Hyperwiper/Hyperwiper/hardware/Hyperwiper 2020/Screenshot from 2020-07-30 18-22-11.png

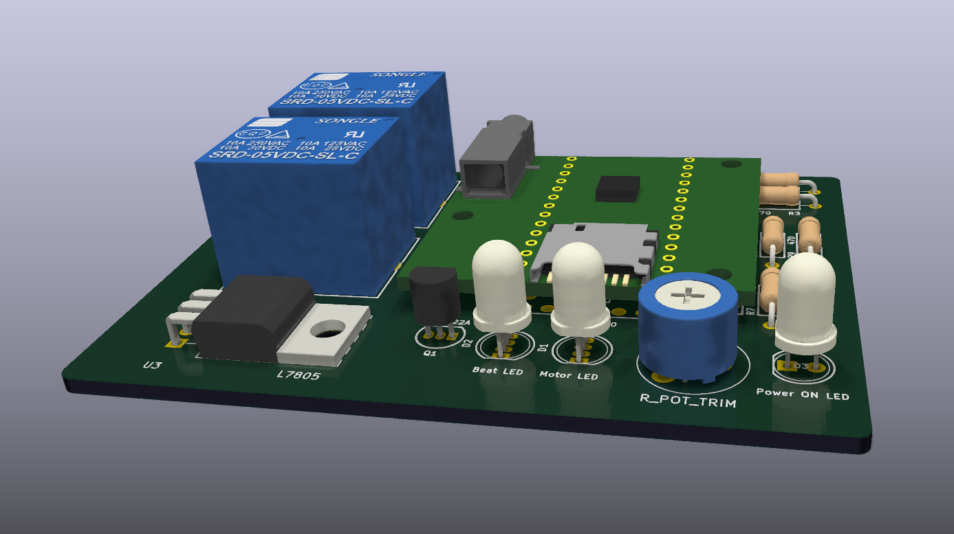
hardware/Hyperwiper 2020/Screenshot from 2020-07-30 18-22-11.png
