Hyperwiper/Hyperwiper/hardware/Hyperwiper 2020 production prototype/2020-07-30 Hyperwiper 3D board draft.png

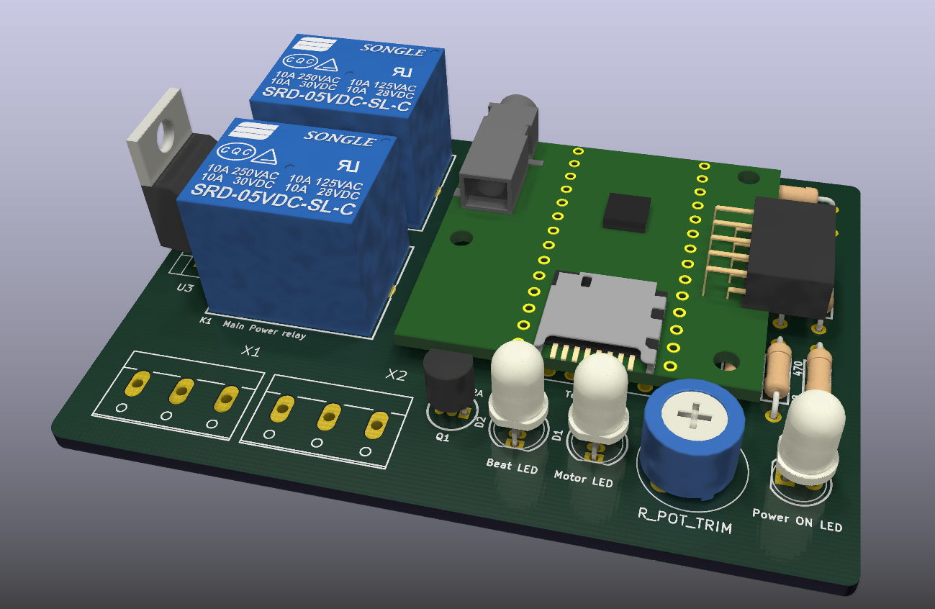
hardware/Hyperwiper 2020 production prototype/2020-07-30 Hyperwiper 3D board draft.png
