Hyperwiper/Hyperwiper/docs/2020 presentation /Hyper wiper audio timing flow chart.png

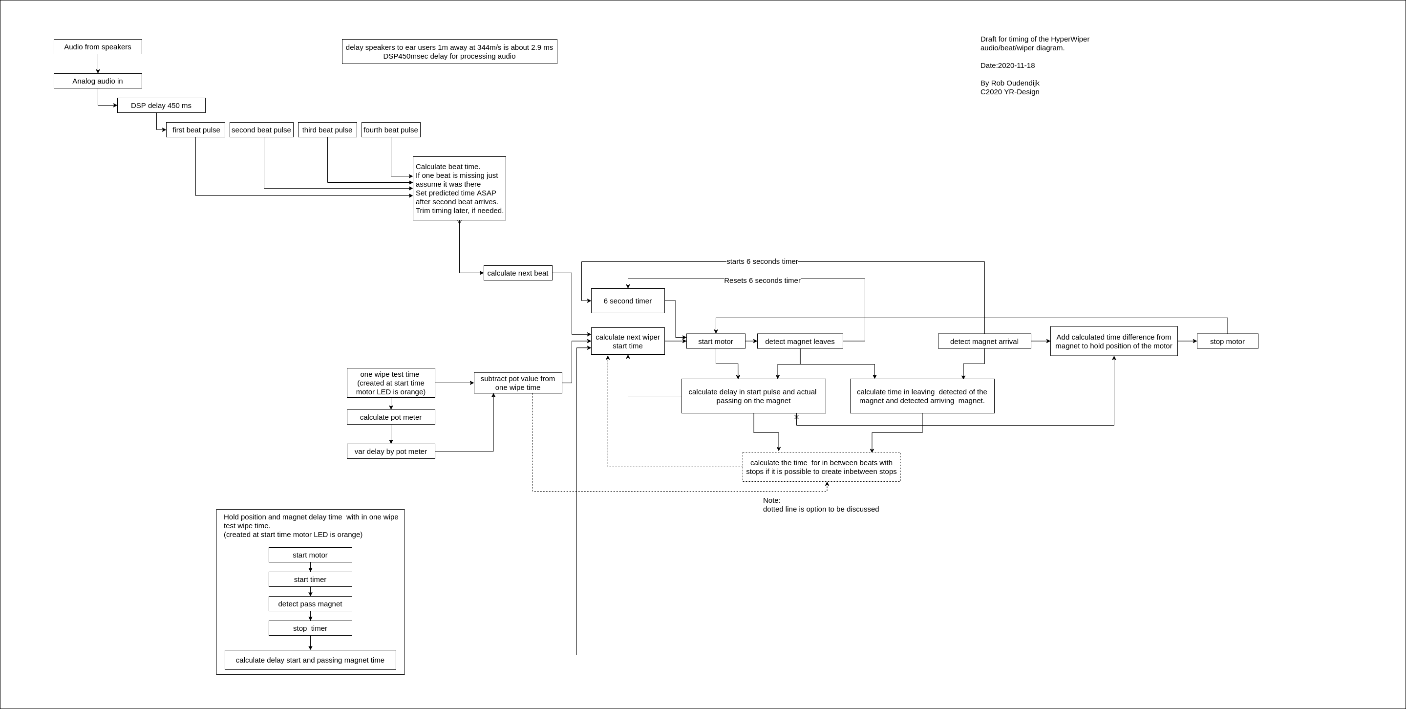
docs/2020 presentation /Hyper wiper audio timing flow chart.png
