Hyperwiper/Hyperwiper/docs/2020 presentation /hyperwiper timing graph main.jpg

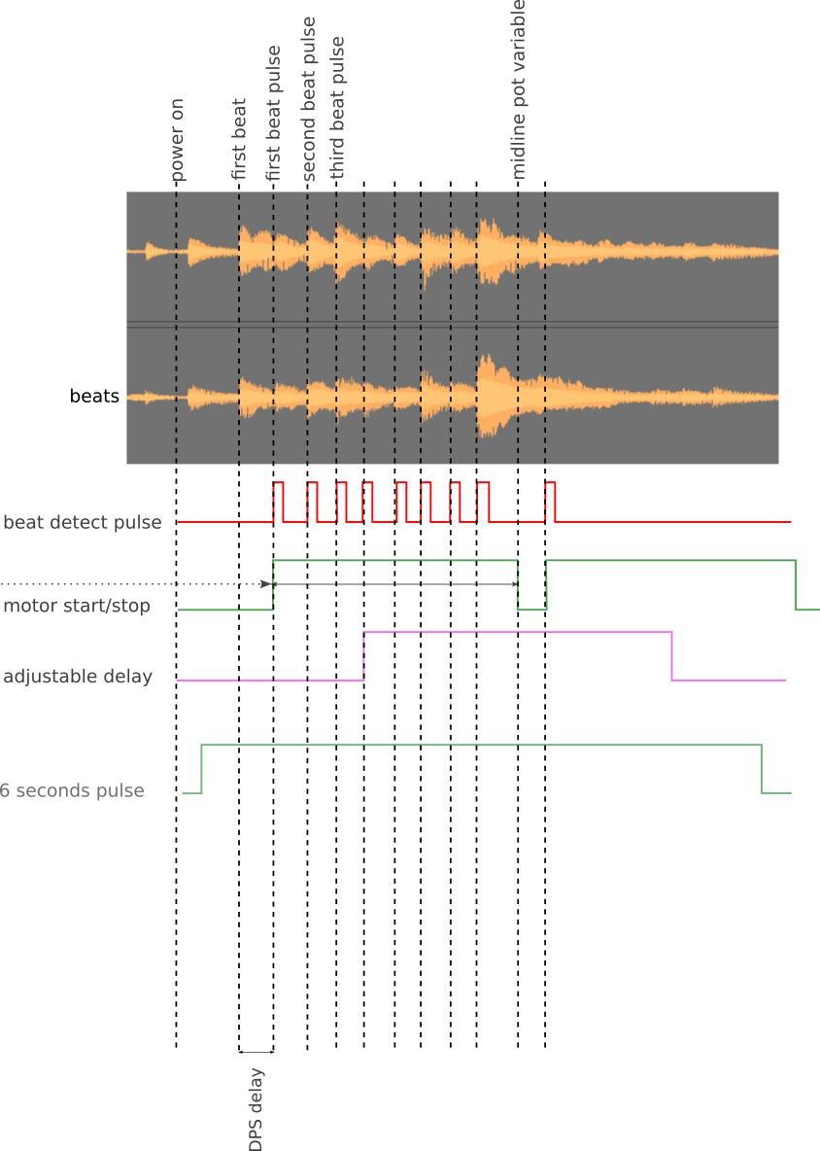
docs/2020 presentation /hyperwiper timing graph main.jpg
