Hyperwiper/Hyperwiper/docs/2020 presentation /hyperwiper timing graph start wipe.jpg

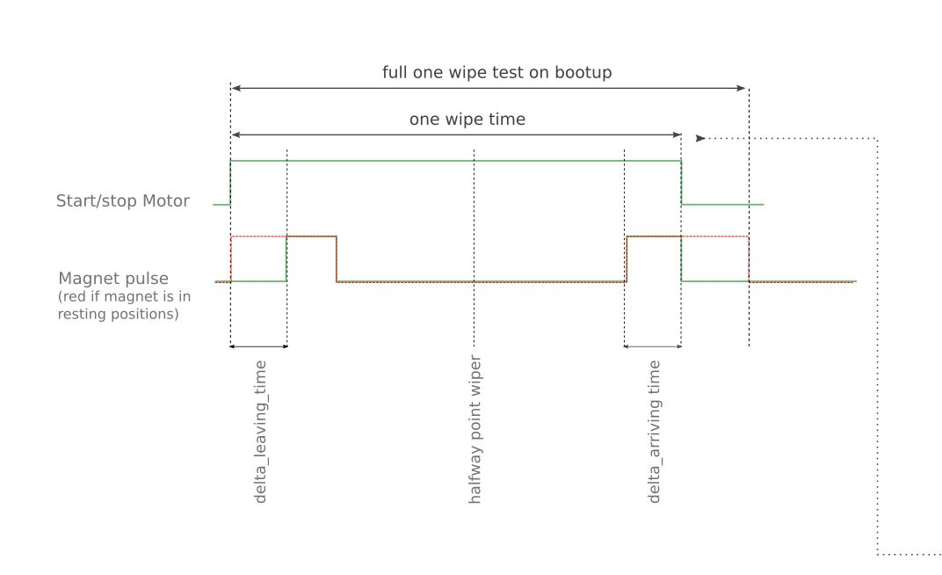
docs/2020 presentation /hyperwiper timing graph start wipe.jpg
