Hyperwiper/Hyperwiper/docs/2020 presentation /S1800002.jpg

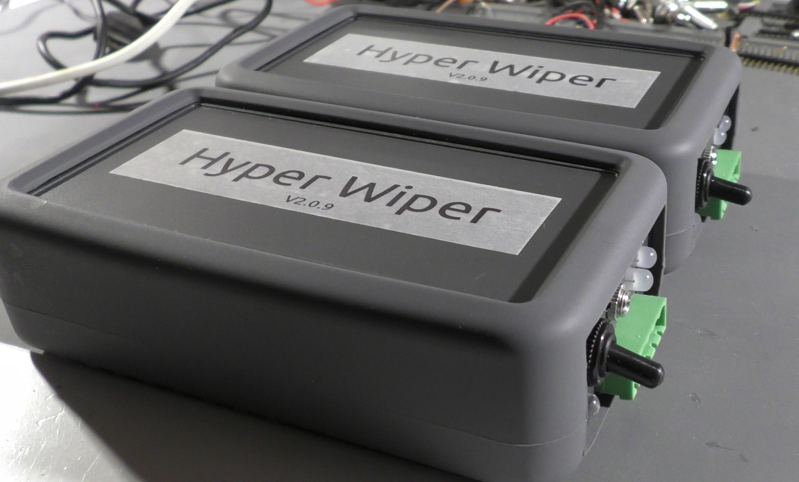
docs/2020 presentation /S1800002.jpg
