Hyperwiper/Hyperwiper/docs/2020 presentation /Screenshot from 2020-10-21 20-43-20.png

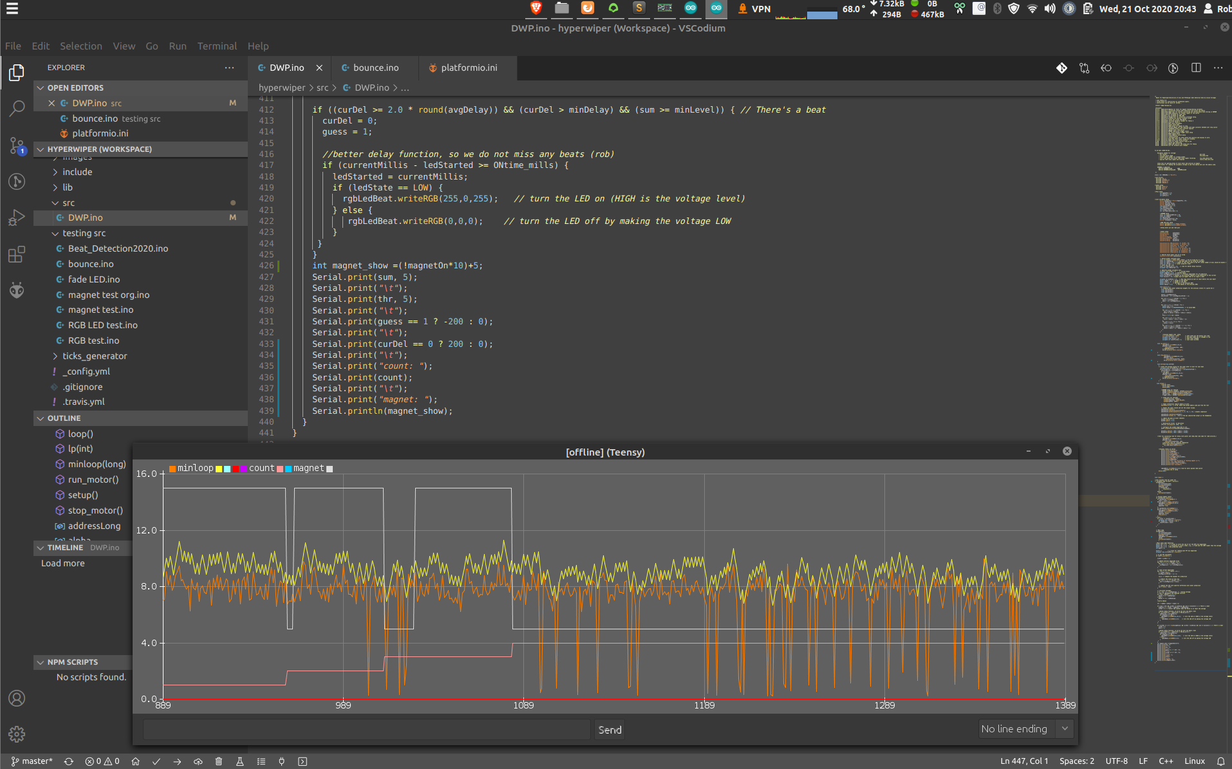
docs/2020 presentation /Screenshot from 2020-10-21 20-43-20.png
