Hyperwiper/Hyperwiper/docs/2020 presentation /Screenshot from 2020-11-02 18-30-22.png

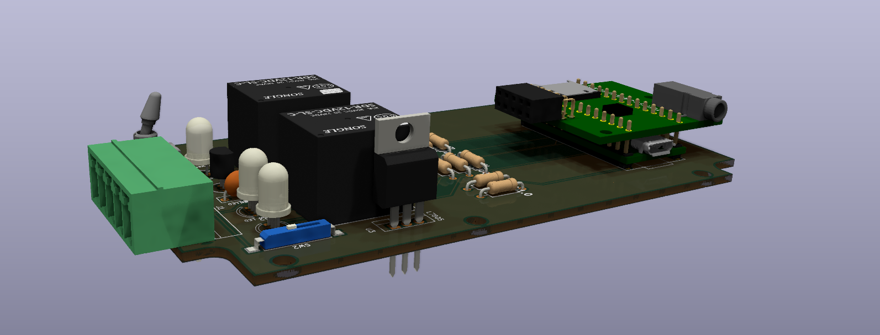
docs/2020 presentation /Screenshot from 2020-11-02 18-30-22.png
