Hyperwiper/Hyperwiper/docs/Hyper wiper audio timing.png

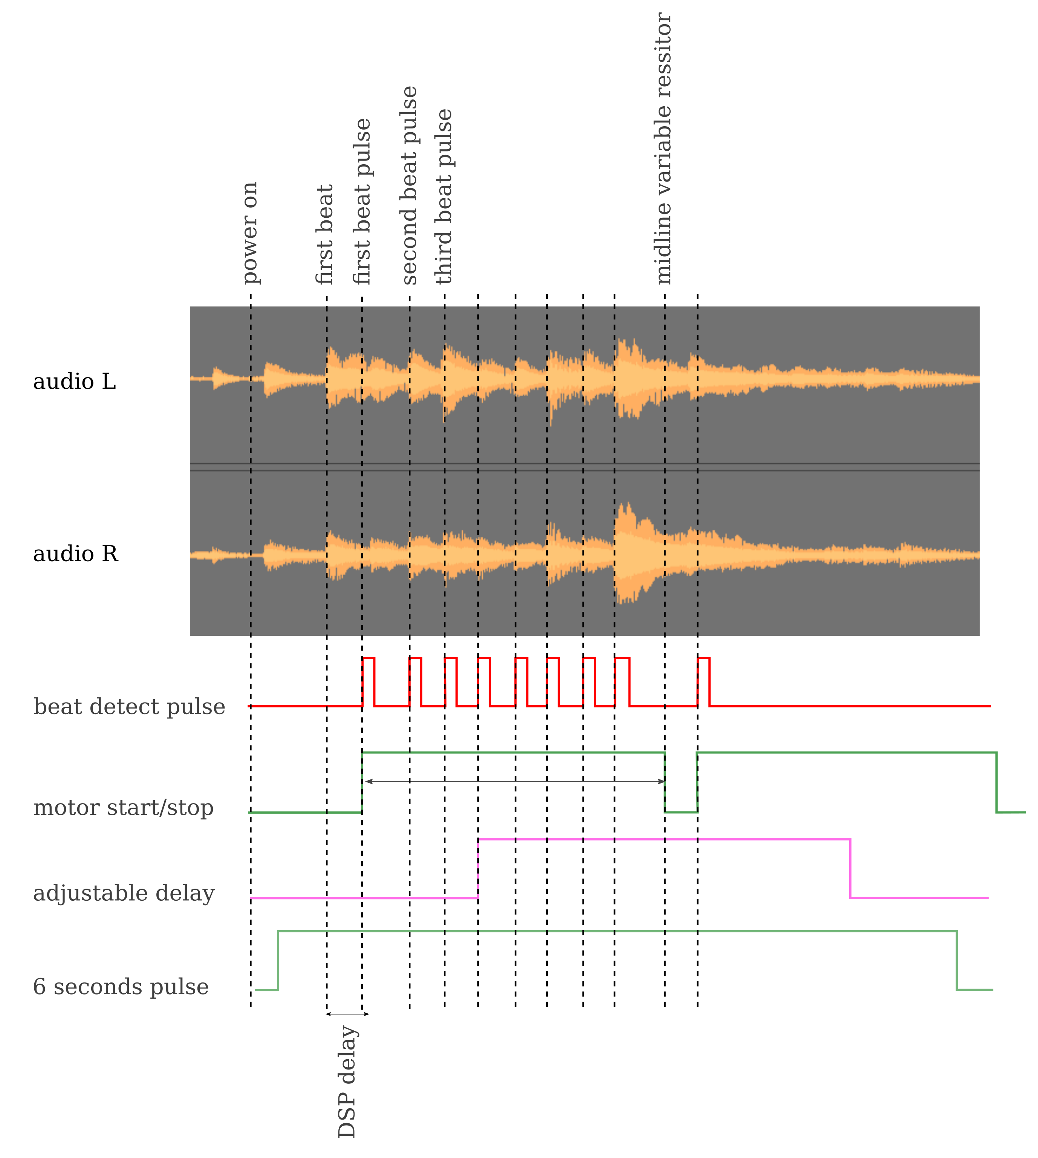
docs/Hyper wiper audio timing.png
