Hyperwiper/Hyperwiper/docs/Hyperwiper Timing graph main corrected.png

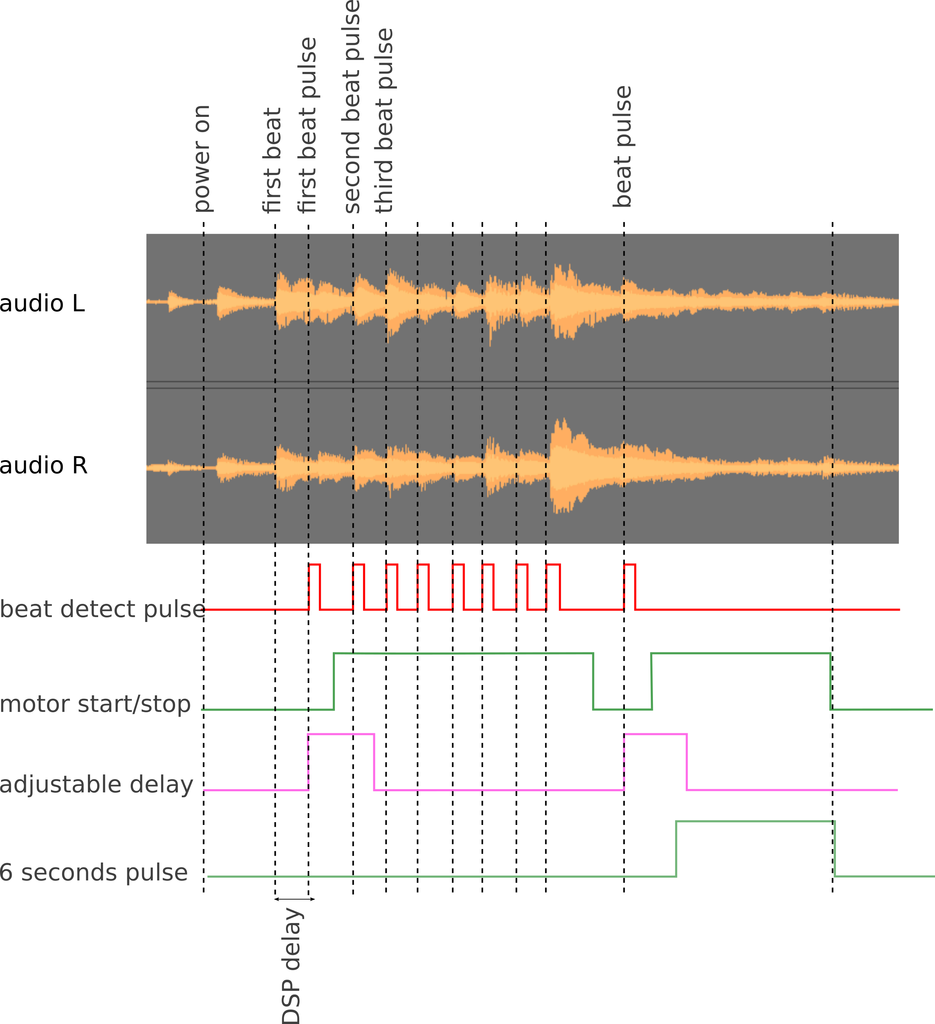
docs/Hyperwiper Timing graph main corrected.png
