Hyperwiper/Hyperwiper/docs/main loop flow chart new.jpg

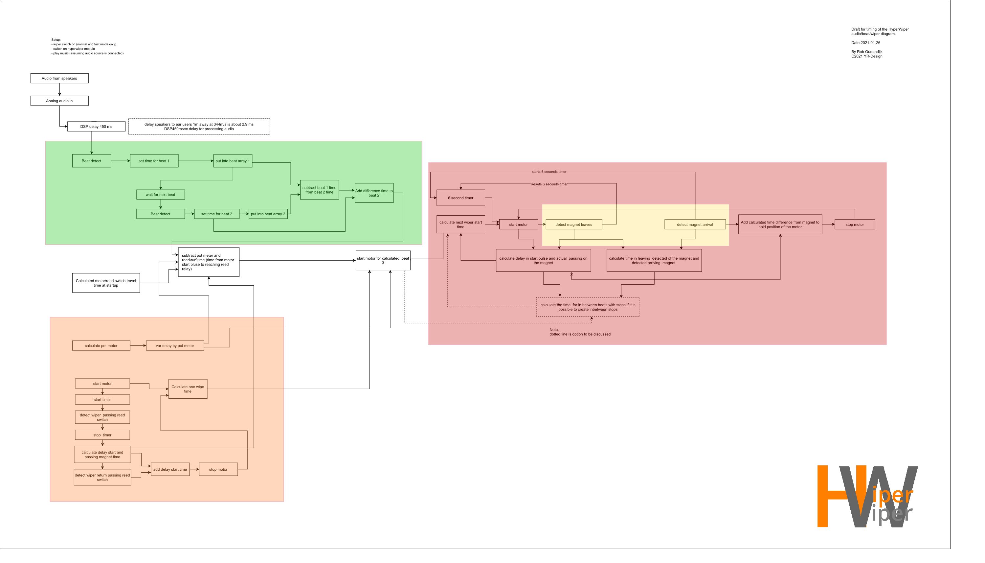
docs/main loop flow chart new.jpg
