Hyperwiper/Hyperwiper/docs/main loop flowchart.png

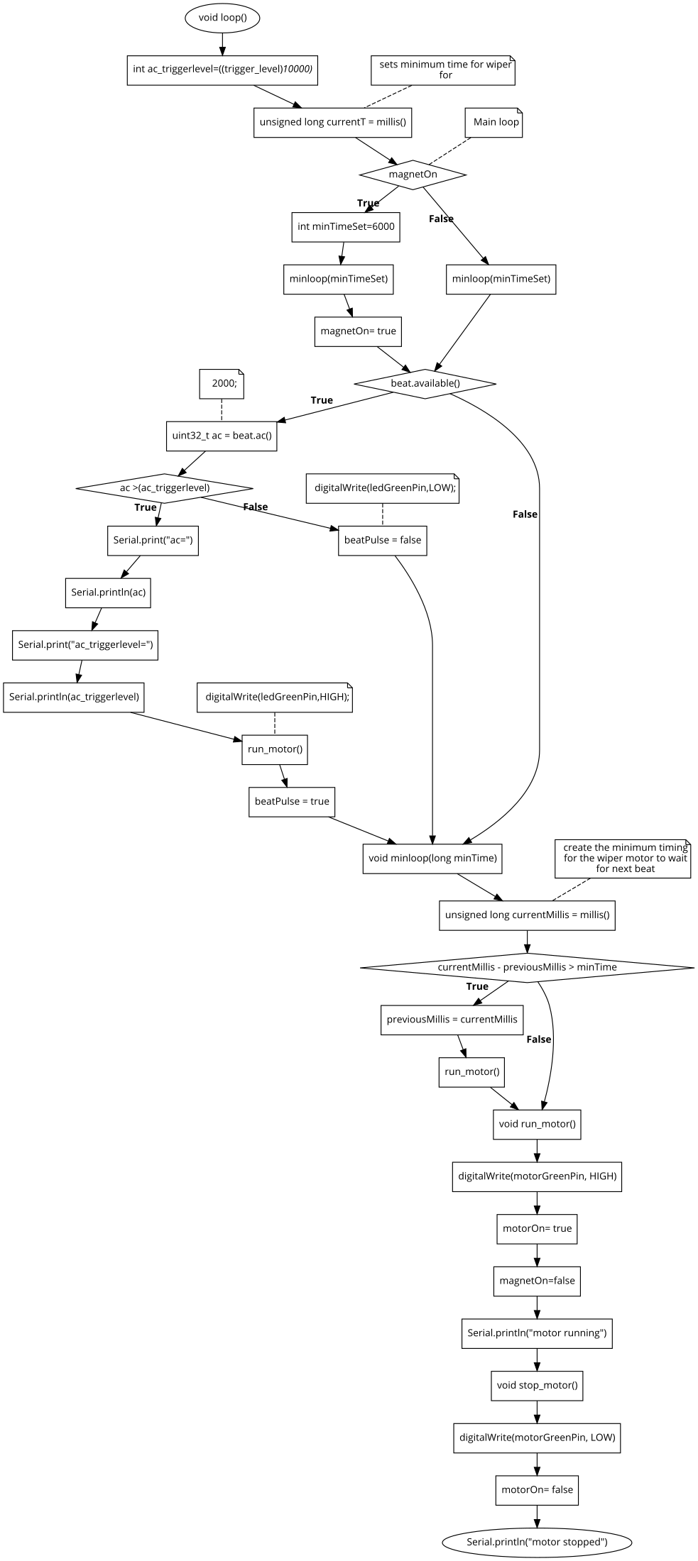
docs/main loop flowchart.png
