Hyperwiper/Hyperwiper/docs/timing plots.jpg

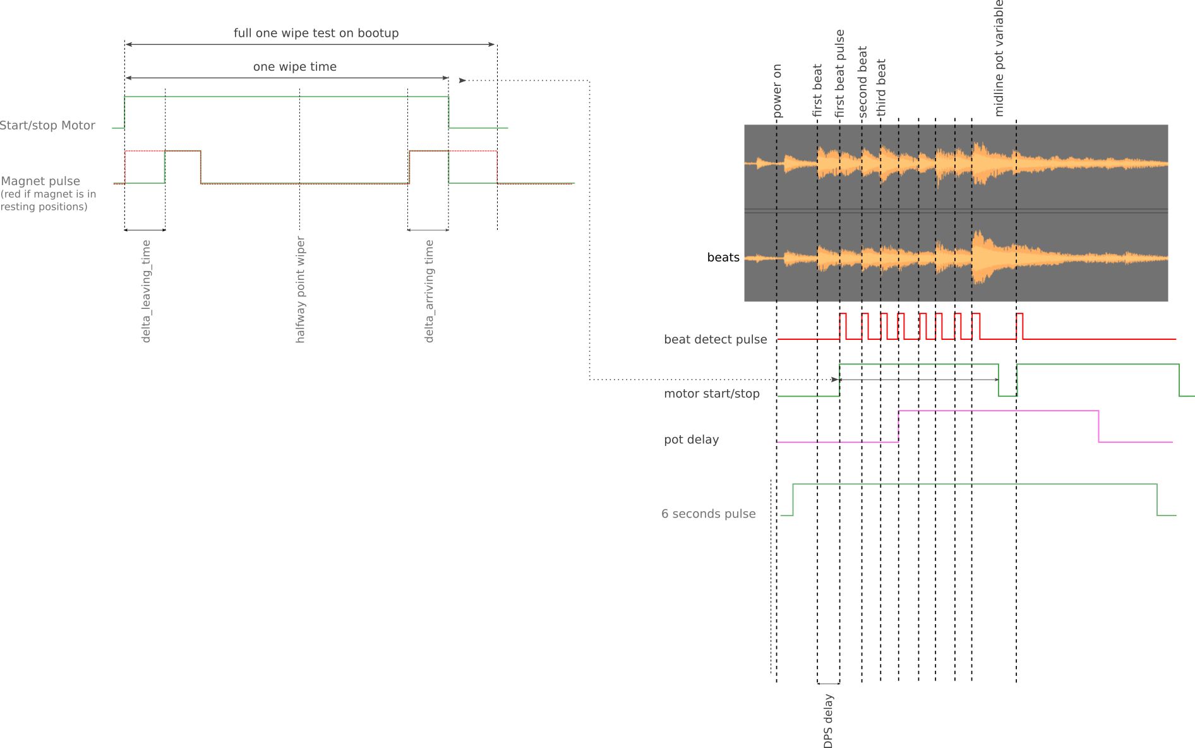
docs/timing plots.jpg
