Hyperwiper/Hyperwiper/hardware/Hyperwiper 2020 production prototype/hyperwiper board V2.0.1.png

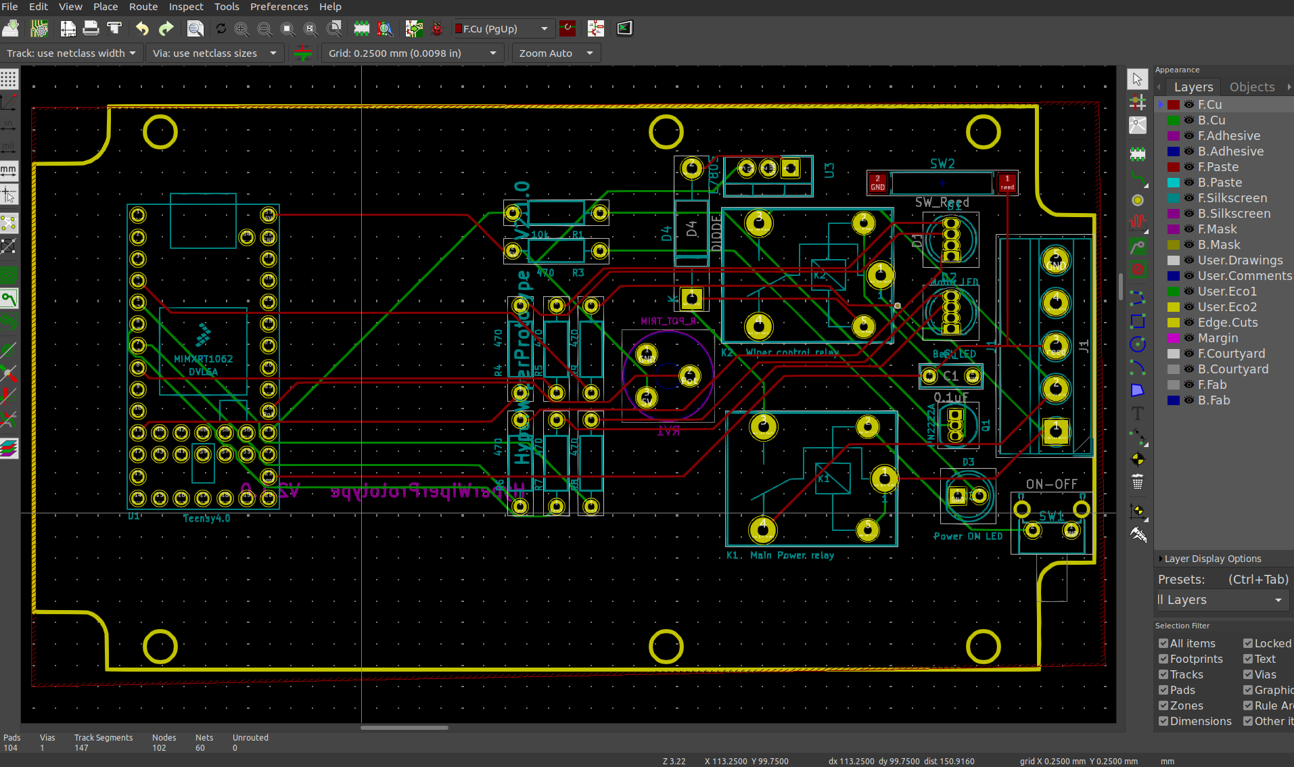
hardware/Hyperwiper 2020 production prototype/hyperwiper board V2.0.1.png
