Hyperwiper/Hyperwiper/hardware/Hyperwiper 2020/Screenshot from 2020-07-30 18-21-21.png

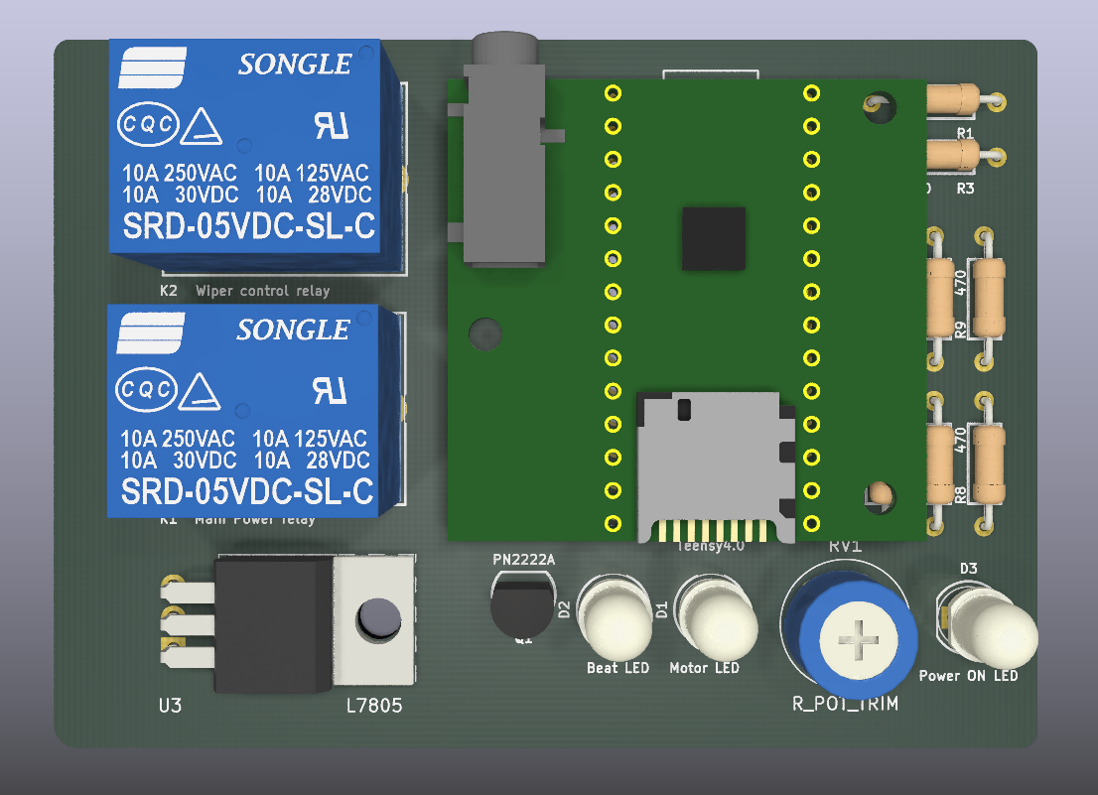
hardware/Hyperwiper 2020/Screenshot from 2020-07-30 18-21-21.png
