Hyperwiper/Hyperwiper/html/_audio_8h__incl.png

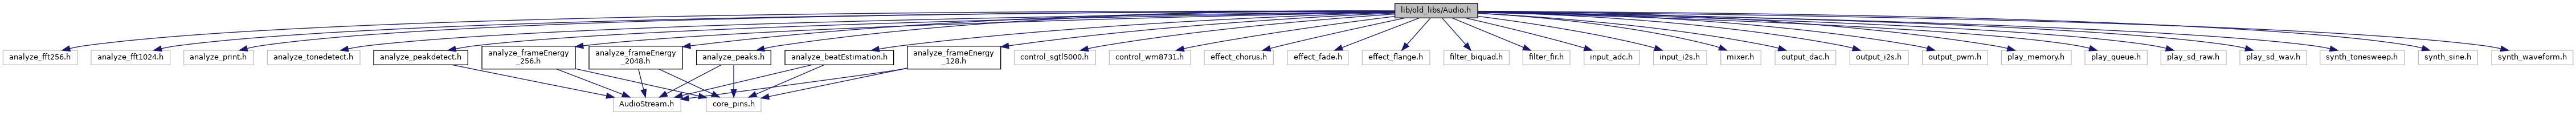
html/_audio_8h__incl.png
