Hyperwiper/Hyperwiper/html/analyze__beat_estimation_8cpp__incl.png

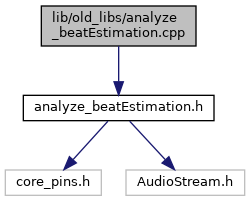
html/analyze__beat_estimation_8cpp__incl.png
