Hyperwiper/Hyperwiper/html/analyze__beat_estimation_8h__dep__incl.png

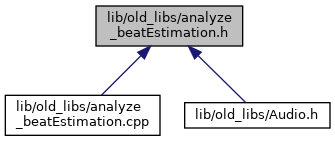
html/analyze__beat_estimation_8h__dep__incl.png
