Hyperwiper/Hyperwiper/html/analyze__frame_energy__128_8cpp__incl.png

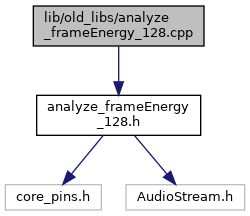
html/analyze__frame_energy__128_8cpp__incl.png
