Hyperwiper/Hyperwiper/html/analyze__frame_energy__128_8h__incl.png

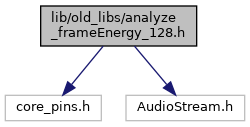
html/analyze__frame_energy__128_8h__incl.png
