Hyperwiper/Hyperwiper/html/analyze__odf_8cpp__incl.png

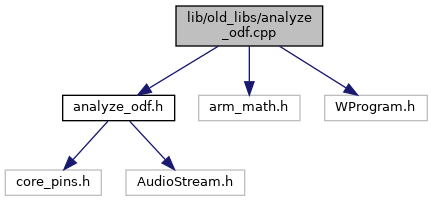
html/analyze__odf_8cpp__incl.png
