Hyperwiper/Hyperwiper/html/analyze__odf_8h__dep__incl.png

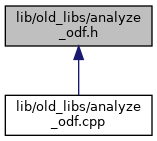
html/analyze__odf_8h__dep__incl.png
