Hyperwiper/Hyperwiper/html/analyze__peakdetect_8h__dep__incl.png

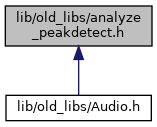
html/analyze__peakdetect_8h__dep__incl.png
