Hyperwiper/Hyperwiper/html/analyze__peaks_8cpp__incl.png

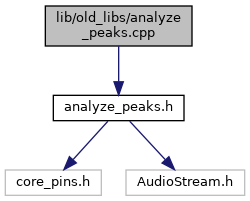
html/analyze__peaks_8cpp__incl.png
