Hyperwiper/Hyperwiper/html/analyze__peaks_8h__dep__incl.png

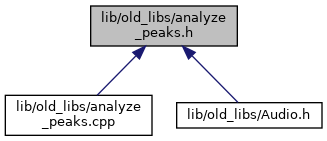
html/analyze__peaks_8h__dep__incl.png
