Hyperwiper/Hyperwiper/html/class_r_g_b_l_e_d_a7187613949b43864e4af7c2d3055ac1e_cgraph.png

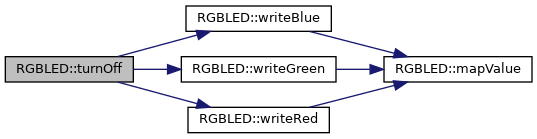
html/class_r_g_b_l_e_d_a7187613949b43864e4af7c2d3055ac1e_cgraph.png
