Hyperwiper/Hyperwiper/html/class_r_g_b_l_e_d_ac804eba7768dfe133c931208c67d0d79_cgraph.png

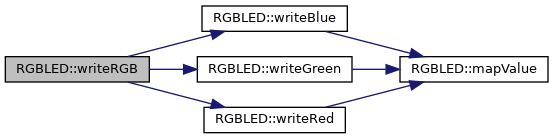
html/class_r_g_b_l_e_d_ac804eba7768dfe133c931208c67d0d79_cgraph.png
