Hyperwiper/Hyperwiper/html/inherit_graph_0.png

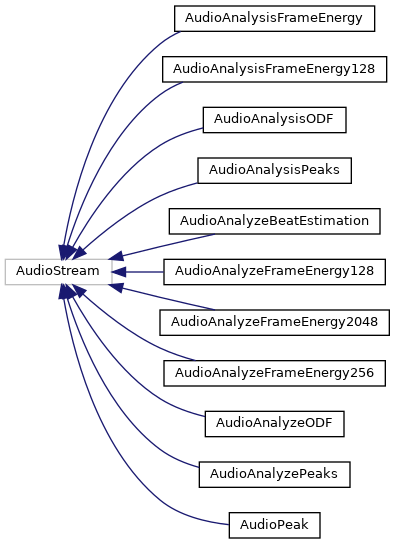
html/inherit_graph_0.png
