Hyperwiper/Hyperwiper/html/odf_8cpp__incl.png

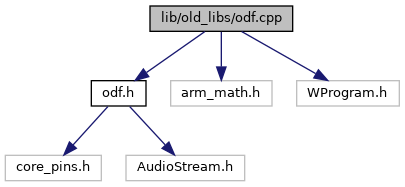
html/odf_8cpp__incl.png
