Hyperwiper/Hyperwiper/html/onset__detection_8cpp__incl.png

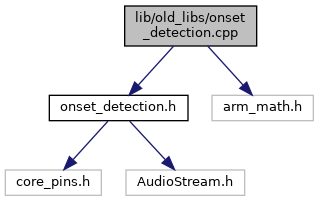
html/onset__detection_8cpp__incl.png
