Hyperwiper/Hyperwiper/html/onset__detection_8h__dep__incl.png

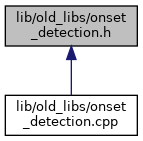
html/onset__detection_8h__dep__incl.png
