Hyperwiper/Hyperwiper/html/onset__detection__128_8cpp__incl.png

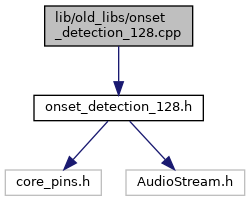
html/onset__detection__128_8cpp__incl.png
