Hyperwiper/Hyperwiper/html/onset__detection__128_8h__dep__incl.png

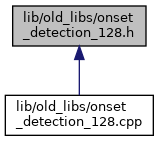
html/onset__detection__128_8h__dep__incl.png
