Hyperwiper/Hyperwiper/html/onset__detection__128_8h__incl.png

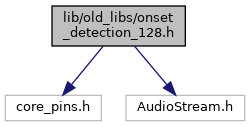
html/onset__detection__128_8h__incl.png
