Hyperwiper/Hyperwiper/html/peaks_8cpp__incl.png

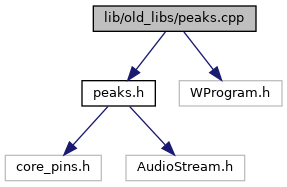
html/peaks_8cpp__incl.png
