Hyperwiper/Hyperwiper/Images/Car_pictures/Fuses_Left_Side.jpg

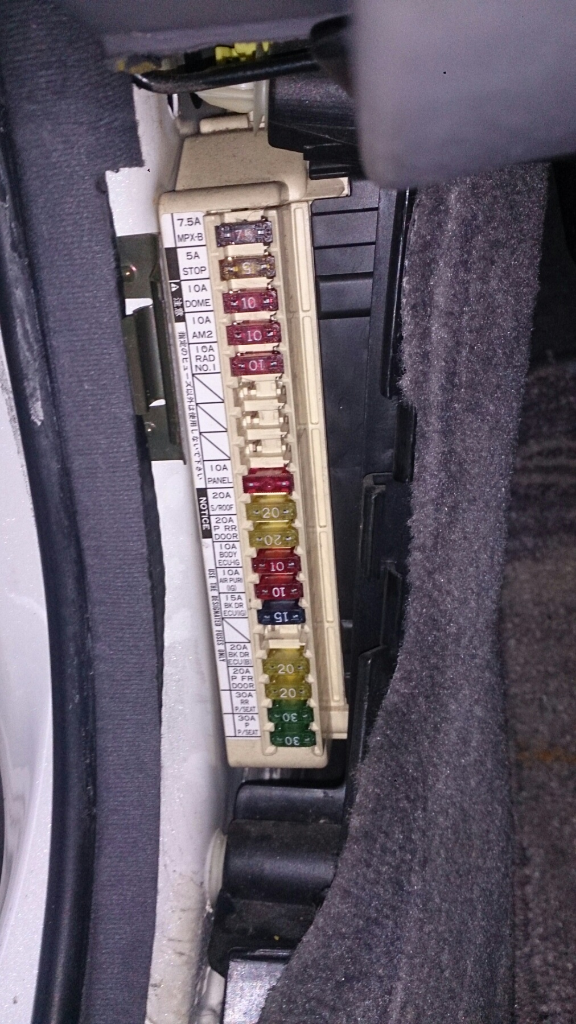
Images/Car_pictures/Fuses_Left_Side.jpg
