Hyperwiper/Hyperwiper/Images/Car_pictures/Fuses_Right_Side.jpg

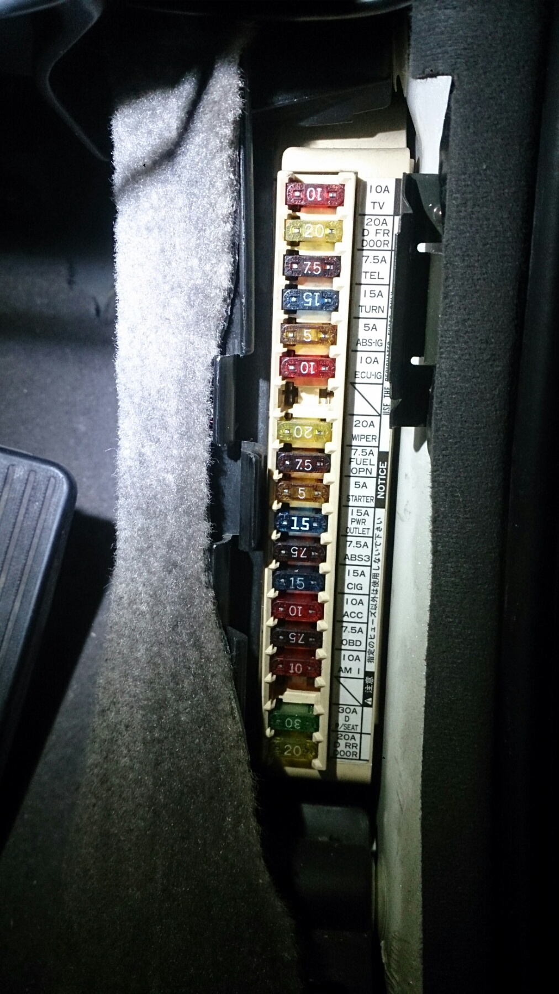
Images/Car_pictures/Fuses_Right_Side.jpg
