Hyperwiper/Hyperwiper/Images/connector wires explained.jpg

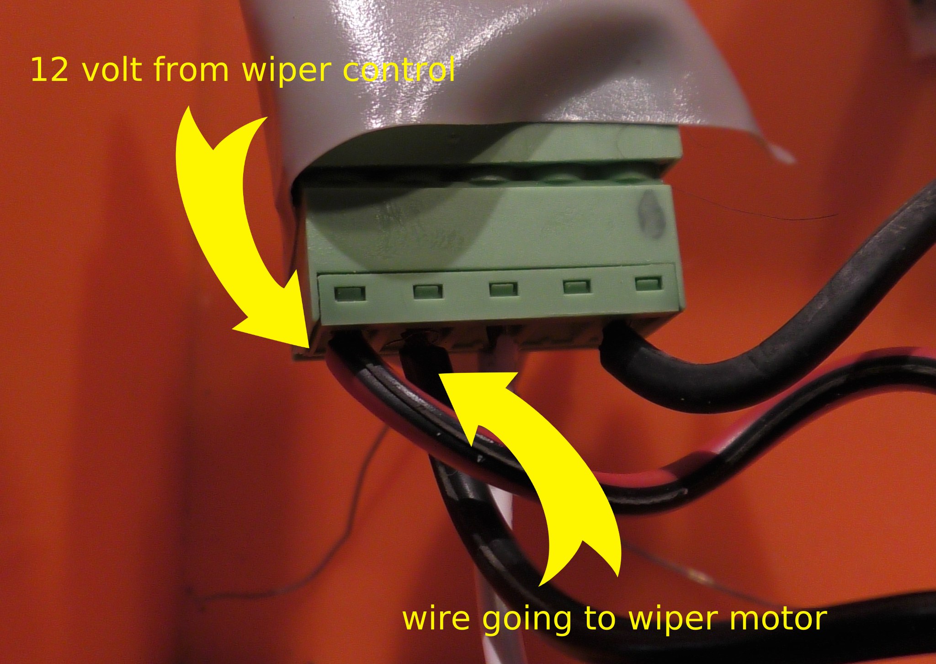
Images/connector wires explained.jpg
