Hyperwiper/Hyperwiper/Images/MechatronicsSectionFigures/circuit.png

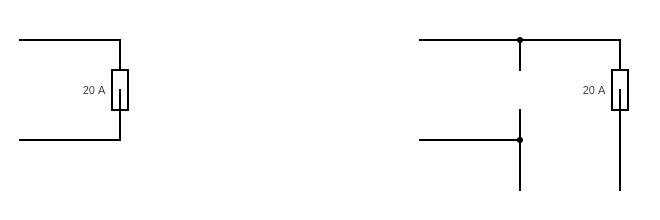
Images/MechatronicsSectionFigures/circuit.png
