Hyperwiper/Hyperwiper/Images/MechatronicsSectionFigures/circuit_edit.png

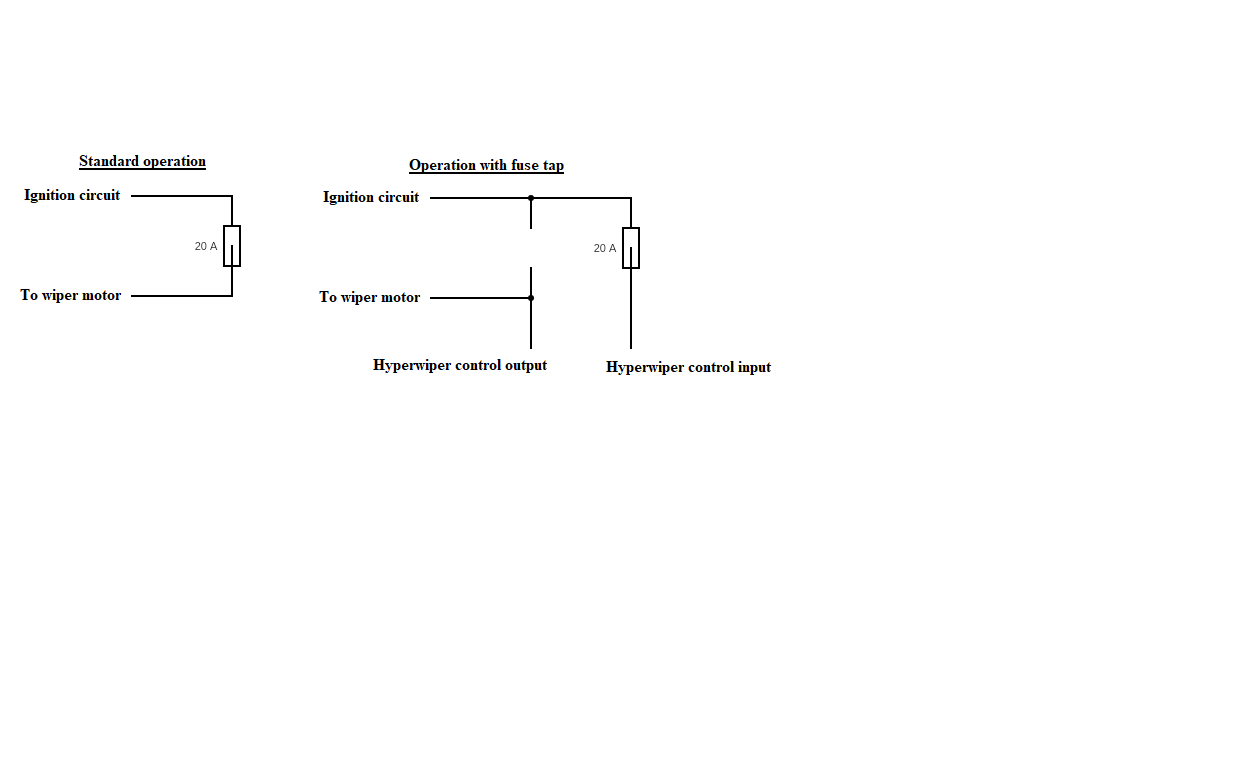
Images/MechatronicsSectionFigures/circuit_edit.png
