Hyperwiper/Hyperwiper/Images/MechatronicsSectionFigures/circuit_editv2.png

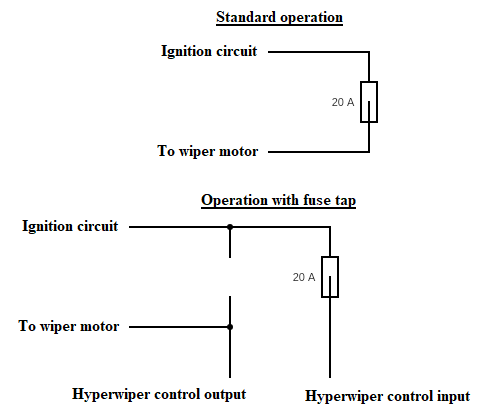
Images/MechatronicsSectionFigures/circuit_editv2.png
