Hyperwiper/Hyperwiper/Images/MechatronicsSectionFigures/dashboard.png

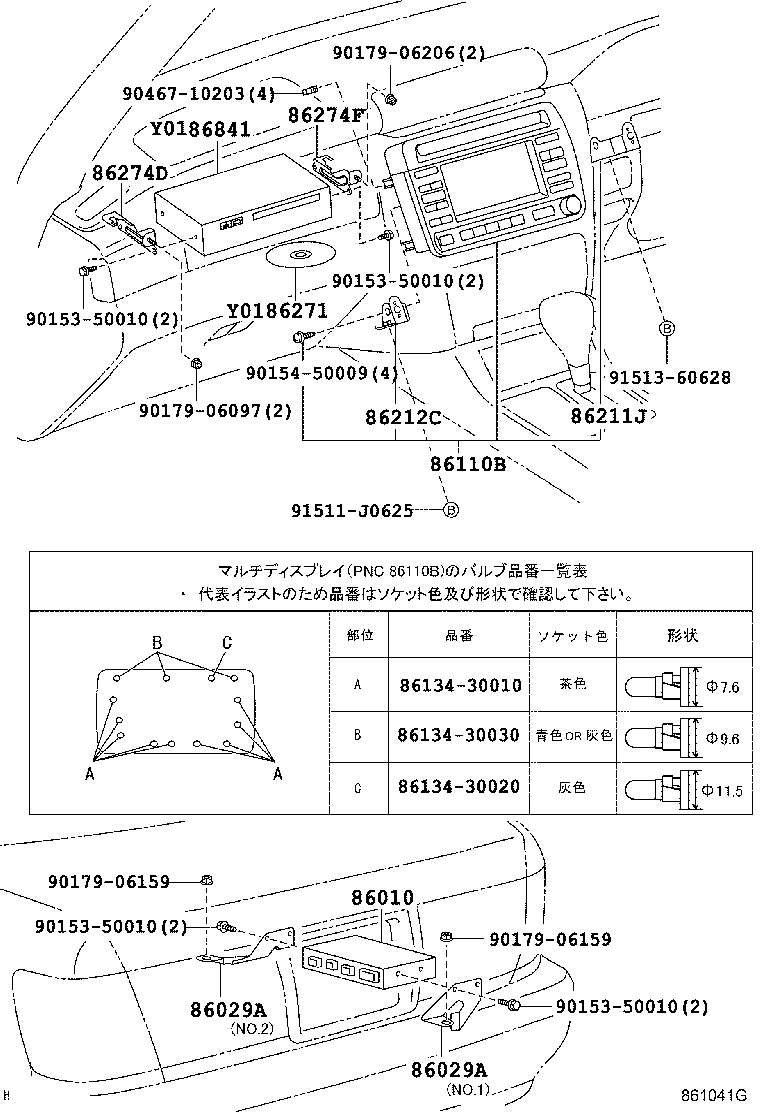
Images/MechatronicsSectionFigures/dashboard.png
