Hyperwiper/Hyperwiper/Images/MechatronicsSectionFigures/DoorHarness.png

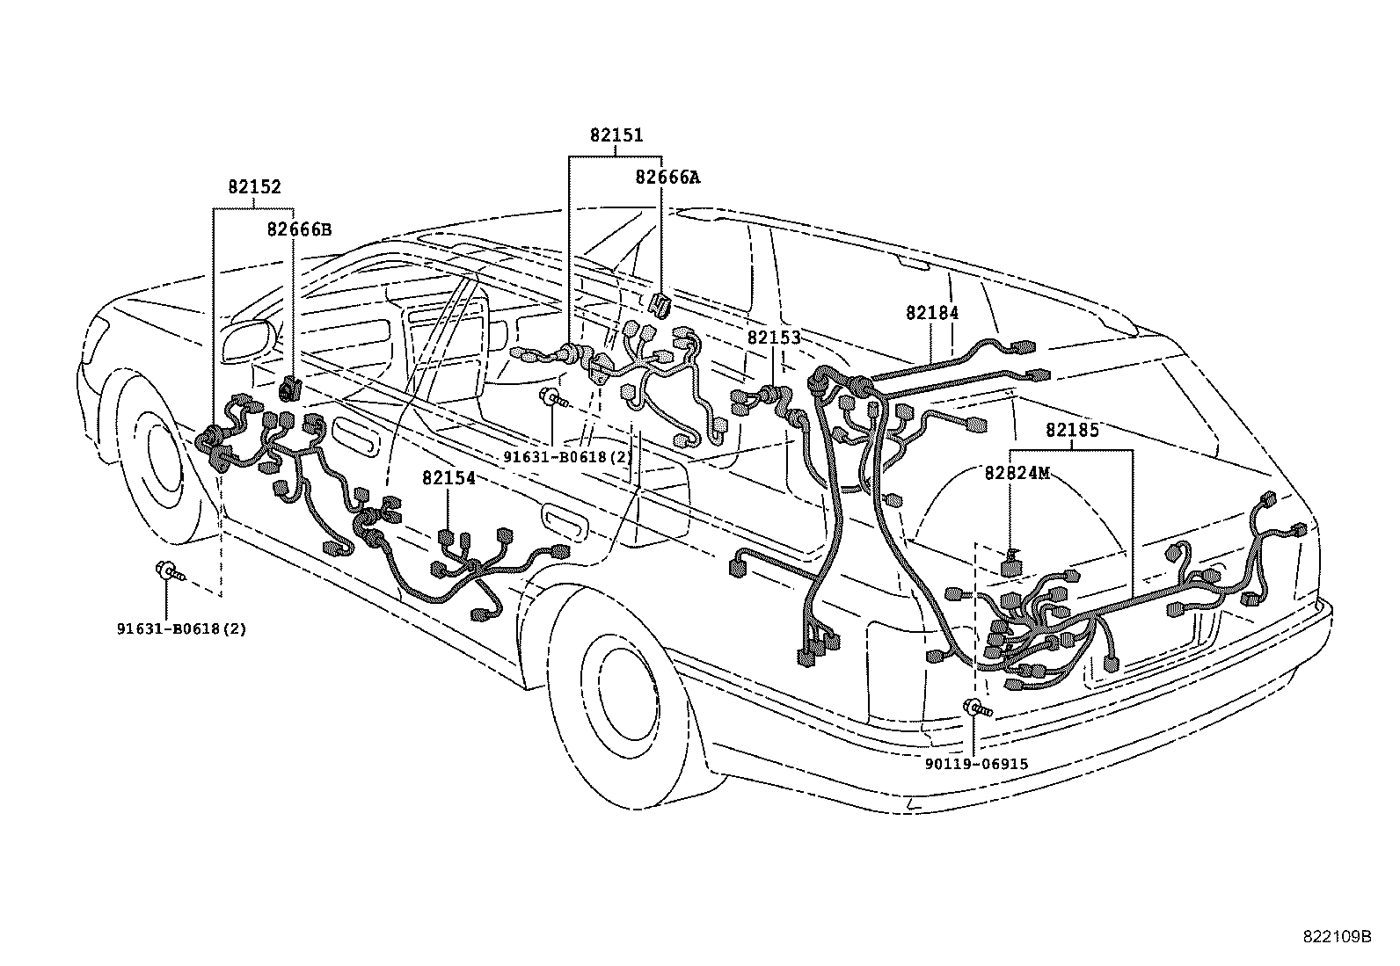
Images/MechatronicsSectionFigures/DoorHarness.png
