Hyperwiper/Hyperwiper/Images/MechatronicsSectionFigures/DoorHarness_editv7.png

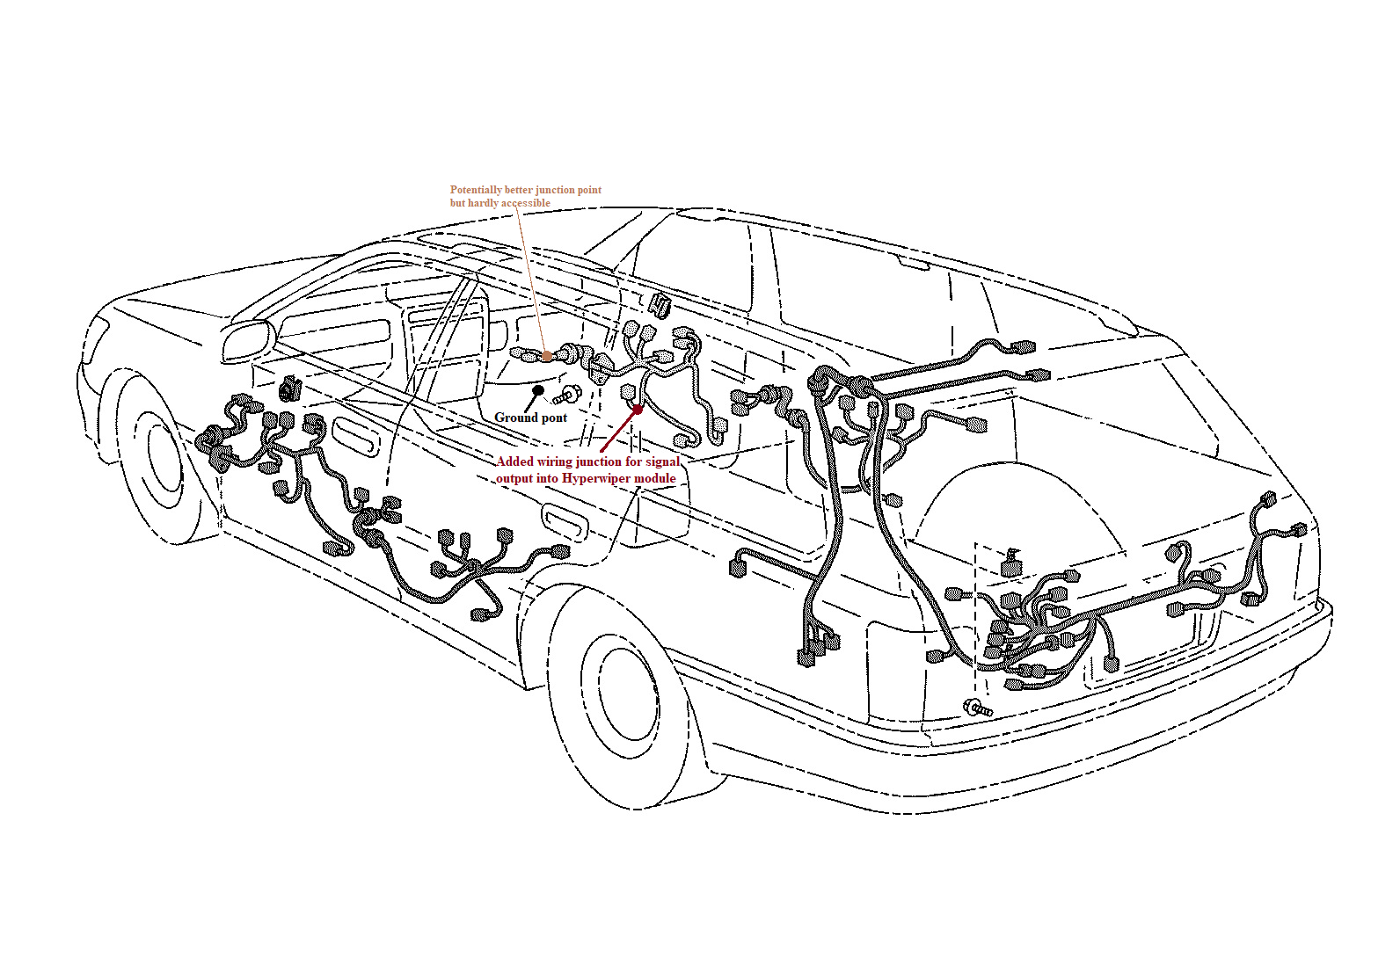
Images/MechatronicsSectionFigures/DoorHarness_editv7.png
