Hyperwiper/Hyperwiper/Images/MechatronicsSectionFigures/Firewall.png

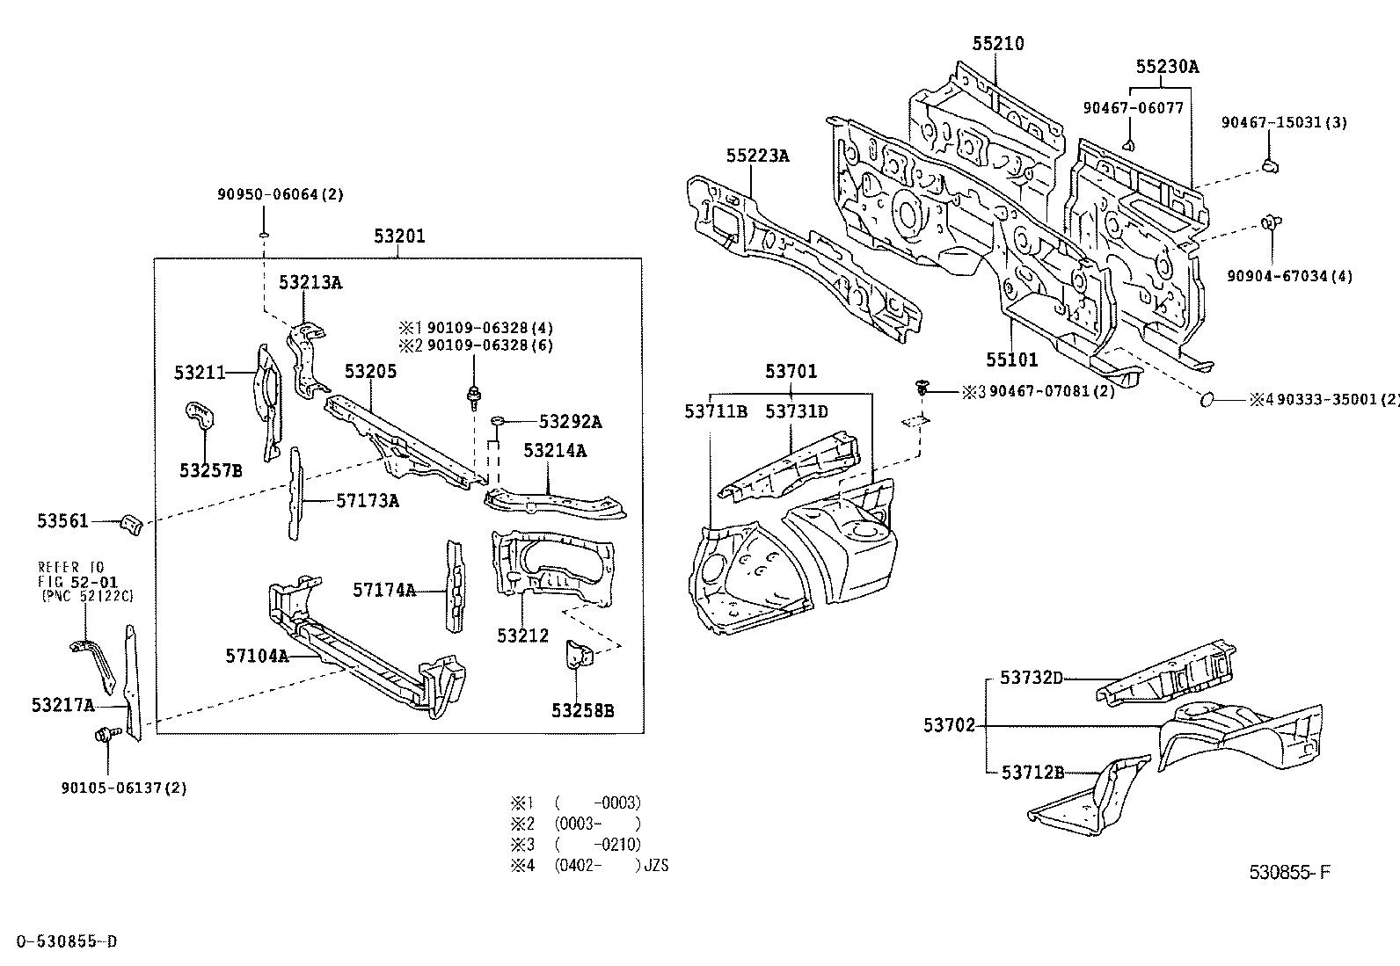
Images/MechatronicsSectionFigures/Firewall.png
