Hyperwiper/Hyperwiper/Images/MechatronicsSectionFigures/Firewall_edit.png

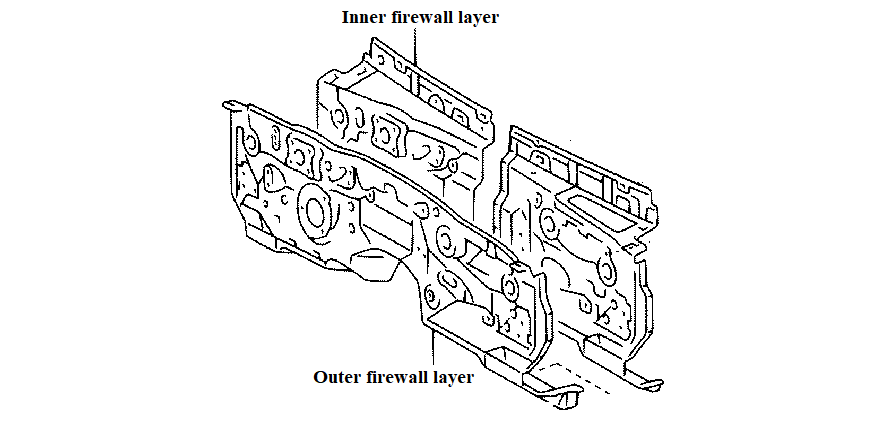
Images/MechatronicsSectionFigures/Firewall_edit.png
