Hyperwiper/Hyperwiper/Images/MechatronicsSectionFigures/Firewall_editv3.png

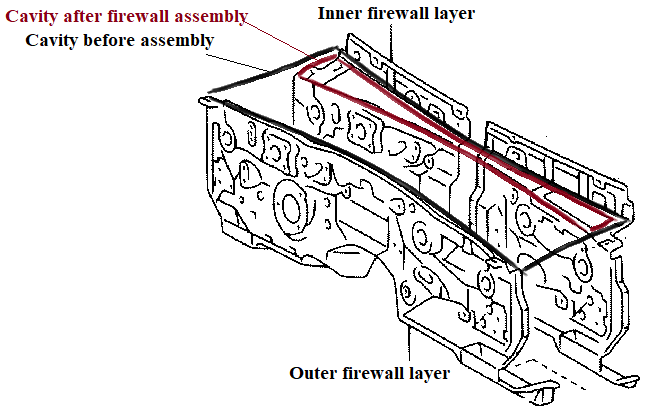
Images/MechatronicsSectionFigures/Firewall_editv3.png
