Hyperwiper/Hyperwiper/Images/MechatronicsSectionFigures/fuse-tap.jpg

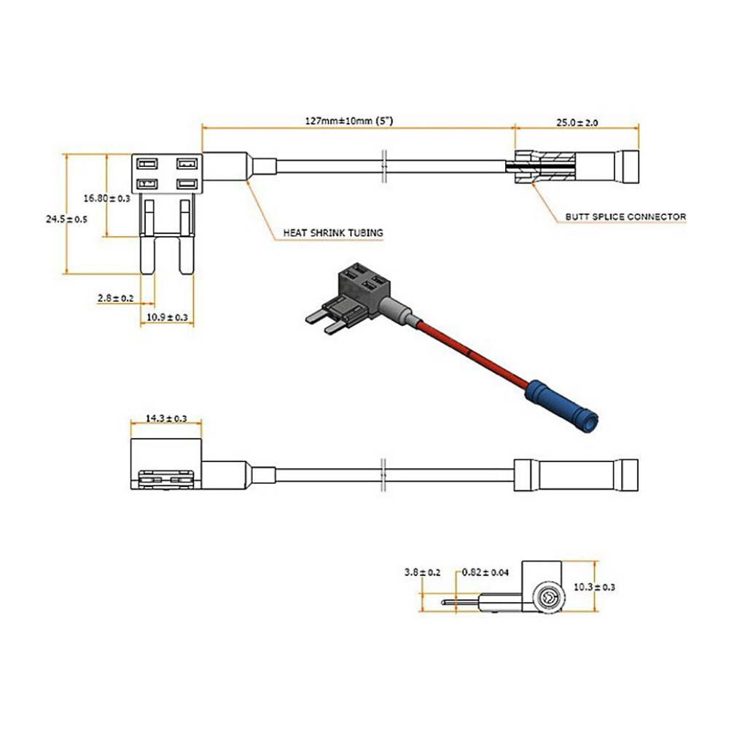
Images/MechatronicsSectionFigures/fuse-tap.jpg
