Hyperwiper/Hyperwiper/Images/MechatronicsSectionFigures/fuse-tap_edit.png

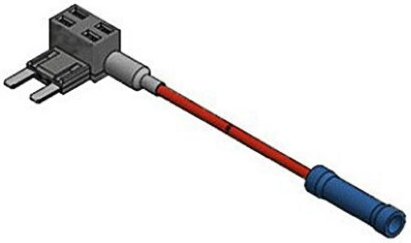
Images/MechatronicsSectionFigures/fuse-tap_edit.png
