Hyperwiper/Hyperwiper/Images/MechatronicsSectionFigures/FuseBlockPosition.png

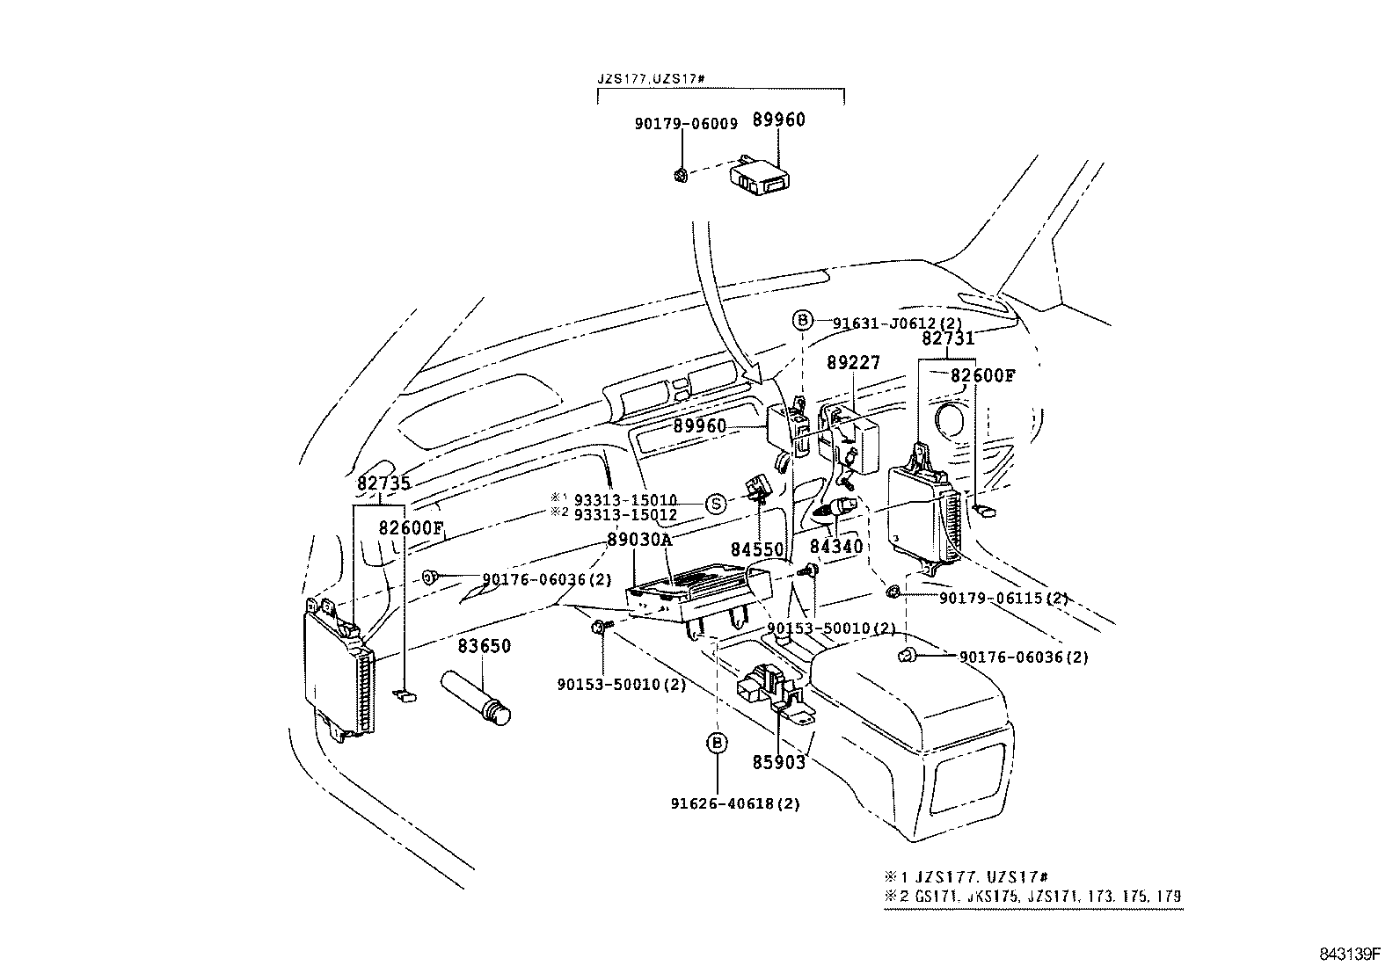
Images/MechatronicsSectionFigures/FuseBlockPosition.png
