Hyperwiper/Hyperwiper/Images/MechatronicsSectionFigures/FuseBlockPosition_edit.png

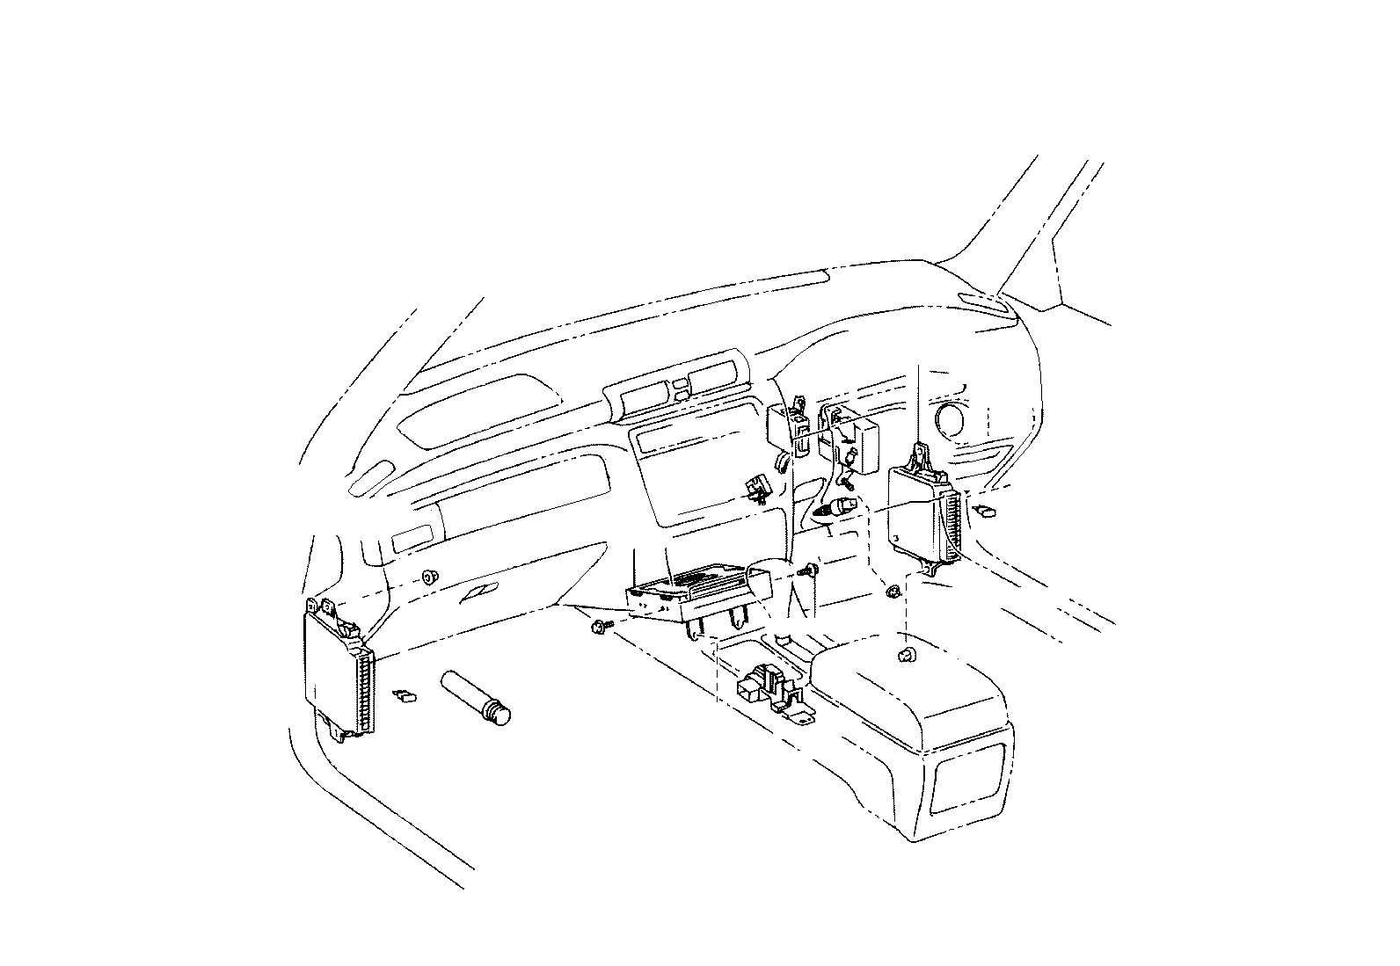
Images/MechatronicsSectionFigures/FuseBlockPosition_edit.png
