Hyperwiper/Hyperwiper/Images/MechatronicsSectionFigures/FuseBlockPosition_editv3.png

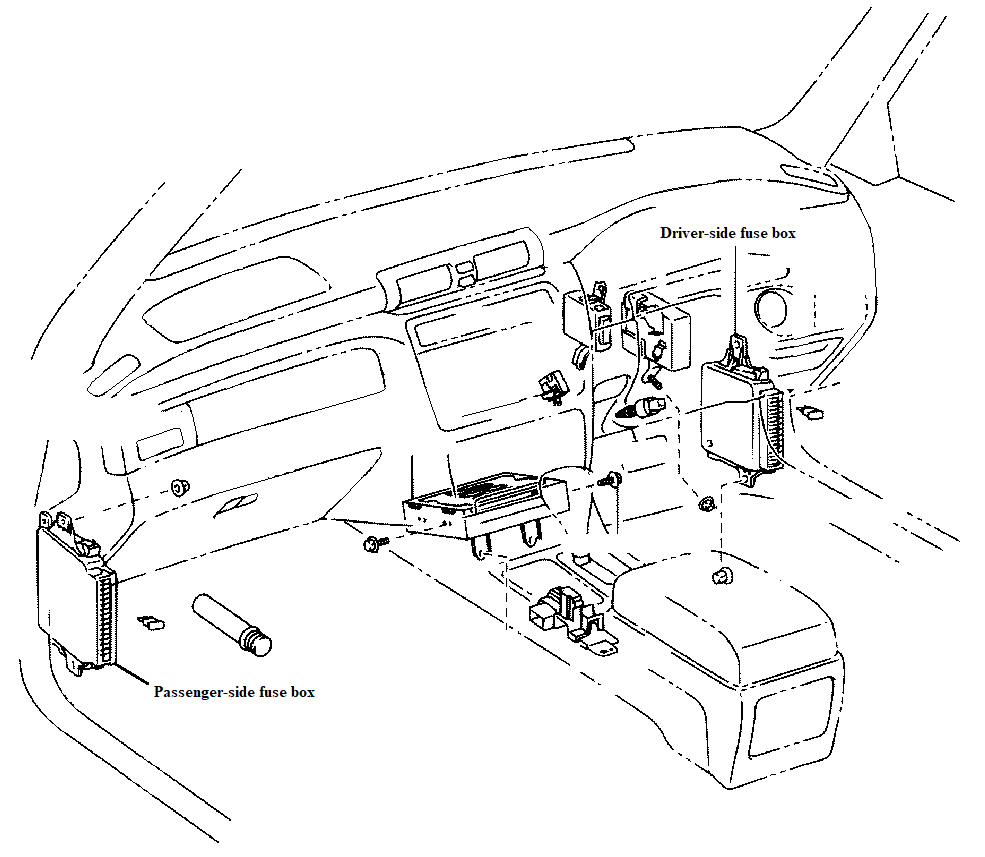
Images/MechatronicsSectionFigures/FuseBlockPosition_editv3.png
