Hyperwiper/Hyperwiper/Images/MechatronicsSectionFigures/LinkMechanism.png

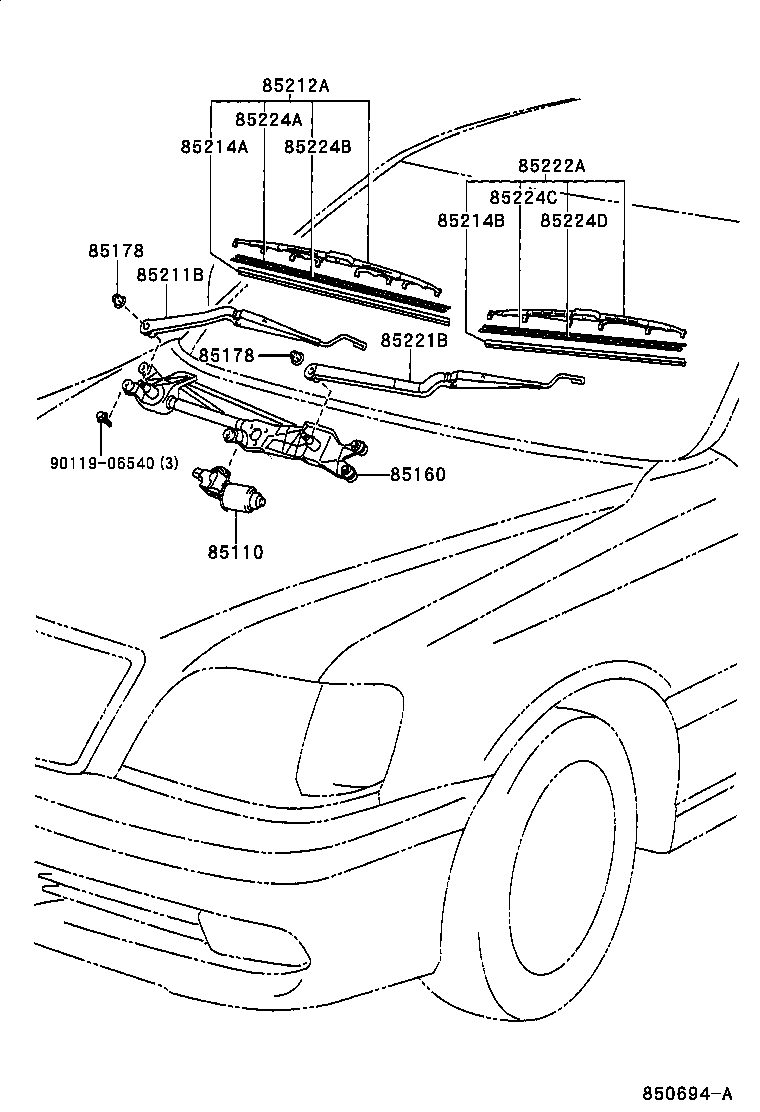
Images/MechatronicsSectionFigures/LinkMechanism.png
