Hyperwiper/Hyperwiper/Images/MechatronicsSectionFigures/LinkMechanism_edit.png

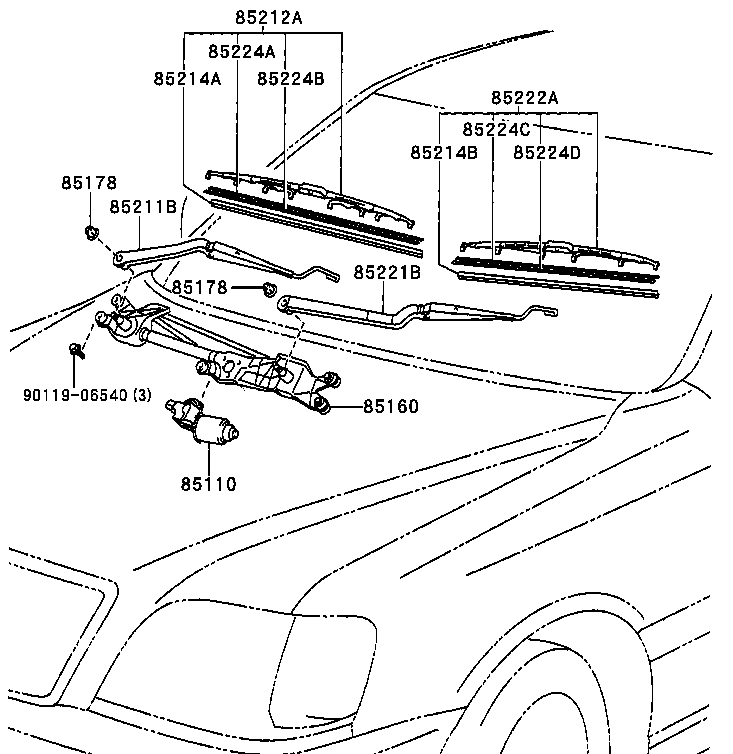
Images/MechatronicsSectionFigures/LinkMechanism_edit.png
