Hyperwiper/Hyperwiper/Images/MechatronicsSectionFigures/LinkMechanism_editv3.png

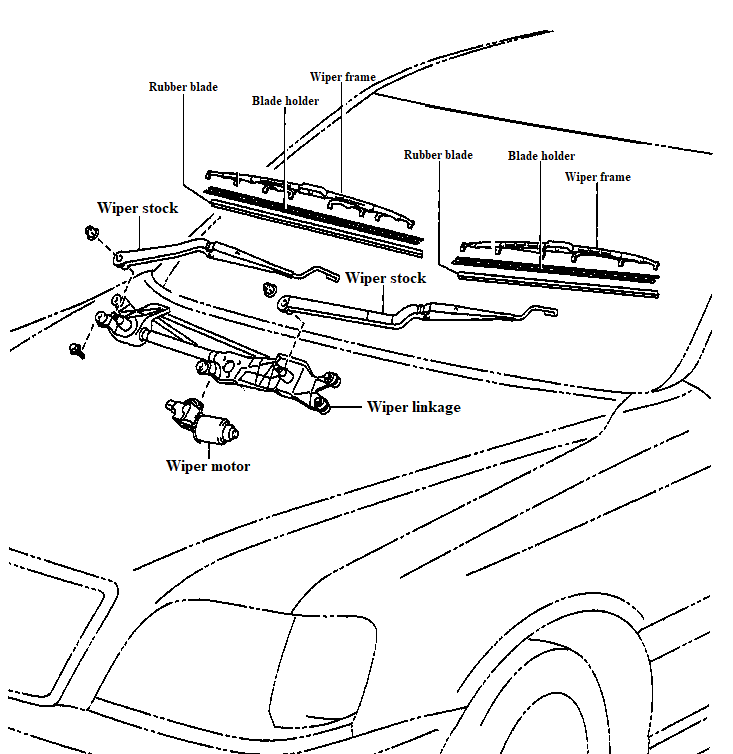
Images/MechatronicsSectionFigures/LinkMechanism_editv3.png
