Hyperwiper/Hyperwiper/Images/MechatronicsSectionFigures/SpeakerLayout.png

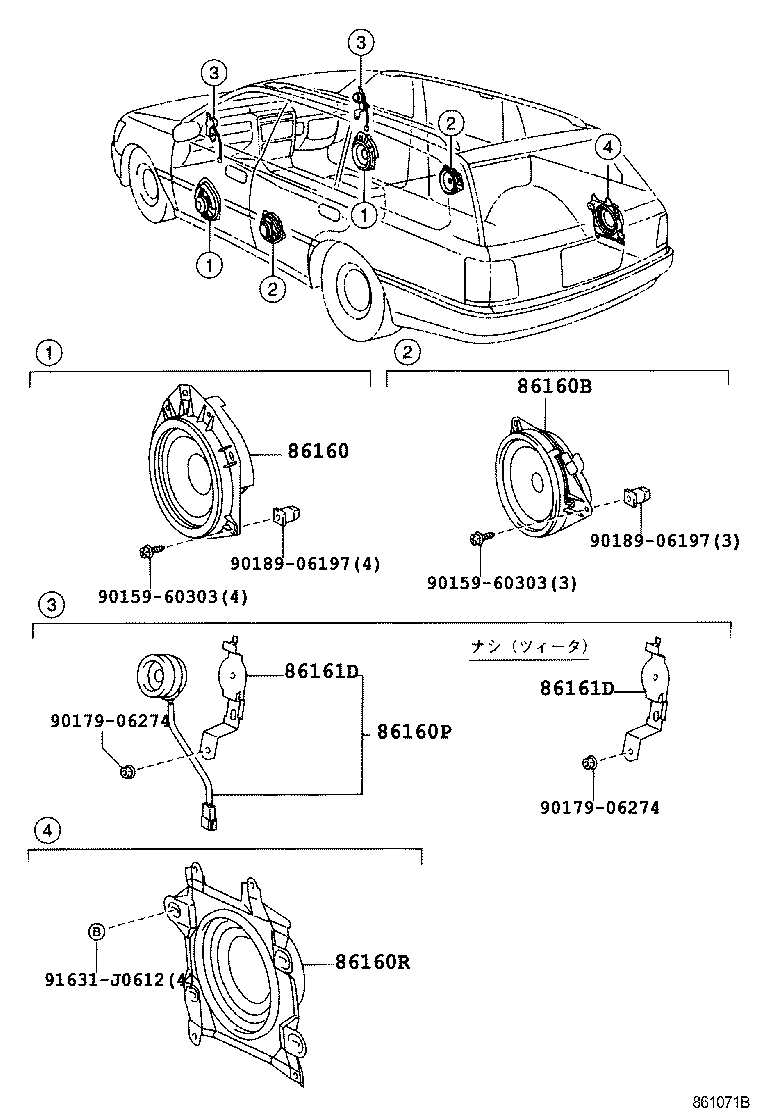
Images/MechatronicsSectionFigures/SpeakerLayout.png
