Hyperwiper/Hyperwiper/Images/MechatronicsSectionFigures/SpeakerLayout_editv2.png

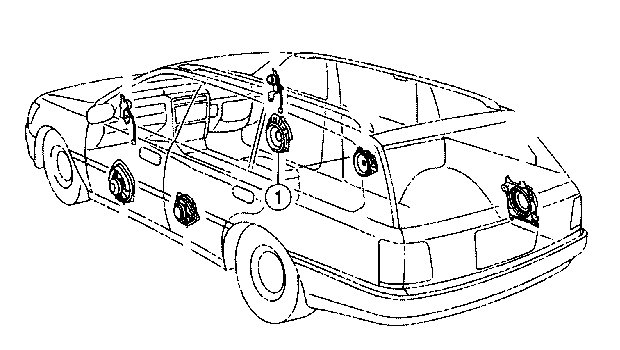
Images/MechatronicsSectionFigures/SpeakerLayout_editv2.png
