Hyperwiper/Hyperwiper/Images/MechatronicsSectionFigures/Waytek-fusetap.jpg

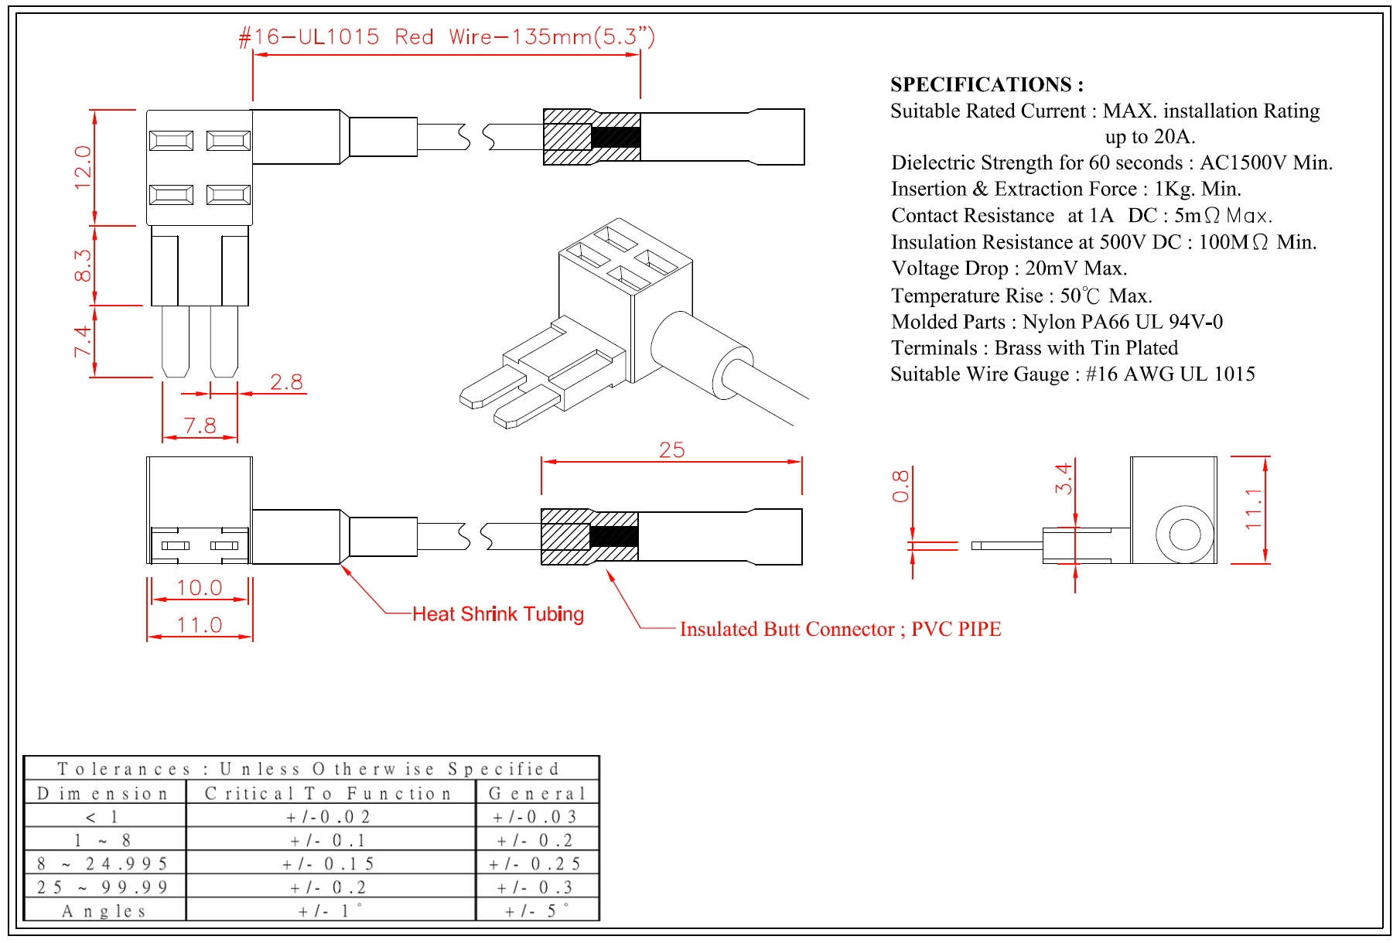
Images/MechatronicsSectionFigures/Waytek-fusetap.jpg
