Hyperwiper/Hyperwiper/Images/MechatronicsSectionFigures/Windshield.png

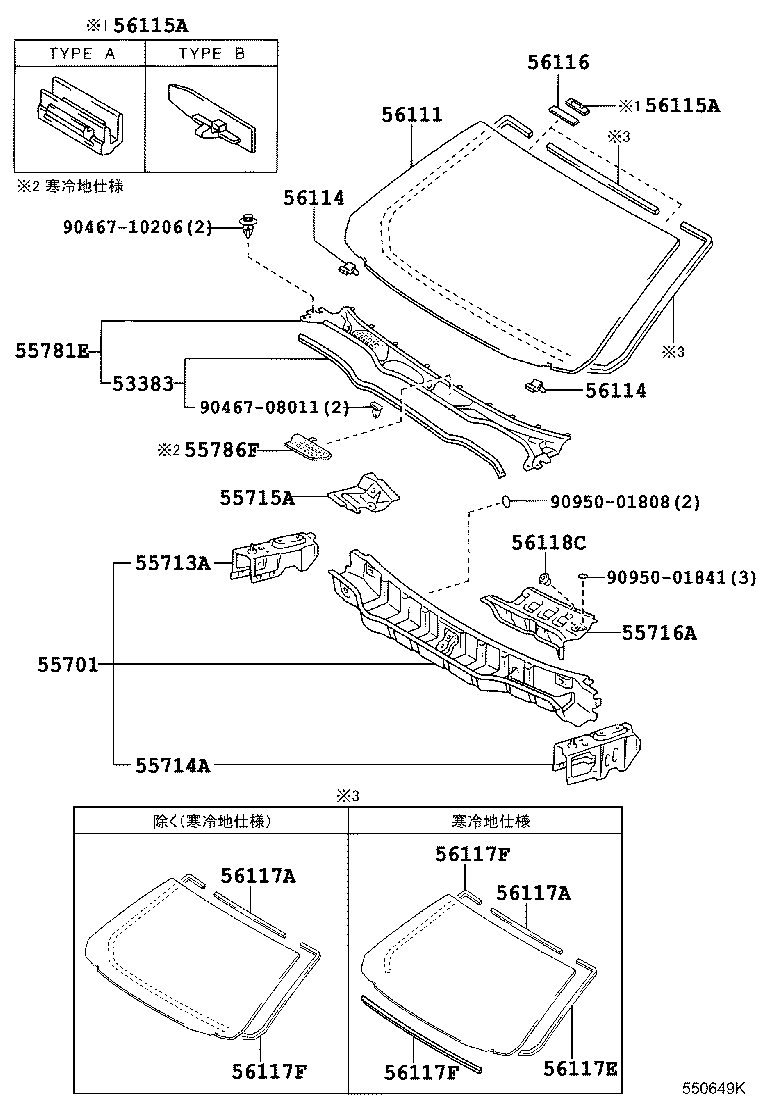
Images/MechatronicsSectionFigures/Windshield.png
