Hyperwiper/Hyperwiper/Images/MechatronicsSectionFigures/Windshield_edit.png

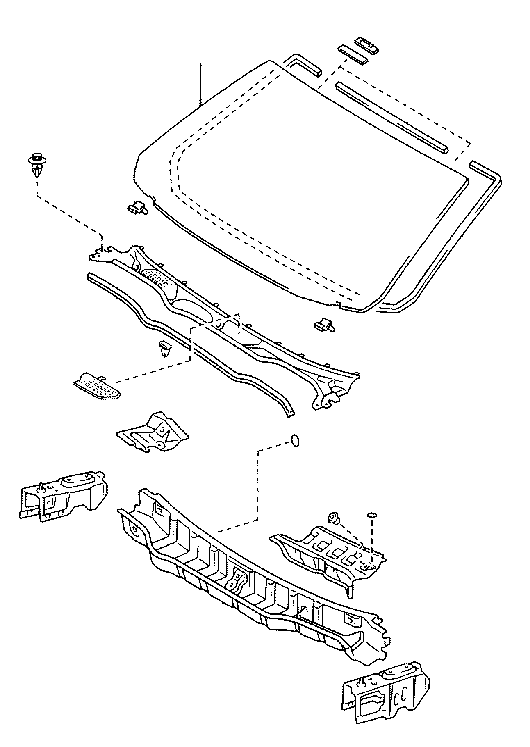
Images/MechatronicsSectionFigures/Windshield_edit.png
