Hyperwiper/Hyperwiper/Images/MechatronicsSectionFigures/Windshield_editv3.png

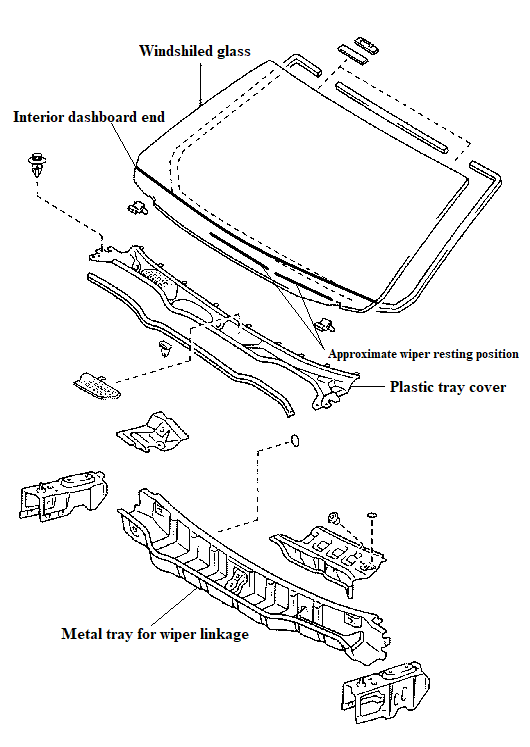
Images/MechatronicsSectionFigures/Windshield_editv3.png
