Hyperwiper/Hyperwiper/Images/MechatronicsSectionFigures/wiperOverviewFig.jpg

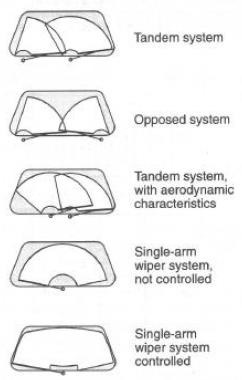
Images/MechatronicsSectionFigures/wiperOverviewFig.jpg
