Hyperwiper/Hyperwiper/Images/Screenshot from 2022-07-14 00-00-37.png

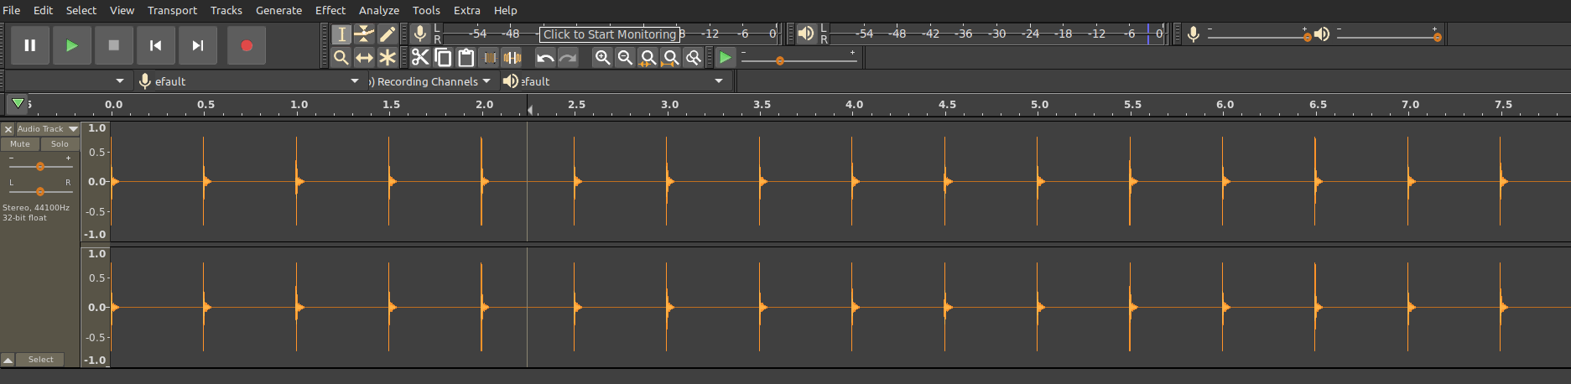
Images/Screenshot from 2022-07-14 00-00-37.png
