Hyperwiper/Hyperwiper/hardware/Hyperwiper 2020 production prototype/hyperwiper.stl

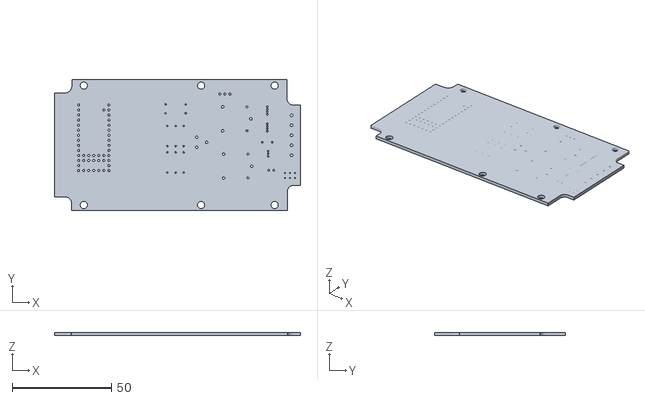
[picture p67: CAD file, 2020-11-07]
hardware/Hyperwiper 2020 production prototype/hyperwiper.stl
123.8 x 65.8 x 1.60
