Hyperwiper/Hyperwiper/hardware/Hyperwiper 2020 production prototype/TeensyAudiBoard-FreeCAD+WRL/TeensyAudioBoard good without extra sdcard and 2x5 pins.FCStd

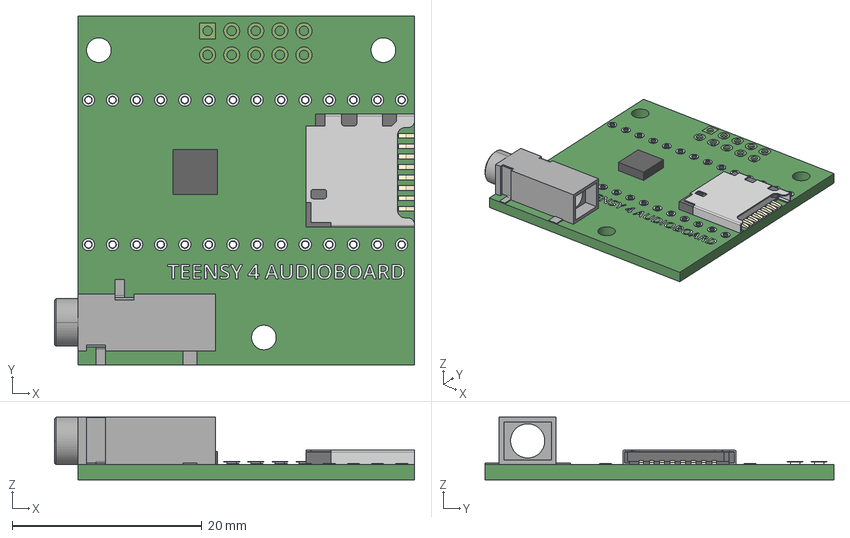
[picture p68: CAD file, 2020-08-04]
hardware/Hyperwiper 2020 production prototype/TeensyAudiBoard-FreeCAD+WRL/TeensyAudioBoard good without extra sdcard and 2x5 pins.FCStd
38.0 x 36.8 x 6.60 mm
CUI_DEVICES_SJ-3523-SMT-TR
Base
Case
Teensy pins left
Processor
Text board
Teensy pins right
TopPads
BotPads
PTHs
Main board
