Hyperwiper/Hyperwiper/hardware/Hyperwiper 2020/songle 12Volt.FCStd

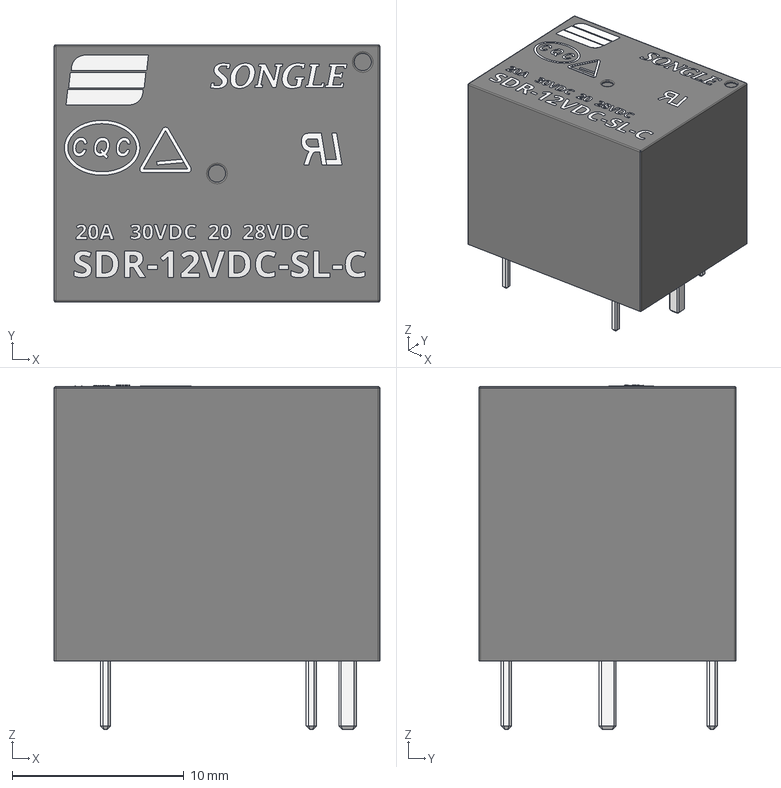
[picture p69: CAD file, 2020-08-09]
hardware/Hyperwiper 2020/songle 12Volt.FCStd
19.0 x 15.0 x 20.2 mm
PinCom
Pin003
Triangle001_(Solid)
Ovale
CQC
SONGLE
Logo2
Pin004
Triangle002_(Solid)
Logo3
L
Logo1
R
PinNC
PinNO
Scale002
Scale003
Scale
