Hyperwiper/Hyperwiper/hardware/Hyperwiper 2020 production prototype/Hyperwiper 2020 production prototype1.step

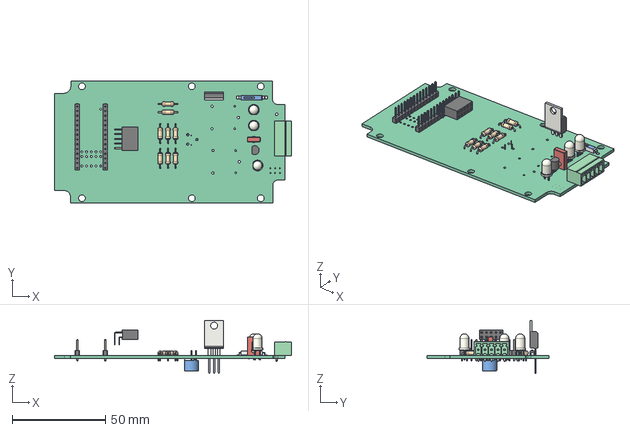
[picture p70: CAD file, 2020-11-07]
hardware/Hyperwiper 2020 production prototype/Hyperwiper 2020 production prototype1.step
127.2 x 65.8 x 28.5 mm
