Hyperwiper/Hyperwiper/hardware/Hyperwiper 2020 production prototype/TeensyAudiBoard-FreeCAD+WRL/TeensyAudioBoard.FCStd

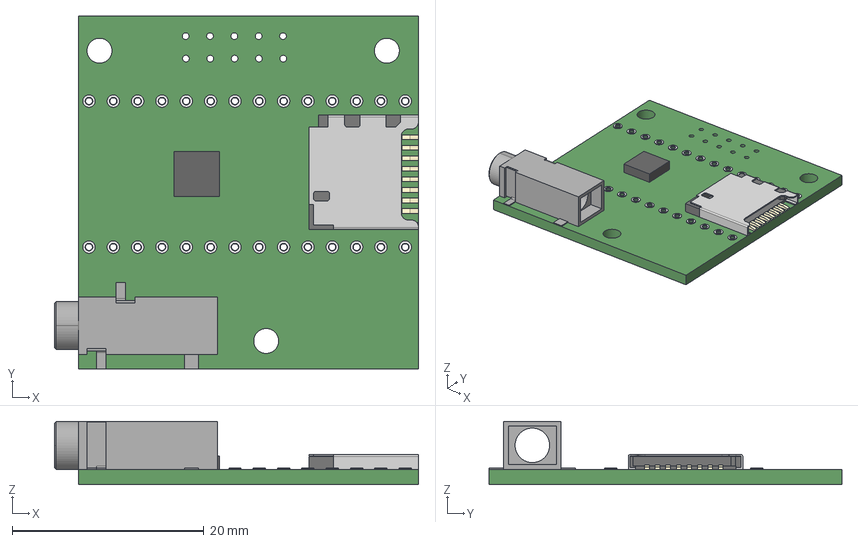
[picture p71: CAD file, 2020-08-04]
hardware/Hyperwiper 2020 production prototype/TeensyAudiBoard-FreeCAD+WRL/TeensyAudioBoard.FCStd
38.0 x 36.8 x 6.60 mm
Headphone jack
Base
Case
Teensy pins left
Teensy pins right
