Hyperwiper/Hyperwiper/hardware/Hyperwiper 2020/SRD-12VDC-SL-C--3DModel-STEP-184599.STEP

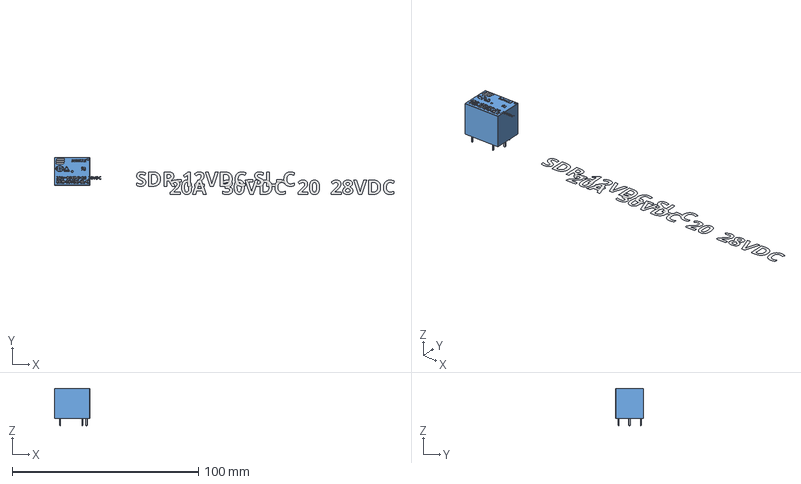
[picture p72: CAD file, 2020-08-04]
hardware/Hyperwiper 2020/SRD-12VDC-SL-C--3DModel-STEP-184599.STEP
182.5 x 19.9 x 20.2 mm
