Hyperwiper/Hyperwiper/hardware/Hyperwiper 2020 production prototype/Hyperwiper 2020 production prototype.step

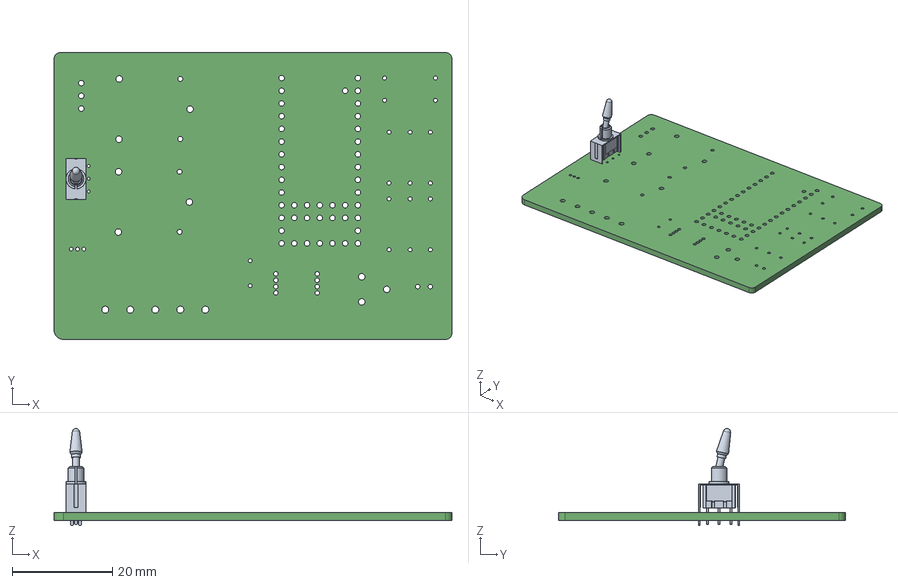
[picture p73: CAD file, 2020-10-18]
hardware/Hyperwiper 2020 production prototype/Hyperwiper 2020 production prototype.step
79.5 x 57.3 x 19.4 mm
Songle_SRD_12Volt_black x 2
export_test_with_text_shape_and_lines_and_audio_header
Teensy_4
