Hyperwiper/Hyperwiper/(list of files, cad)

Other CAD files:
hardware/Hyperwiper 2020 production prototype/TeensyAudiBoard-FreeCAD+WRL/TeensyAudioBoard good without extra sdcard.FCStd
hardware/Hyperwiper 2020/Songle 12Volt_blendered.stl
hardware/Hyperwiper 2020 production prototype/Songle SDR-12Volt relay.step
hardware/Hyperwiper 2020/SRD-05VDC-SL-C--3DModel-STEP-184599.STEP
hardware/Hyperwiper 2020 production prototype/Songle SRD-12Volt relay.FCStd
hardware/Hyperwiper 2020 production prototype/Songle SRD 12Volt black.FCStd
hardware/Hyperwiper 2020/TeensyAudiBoard-FreeCAD+WRL/TeensyAudioBoard.FCStd
docs/Takashi lid 3D.blend
hardware/Hyperwiper 2020 production prototype/Hyperwiper 2020 production prototype.obj
hardware/Hyperwiper 2020 production prototype/Hyperwiper_2020_production_prototype.FCStd
hardware/Hyperwiper 2020 production prototype/Hyperwiper_2020_production_prototype1.FCStd
hardware/Hyperwiper 2020/Songle 12Volt.stl
