Hyperwiper/Hyperwiper/docs/setup  part of the flowchart.png

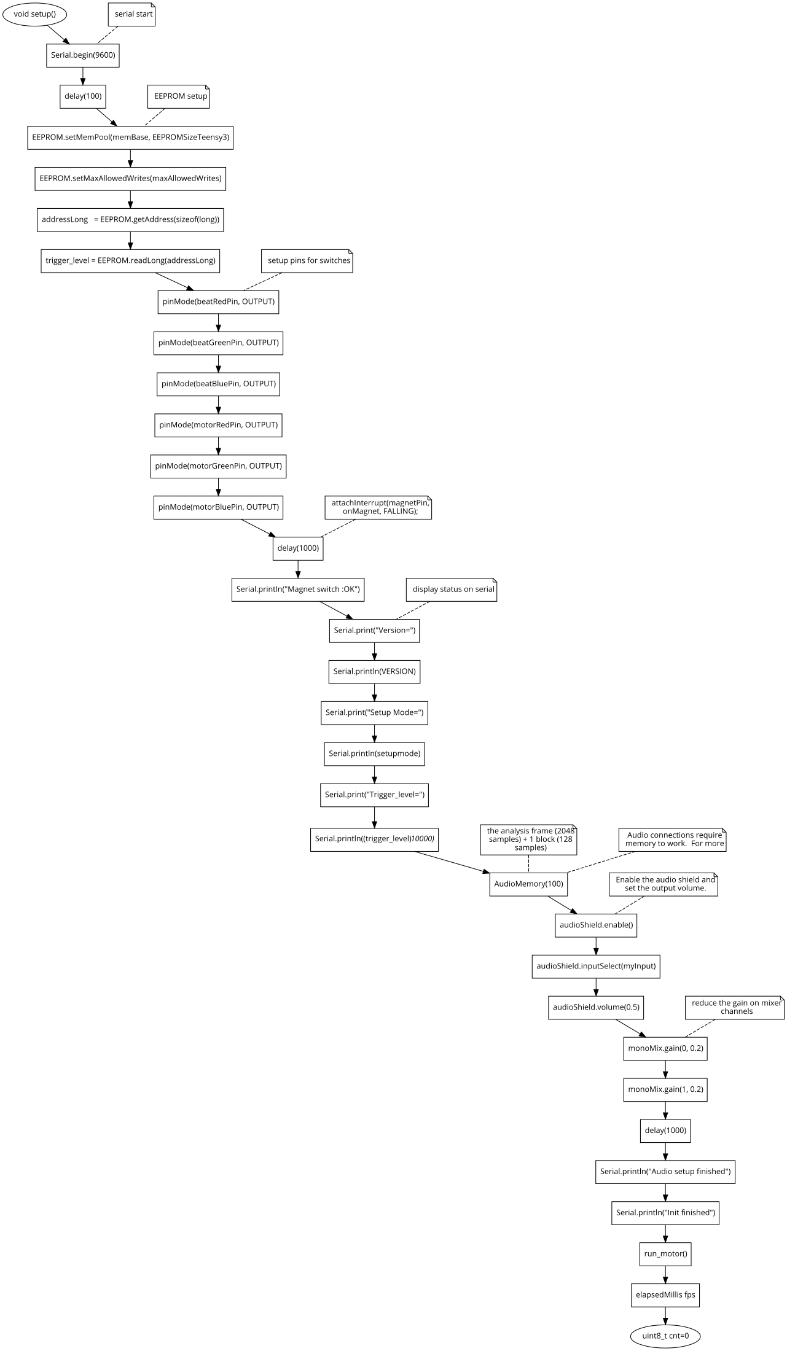
docs/setup part of the flowchart.png
