Hyperwiper/Hyperwiper/docs/Hyper wiper audio timing test wipe.png

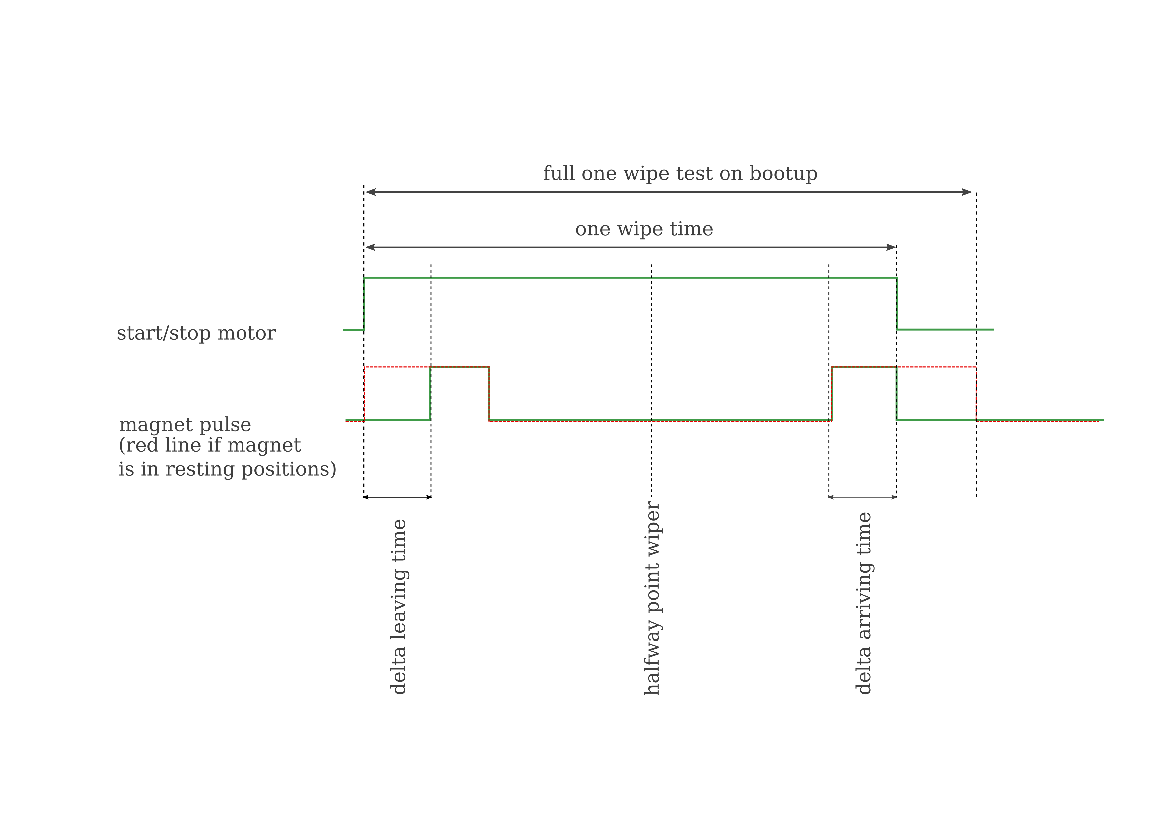
docs/Hyper wiper audio timing test wipe.png
