Hyperwiper/Hyperwiper/docs/hyperwiper timing graph start wipe without wipe test.png

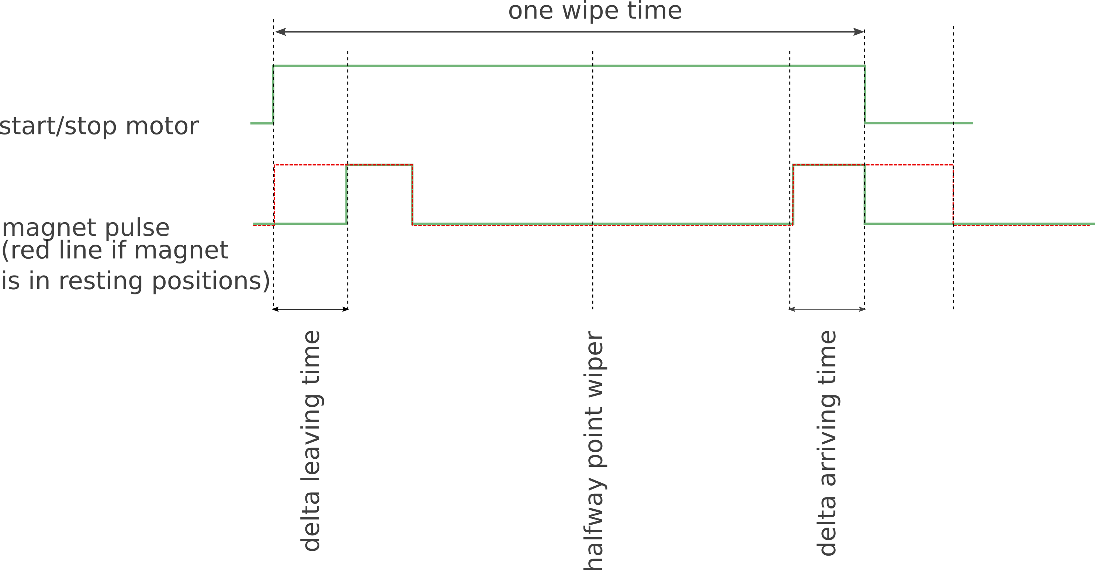
docs/hyperwiper timing graph start wipe without wipe test.png
