Hyperwiper/Hyperwiper/(threads)

Thread 11 (2021-12-05):

Reported issues from 2012-12 email of Michael and Peter

robouden, 2021-12-05:
To start, the beat detection seems delayed from the actual music. I suppose that delay could be accommodated by the software to be developed,
but wonder if we'll need another light on the box to show the adjusted (delayed) beat to be able to visually confirm such entrainment.

1. Also, the magnet detection doesn’t work well, especially with winter wipers that have a larger rubber strip between the metal arm and the windshield.

>   We’ve ordered stronger (neodymium rare earth) magnets, besides the “refrigerator” style that we had been using, expect to get them next week,
>   and will report on such experiments.
>

2. To confirm the interpretation of the LEDs, AFAIK,
 	blue means “awaiting”,
 	green means “arriving”, &
 	red means “departing.”

Is that right? Sometimes the LED seems cyan. Is there a particular meaning for that?
Are there any other meaningful colors?

Thread 12 (2022-04-19):

2022-04-18 notes from Micheal:

robouden, 2022-04-19:
Peter & I tried to claw back some progress today, and had some issues. At first, we couldn’t detect any audio signal, but that seems to be because it was connected to his squalker midrange speaker, which might not be the best driver for low-end time-keeping. Switching to an electronic metronome (computer click track) had better results, but only alternate beats were detected (as flashed by LED on the module). Also, the choreography of the wiper seemed stuttered, juddered, staggered, maybe because the wiper motor doesn’t pause long enough after stopping stroke before restarting. Rob mentioned the possibility of Hall Effect sensors for wiper excursion (to extract round-trip interval for phase-locked loop synchronization) to replace current magnetic sensors, which would allow detection range of perhaps 5 cm.
