Hyperwiper/Hyperwiper/hardware/DWP 2015/block diagram.pdf

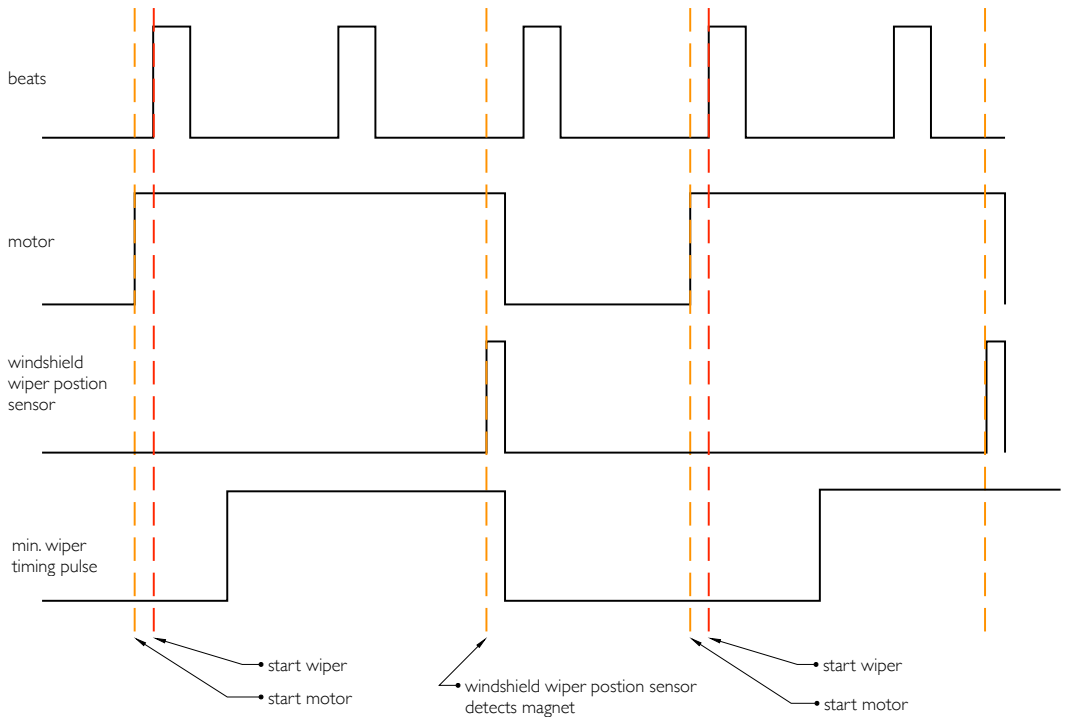
[picture p78: page 1]
beats; motor; windshield wiper postion sensor; start motor; detects magnet; start wiper; min. wiper timing pulse
