Hyperwiper/Hyperwiper/docs/main loop flow chart.pdf

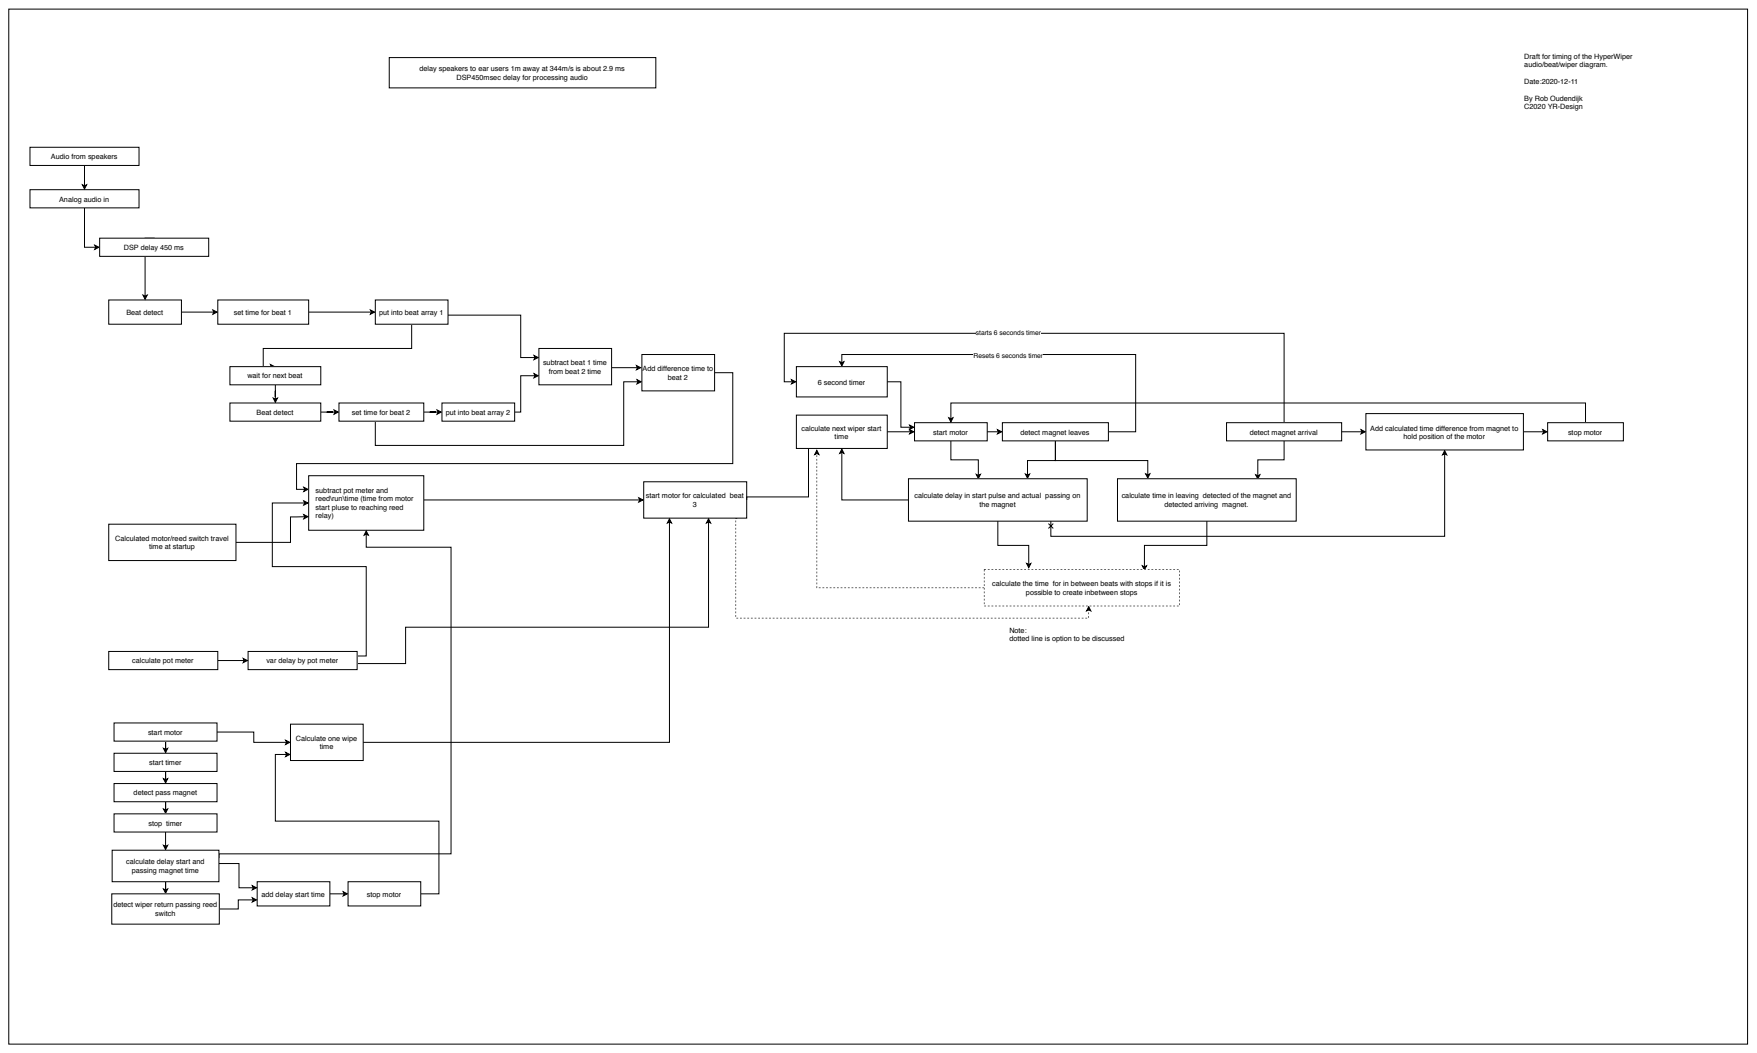
[picture p79: page 1]
Beat detect; set time for beat 1; put into beat array 1; set time for beat 2; put into beat array 2; from beat 2 time; Add difference time to; beat 2; add delay start time; stop motor; time; start motor; the magnet; Date:2020-12-11; 6 second timer; detect magnet arrival; start timer; stop timer; switch

Draft for timing of the HyperWiper
audio/beat/wiper diagram.

delay speakers to ear users 1m away at 344m/s is about 2.9 ms

DSP450msec delay for processing audio

By Rob Oudendijk
C2020 YR-Design

Audio from speakers

Analog audio in

DSP delay 450 ms

starts 6 seconds timer

Resets 6 seconds timer

subtract beat 1 time

wait for next beat

detect magnet leaves calculate next wiper start

Add calculated time difference from magnet to

hold position of the motor

subtract pot meter and
reed\run\time (time from motor
start pluse to reaching reed
relay)

start motor for calculated beat

calculate delay in start pulse and actual passing on

calculate time in leaving detected of the magnet and

detected arriving magnet.

Calculated motor/reed switch travel

time at startup

calculate the time for in between beats with stops if it is

possible to create inbetween stops

Note:
dotted line is option to be discussed

calculate pot meter

var delay by pot meter

Calculate one wipe

detect pass magnet

calculate delay start and
passing magnet time

detect wiper return passing reed
