Hyperwiper/Hyperwiper/docs/LCT135H-N-DD pcb page.pdf

## 上カバー / Top cover

# R1.54- ¹⁷.5

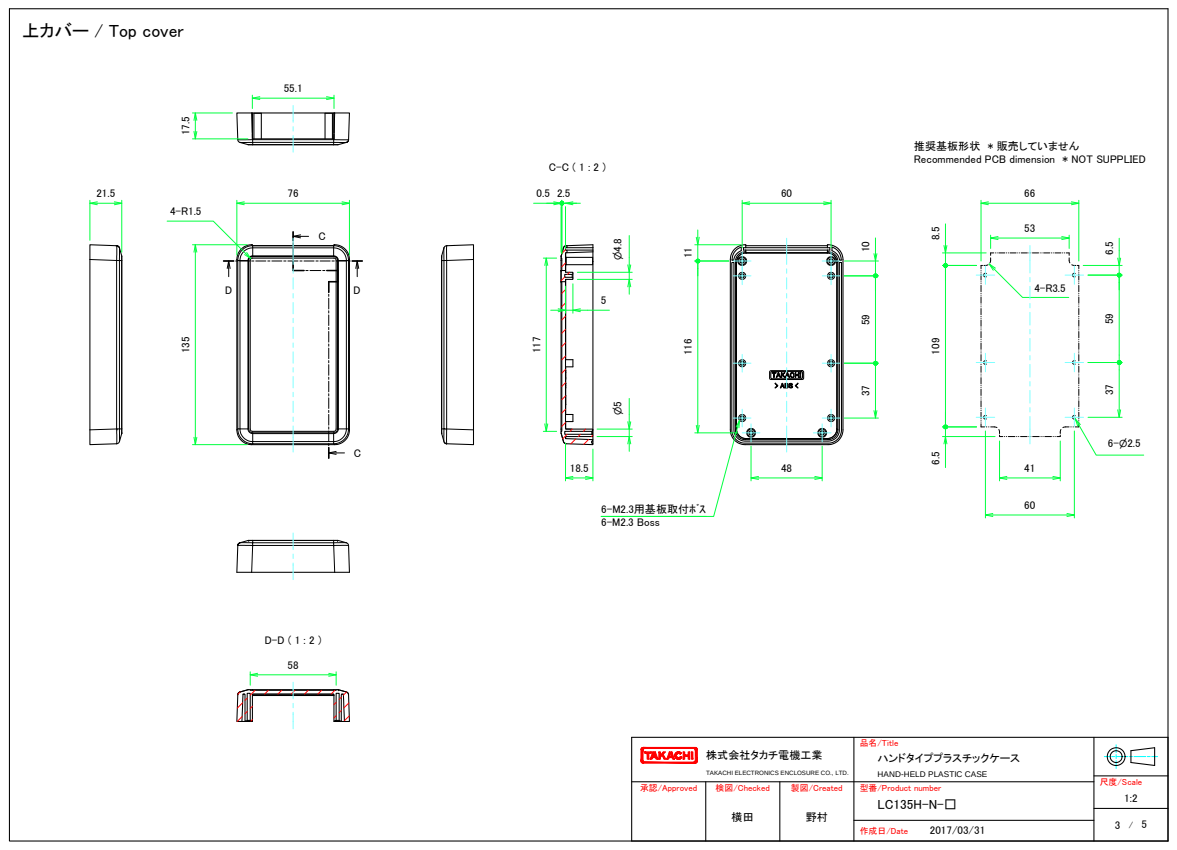
[picture p80: page 1]
品名/Title; 承認/Approved; 検図/Checked; 製図/Created; 型番/Product number; 株式会社タカチ電機工業; 尺度/Scale; 作成日/Date; ハンドタイププラスチックケース; TAKACHI ELECTRONICS ENCLOSURE CO., LTD.; HAND-HELD PLASTIC CASE; 6-M2.3用基板取付ﾎﾞｽ 6-M2.3 Boss

推奨基板形状　* 販売していません
Recommended PCB dimension * NOT SUPPLIED
