Hyperwiper/Hyperwiper/docs/LCT page 15.pdf

## LCT135H-M3 / LCS135H-M3 / LC135H-M3

LCT • LCS • LC dimensions | ■ DXF/DWG/PDF drawings available on our website.

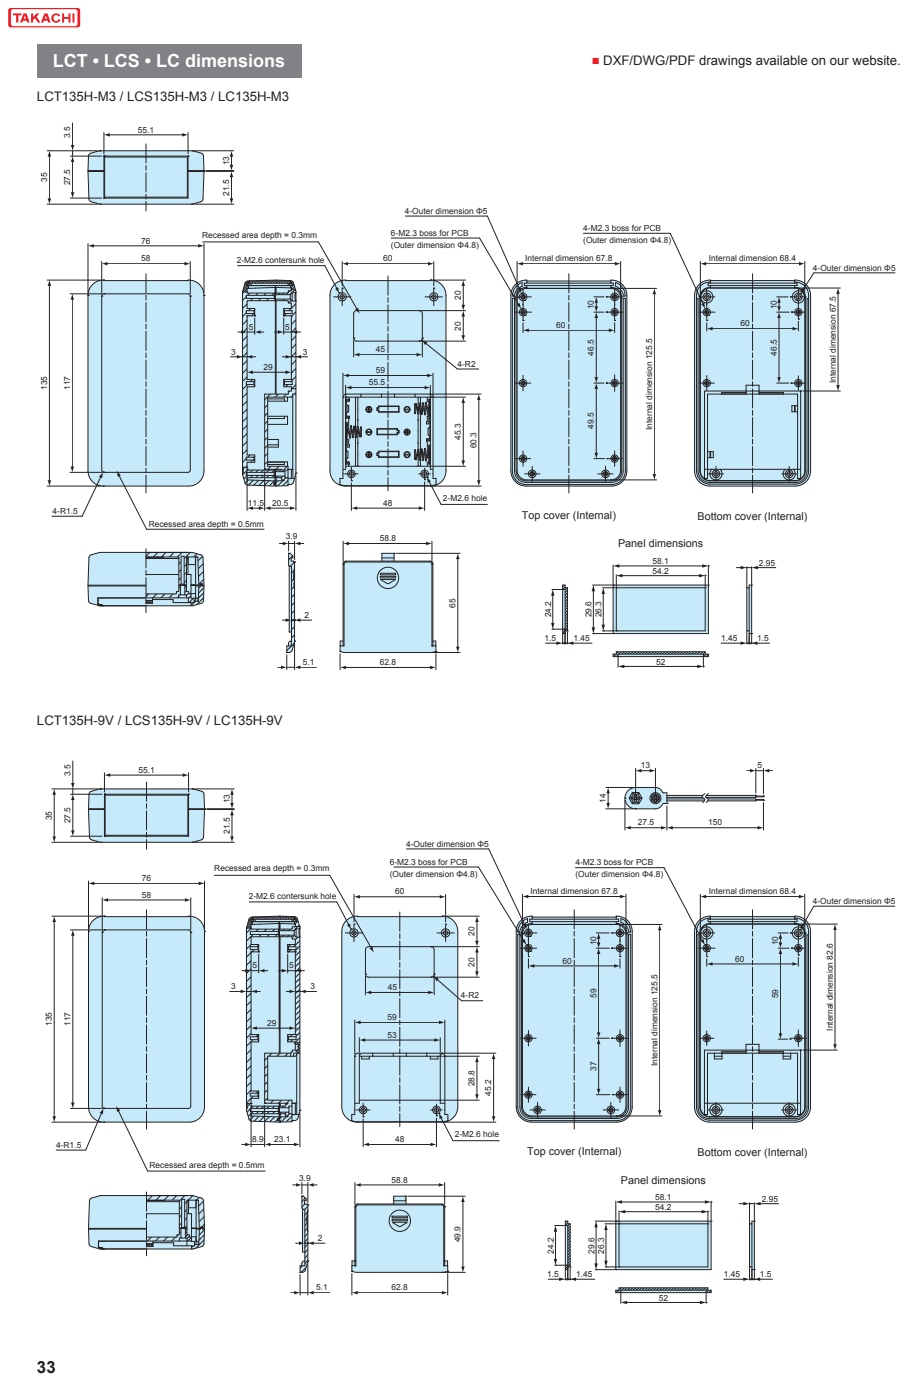
[picture p81: page 1]
Top cover (Internal); Bottom cover (Internal); Internal dimension 67.8; Internal dimension 125.5; Internal dimension 68.4; Internal dimension 67.5; 4-Outer dimension Φ5; Panel dimensions; 2-M2.6 contersunk hole; 2-M2.6 hole; Internal dimension 82.6; LCT135H-9V / LCS135H-9V / LC135H-9V

Recessed area depth = 0.3mm

6-M2.3 boss for PCB
(Outer dimension Φ4.8)

4-M2.3 boss for PCB

Recessed area depth = 0.5mm

4-Outer dimension Φ5
