Hyperwiper/Hyperwiper/Images/schematic.pdf

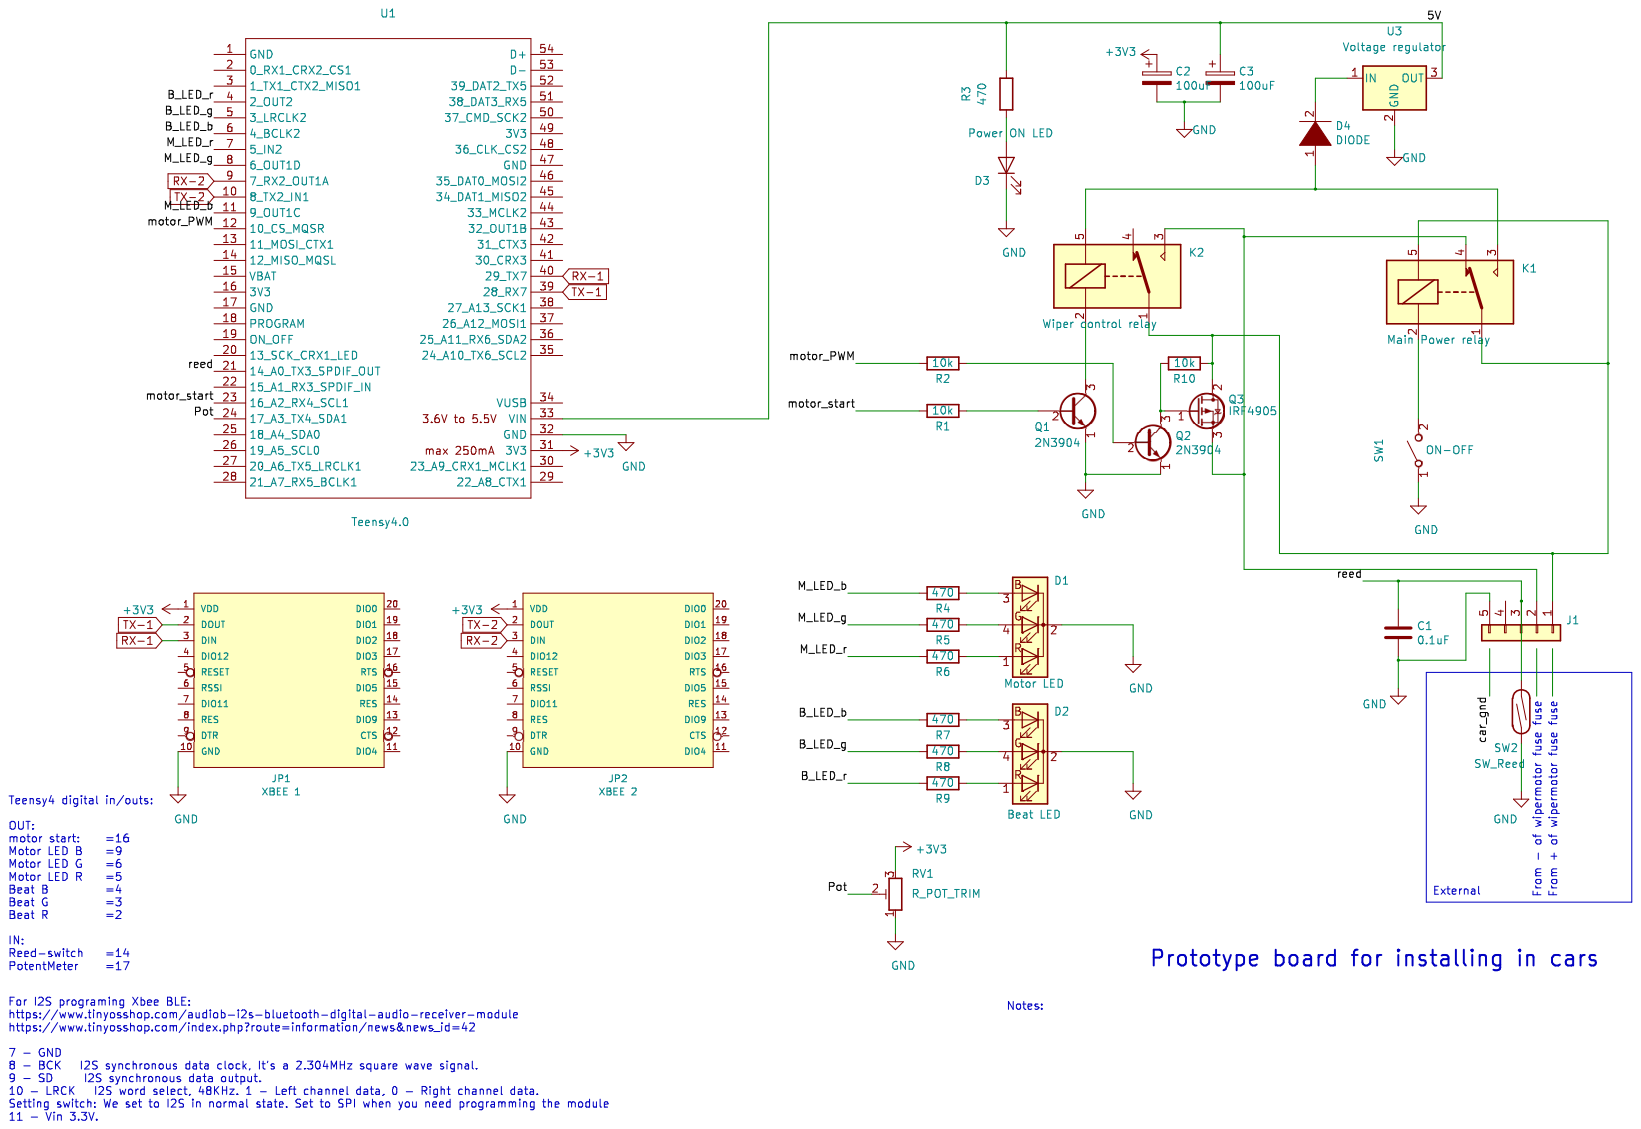
[picture p82: page 1]
