Hyperwiper/Hyperwiper/hardware/Hyperwiper 2020 production prototype/hyperwiper schematic V2.1.6.pdf

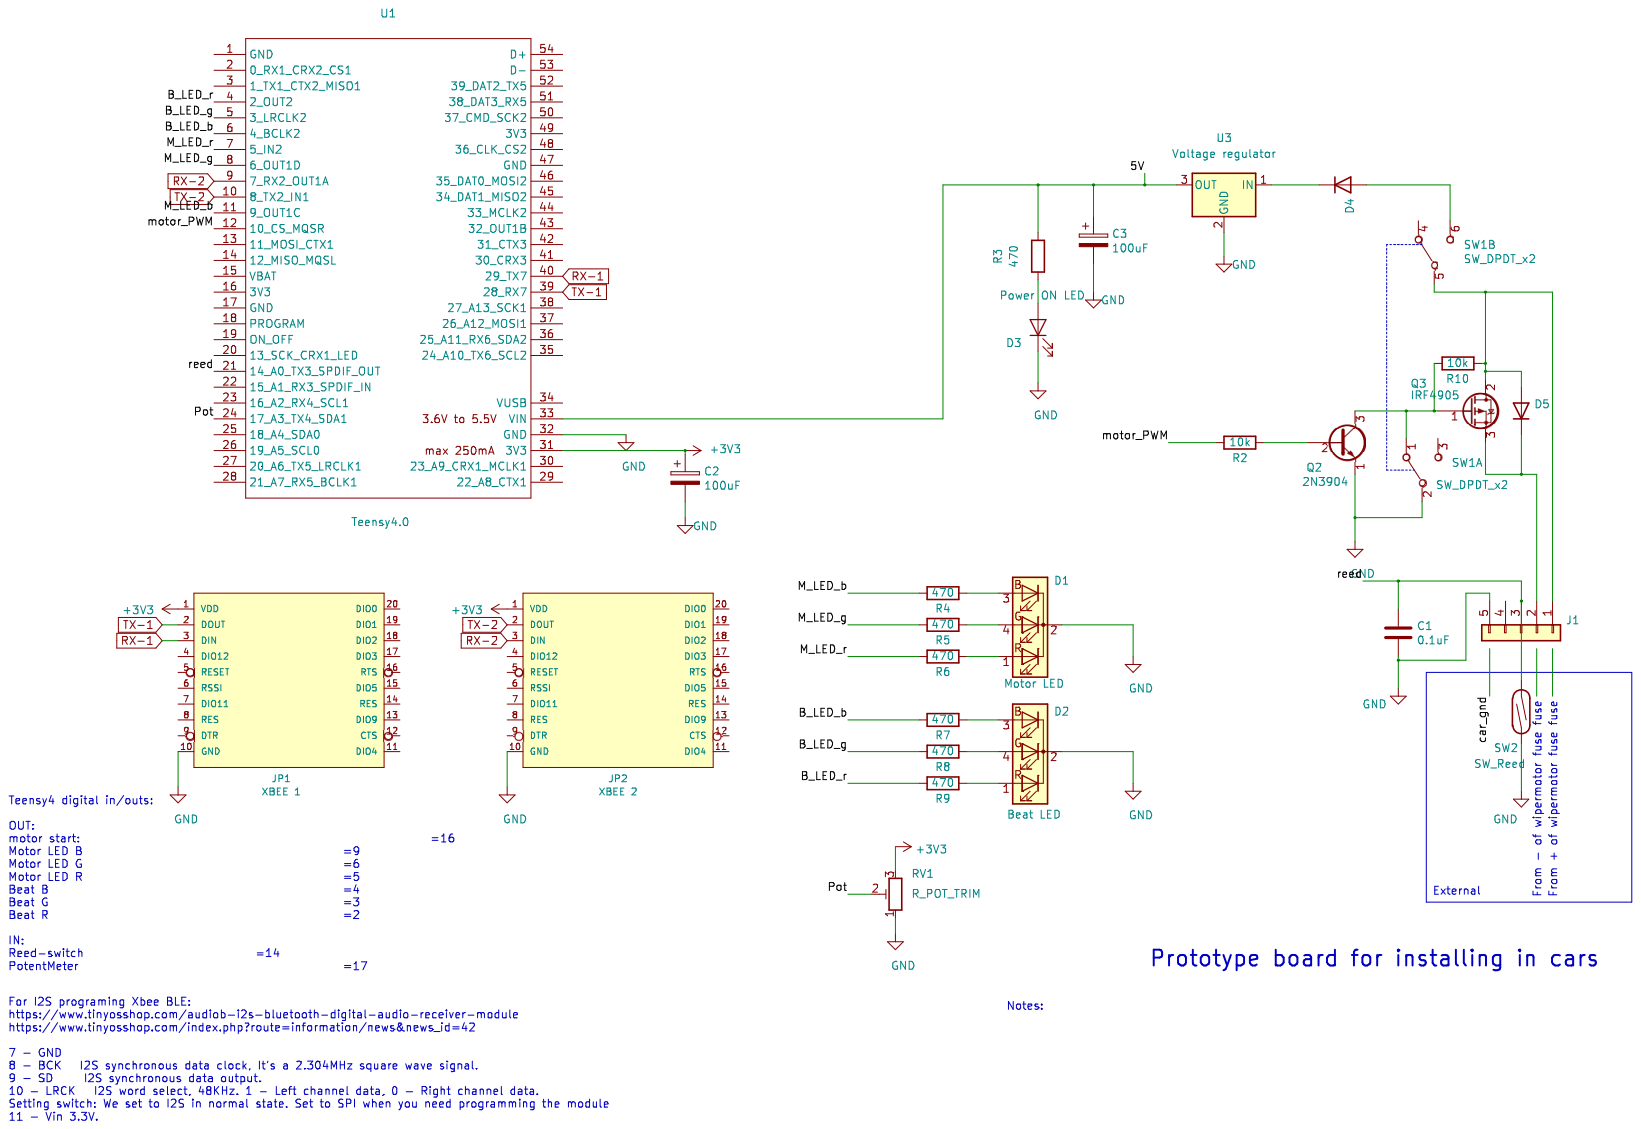
[picture p83: page 1]
