Hyperwiper/Hyperwiper/hardware/Hyperwiper 2020 production prototype/hyperwiper  board.pdf

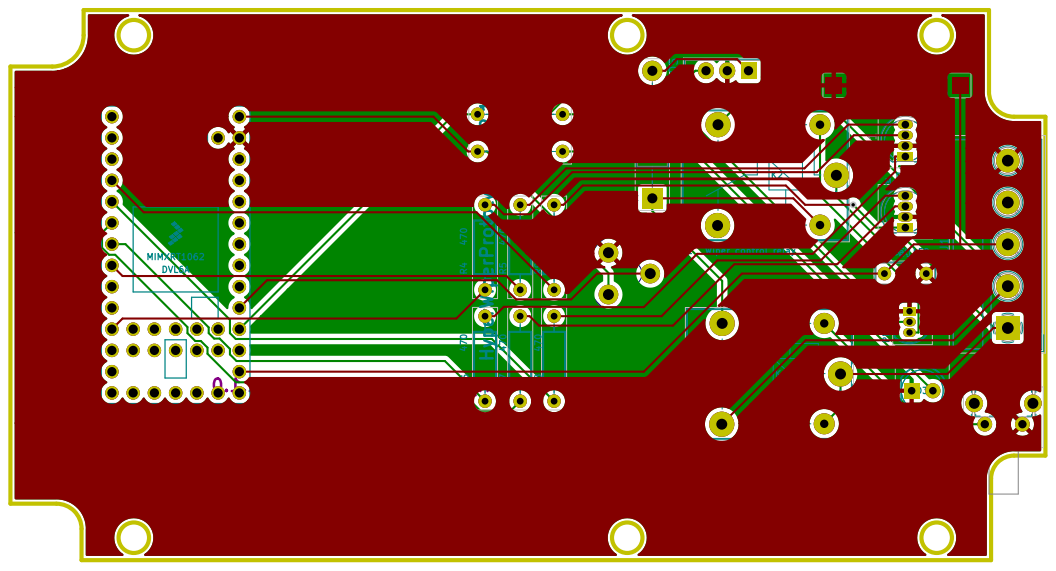
[picture p84: page 1]
