Hyperwiper/Hyperwiper/hardware/DWP 2015/DWP development flow chart.pdf

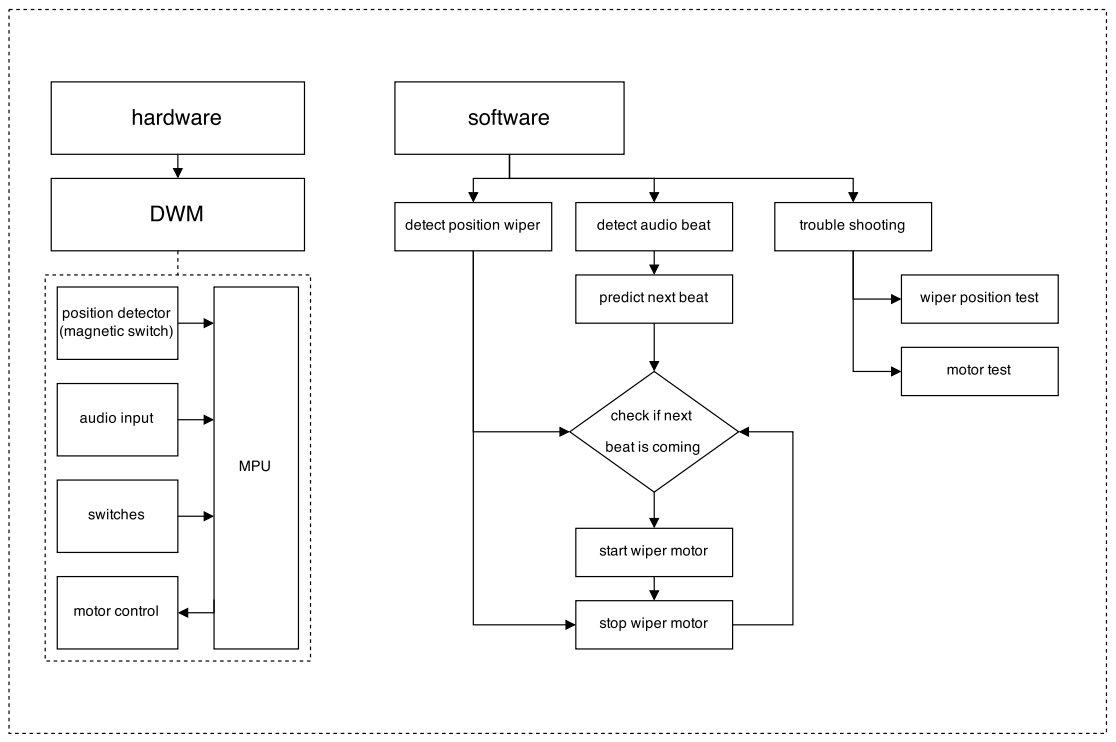
[picture p85: page 1]
