Hyperwiper/Hyperwiper/hardware/DWP 2015/DWP Logic.pdf

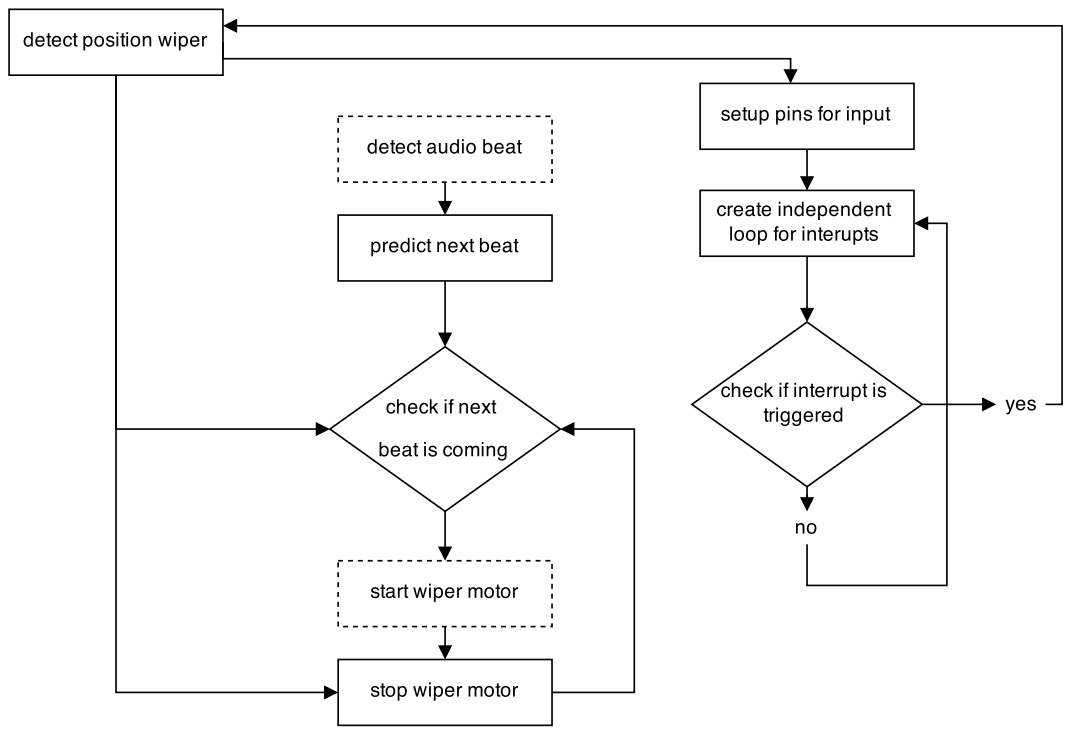
[picture p86: page 1]
