Hyperwiper/Hyperwiper/hardware/DWP 2015/DWP wiper motor logic.pdf

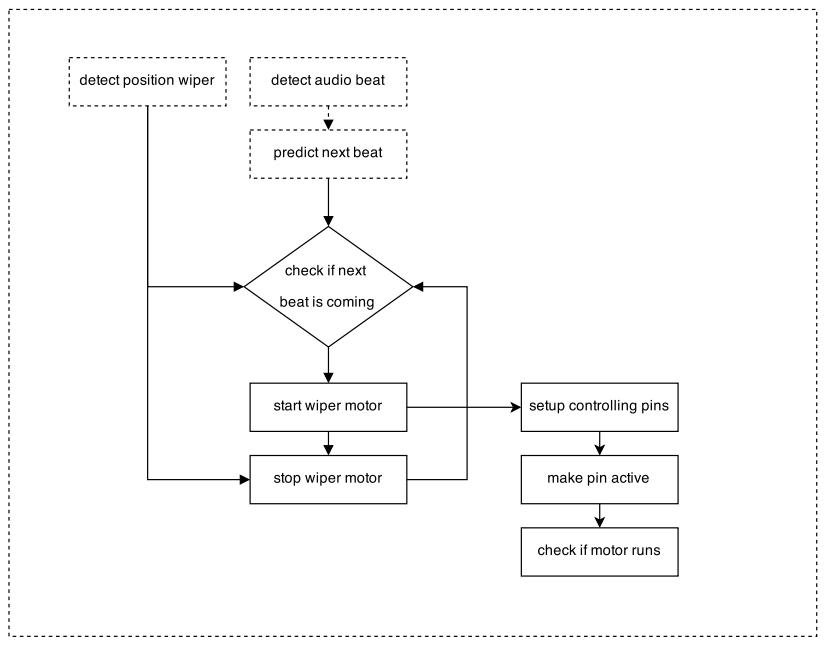
[picture p87: page 1]
