Hyperwiper/Hyperwiper/hardware/Hyperwiper 2020 production prototype/2020-07-30 Hyperwiper 2020 schematics draft.pdf

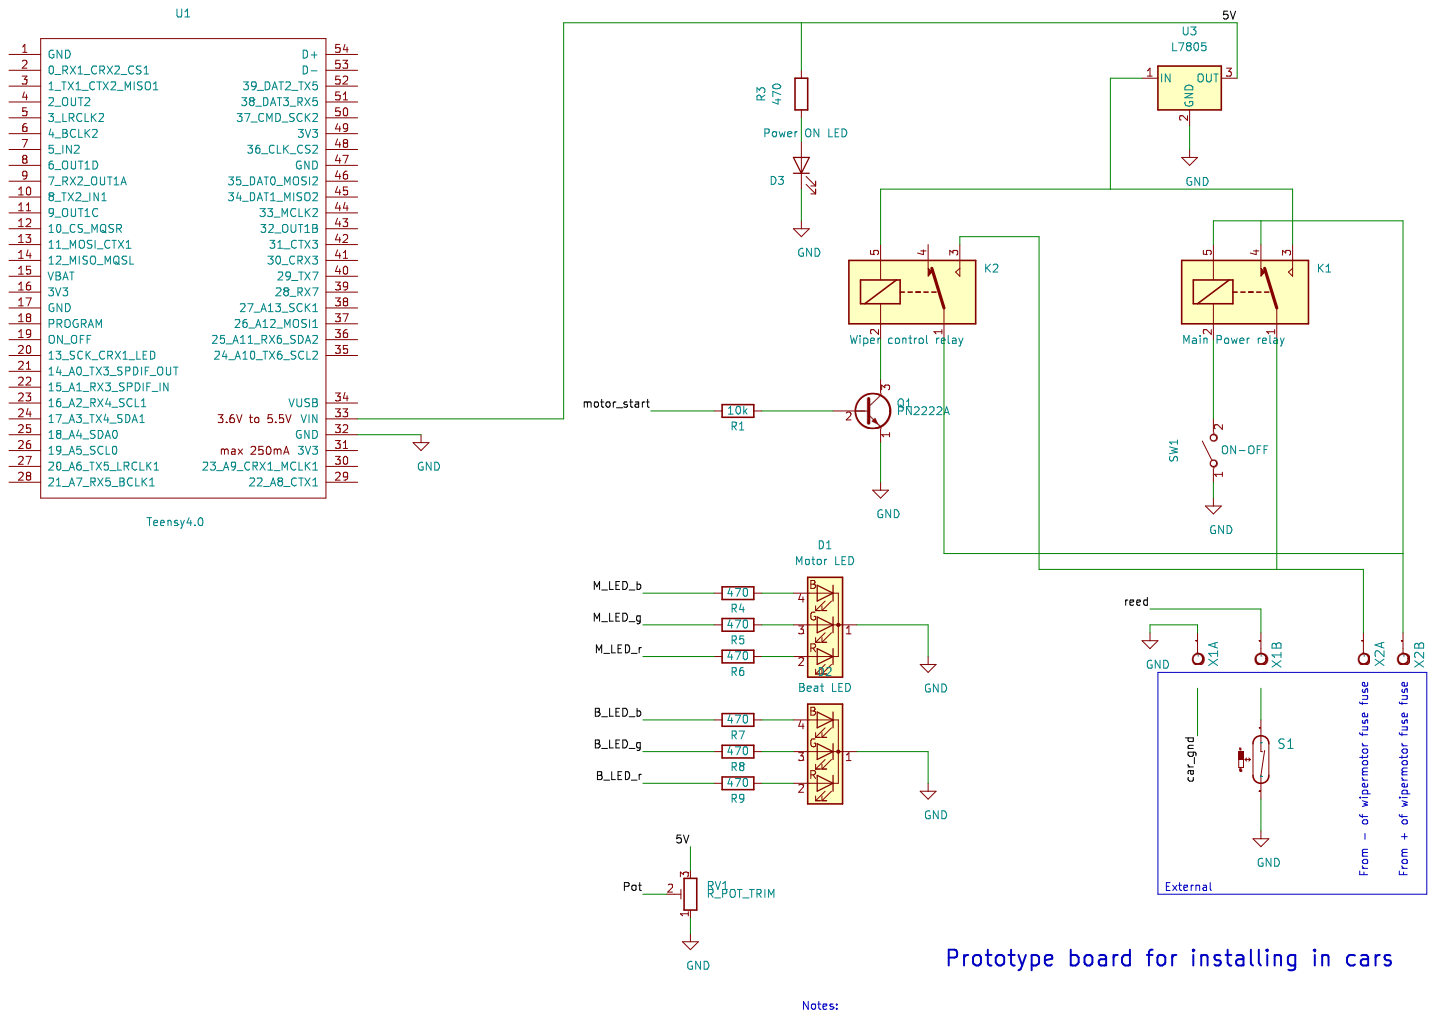
[picture p88: page 1]
