Hyperwiper/Hyperwiper/hardware/Hyperwiper 2020 production prototype/hyperwiper schematic.pdf

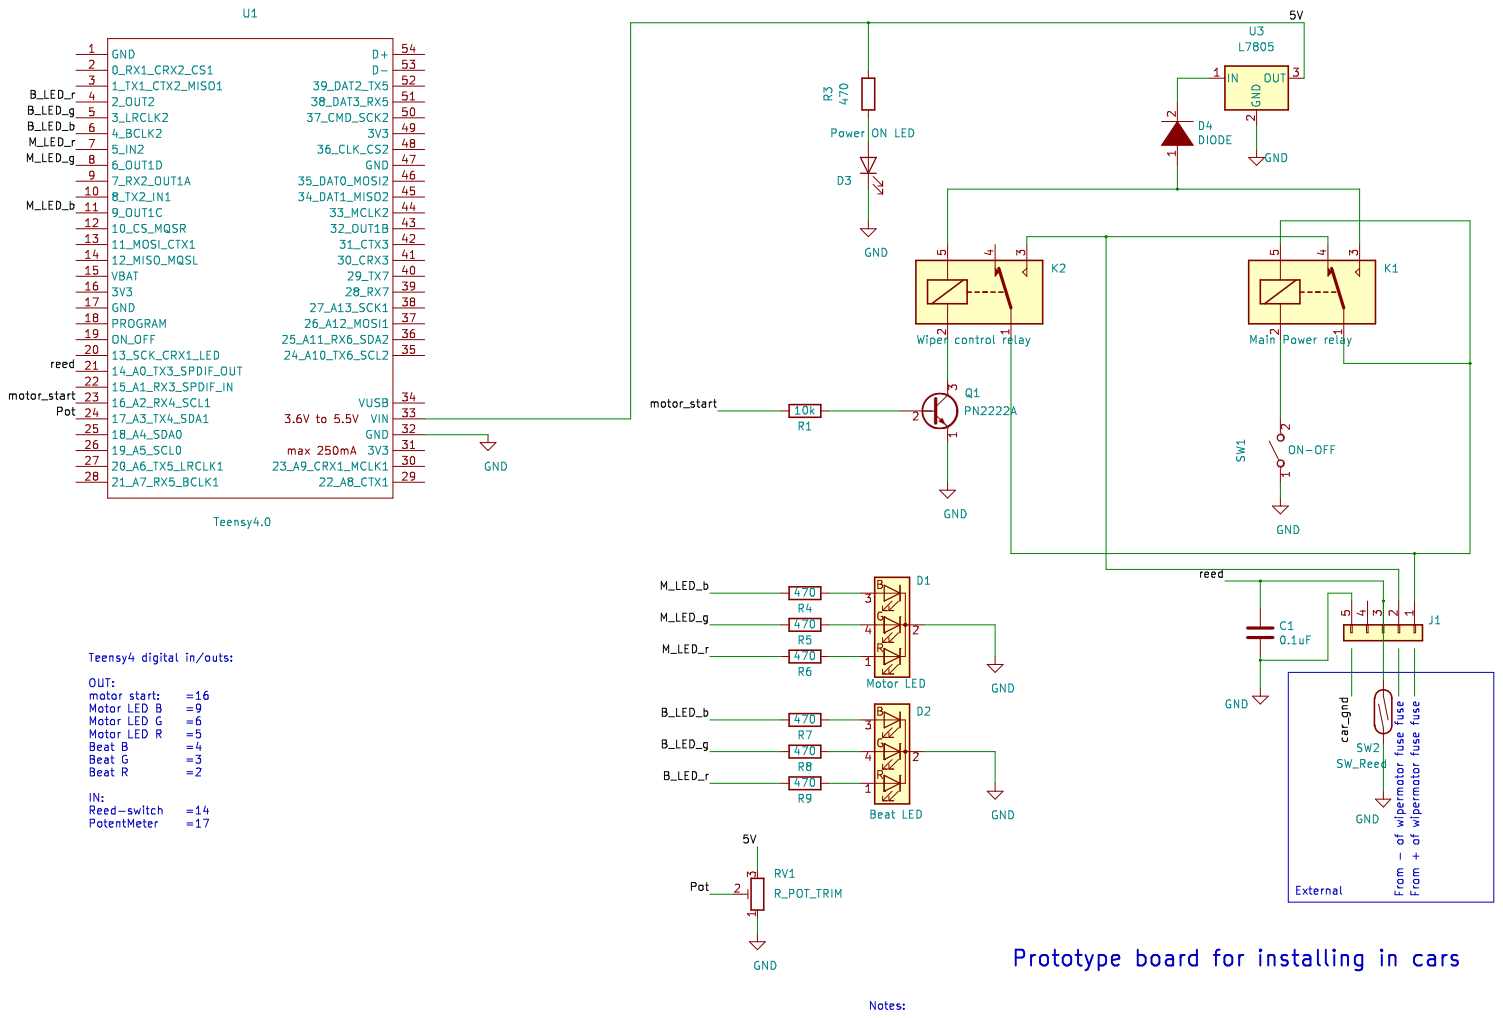
[picture p89: page 1]
