Hyperwiper/Hyperwiper/(list of files, drawings)

Other design files:
hardware/Hyperwiper 2020 production prototype/Hyperwiper 2020 production prototype.dsn
hardware/Hyperwiper 2020 prototype/Hyperwiper 2020 prototype.dsn
hardware/Hyperwiper 2020/DWP 2020.dsn
hardware/Hyperwiper 2020/Hyperwiper 2020.dsn
