Hyperwiper/Hyperwiper/hardware/Hyperwiper 2020 production prototype/Hyperwiper 2020 production prototype.kicad_pcb

## KiCad design hardware/Hyperwiper 2020 production prototype/Hyperwiper 2020 production prototype.kicad_pcb (2022-09-22)

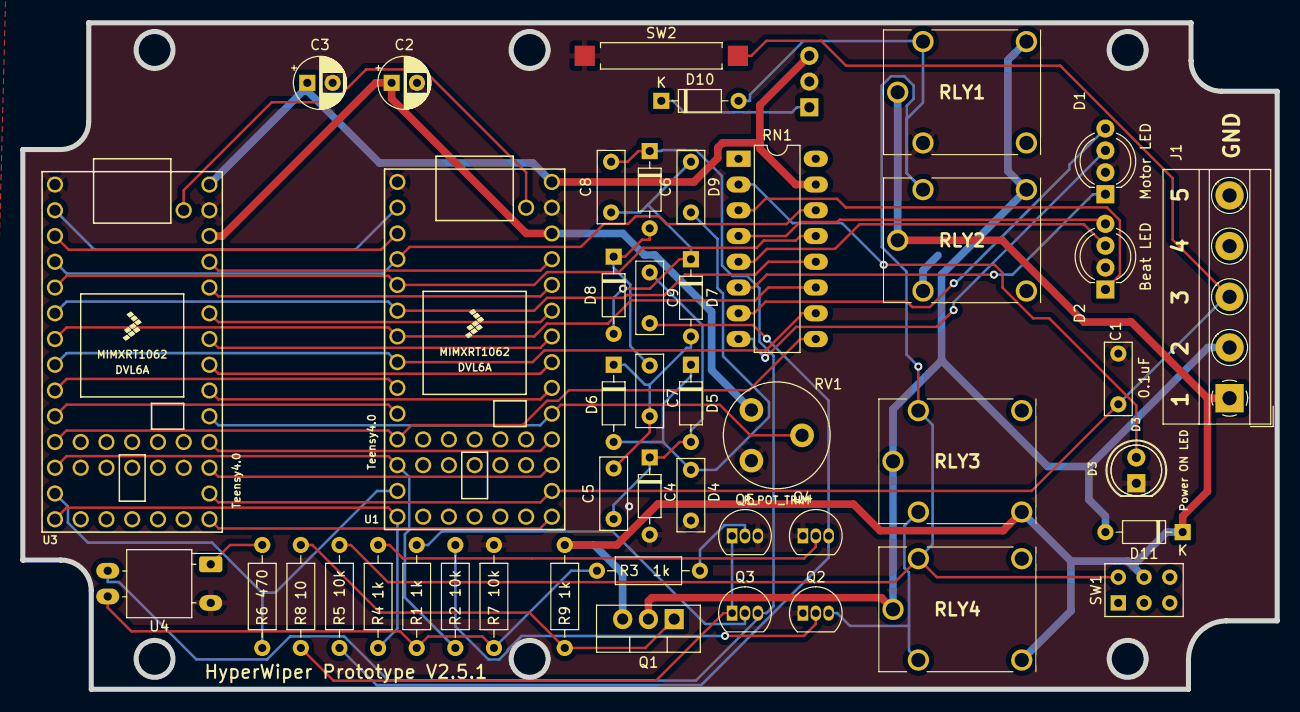
[picture p90: board Hyperwiper 2020 production prototype.kicad_pcb from above]

Board: 2 copper layers, 123.8 x 65.8 mm, 47 parts (1 on the bottom side), 55 nets.

Parts:
C1, C4, C5, C6, C7, C8, C9: 0.1uF; C_Rect_L7.0mm_W2.5mm_P5.00mm
C2, C3: 100uF; CP_Radial_D5.0mm_P2.50mm
D1: Motor LED; LED_D5.0mm-4_RGB_Wide_Pins
D2: Beat LED; LED_D5.0mm-4_RGB_Wide_Pins
D3: Power ON LED; LED_D5.0mm_Clear
D4, D5, D6, D7, D8, D9, D10, D11: D; D_DO-35_SOD27_P7.62mm_Horizontal
J1: Conn_01x05; TerminalBlock_MetzConnect_Type011_RT05505HBWC_1x05_P5.00mm_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
Q1: IRF3205; TO-220-3_Vertical
Q2, Q3, Q4: 2N2222; TO-92_Inline
Q5: 2N3906; TO-92_Inline
R1, R3, R4, R9: 1k; R_Axial_DIN0207_L6.3mm_D2.5mm_P10.16mm_Horizontal
R2, R5, R7: 10k; R_Axial_DIN0207_L6.3mm_D2.5mm_P10.16mm_Horizontal
R6: 470; R_Axial_DIN0207_L6.3mm_D2.5mm_P10.16mm_Horizontal
R8: 10; R_Axial_DIN0207_L6.3mm_D2.5mm_P10.16mm_Horizontal
RLY1, RLY2, RLY3, RLY4: JSM1-12V-5; SRA12VDCCL
RN1: R_Pack08; DIP-16_W7.62mm_LongPads
RV1: R_POT_TRIM; Potentiometer_Piher_PT-10-V05_Vertical
SW1: SW_DPDT_x2; SW_NKK_G1xJP
SW2: SW_Reed; SW_SPST_REED_CT10-XXXX-G1
U1, U3: Teensy4.0; Teensy40
U2: OKI-78SR-5; Converter_DCDC_muRata_OKI-78SR_Horizontal
U4: NSL-32; Luna_NSL-32

Connections:
+3V3: C2.1, RV1.3, U1.31 (3V3), U3.31 (3V3)
/5V: C3.1, RN1.15 (R2.2), U1.33 (VIN), U2.3 (OUT), U3.33 (VIN)
/12V: D10.2 (A), R5.2, RLY1.5, RLY2.5, RLY3.5, RLY4.5, SW1.6 (C)
/A2: U1.2 (0_RX1_CRX2_CS1), U3.2 (0_RX1_CRX2_CS1)
/A3: U1.3 (1_TX1_CTX2_MISO1), U3.3 (1_TX1_CTX2_MISO1)
/A4: RN1.14 (R3.2), U1.4 (2_OUT2), U3.4 (2_OUT2)
/A5: RN1.13 (R4.2), U1.5 (3_LRCLK2), U3.5 (3_LRCLK2)
/A6: RN1.12 (R5.2), U1.6 (4_BCLK2), U3.6 (4_BCLK2)
/A7: RN1.11 (R6.2), U1.7 (5_IN2), U3.7 (5_IN2)
/A8: RN1.10 (R7.2), U1.8 (6_OUT1D), U3.8 (6_OUT1D)
/A9: U1.9 (7_RX2_OUT1A), U3.9 (7_RX2_OUT1A)
/A10: U1.10 (8_TX2_IN1), U3.10 (8_TX2_IN1)
/A11: RN1.9 (R8.2), U1.11 (9_OUT1C), U3.11 (9_OUT1C)
/A12: R2.1, U1.12 (10_CS_MQSR), U3.12 (10_CS_MQSR)
/A13: R6.1, U1.13 (11_MOSI_CTX1), U3.13 (11_MOSI_CTX1)
/A14: R4.1, U1.14 (12_MISO_MQSL), U3.14 (12_MISO_MQSL)
/A20: U1.20 (13_SCK_CRX1_LED), U3.20 (13_SCK_CRX1_LED)
/A21: C1.1, J1.3, SW2.1, U1.21 (14_A0_TX3_SPDIF_OUT), U3.21 (14_A0_TX3_SPDIF_OUT)
/A22: U1.22 (15_A1_RX3_SPDIF_IN), U3.22 (15_A1_RX3_SPDIF_IN)
/A23: U1.23 (16_A2_RX4_SCL1), U3.23 (16_A2_RX4_SCL1)
/A24: RV1.2, U1.24 (17_A3_TX4_SDA1), U3.24 (17_A3_TX4_SDA1)
/A25: U1.25 (18_A4_SDA0), U3.25 (18_A4_SDA0)
/A26: U1.26 (19_A5_SCL0), U3.26 (19_A5_SCL0)
/A27: U1.27 (20_A6_TX5_LRCLK1), U3.27 (20_A6_TX5_LRCLK1)
/A28: U1.28 (21_A7_RX5_BCLK1), U3.28 (21_A7_RX5_BCLK1)
/B21: U1.34 (VUSB), U3.34 (VUSB)
/B25: U1.30 (23_A9_CRX1_MCLK1), U3.30 (23_A9_CRX1_MCLK1)
/B26: U1.29 (22_A8_CTX1), U3.29 (22_A8_CTX1)
GND: C1.2, C2.2, C3.2, C4.1, D1.2 (K), D2.2 (K), D3.1 (K), D4.2 (A), J1.5, Q2.1 (E), Q4.1 (E), Q5.3 (C), R7.2, RLY1.2, RLY2.2, RV1.1, SW2.2, U1.1 (GND), U1.32 (GND), U2.2 (GND), U3.1 (GND), U3.32 (GND), U4.2 (K)
unnamed: D1.3 (BA), RN1.8 (R8.1)
unnamed: D1.4 (GA), RN1.7 (R7.1)
unnamed: D1.1 (RA), RN1.6 (R6.1)
unnamed: D2.3 (BA), RN1.5 (R5.1)
unnamed: D2.4 (GA), RN1.4 (R4.1)
unnamed: D2.1 (RA), RN1.3 (R3.1)
unnamed: D3.2 (A), RN1.2 (R2.1)
unnamed: C5.1, C9.2, D4.1 (K), D5.2 (A)
unnamed: C4.2, C6.1, D5.1 (K), D6.2 (A)
unnamed: C5.2, C7.1, D6.1 (K), D7.2 (A)
unnamed: C6.2, C8.1, D7.1 (K), D8.2 (A)
unnamed: C7.2, D8.1 (K), D9.2 (A)
unnamed: C8.2, D9.1 (K), Q3.3 (C), U4.4 (R)
unnamed: D10.1 (K), U2.1 (IN)
unnamed: D11.2 (A), J1.2, Q1.2 (D), RLY1.4, RLY2.4, RLY3.1, RLY4.1
unnamed: D11.1 (K), J1.1, Q1.3 (S), R9.2, RLY1.1, RLY2.1, RLY3.3, RLY4.3, SW1.5 (B)
unnamed: Q1.1 (G), R8.2, R9.1
unnamed: Q2.2 (B), R2.2
unnamed: Q2.3 (C), RLY3.2, RLY4.2
unnamed: Q3.2 (B), R1.2
unnamed: Q3.1 (E), Q5.1 (E), R8.1
unnamed: Q4.2 (B), R4.2
unnamed: C9.1, Q4.3 (C), R5.1
unnamed: Q5.2 (B), R3.2
unnamed: R6.2, U4.1 (A)
unnamed: R1.1, R3.1, R7.1, U4.3 (R)
