Hyperwiper/Hyperwiper/hardware/Hyperwiper 2020/Hyperwiper 2020.kicad_pcb

## KiCad design hardware/Hyperwiper 2020/Hyperwiper 2020.kicad_pcb (2020-07-22)

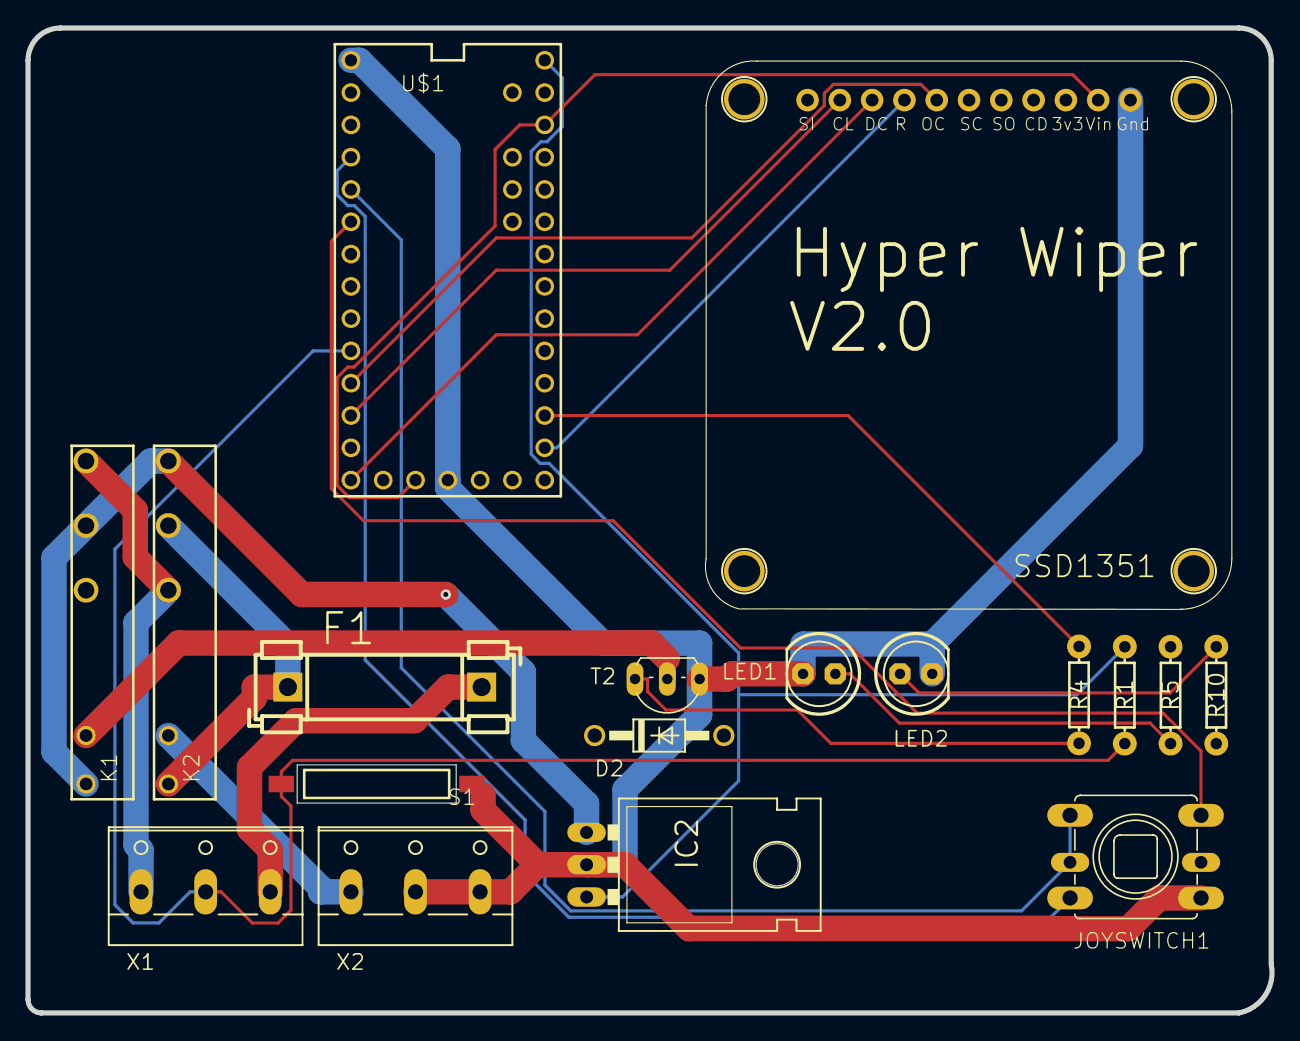
[picture p91: board Hyperwiper 2020.kicad_pcb from above]

Board: 2 copper layers, 97.8 x 77.5 mm, 18 parts (0 on the bottom side), 21 nets.

Parts:
D2: 1N4004; DO41-10
F1: FUSE; FUSE_HOLDER_5X20MM
IC2: V_REG_78XX-TO-220; TO-220-ALT
JOYSWITCH1: JoySwitch; SKQU
K1, K2: SNR?0-bGeigieNanoKit_V1.1r5a-eagle-import; SNR-V
LED1, LED2: LED5MM
R1, R4: 10k; AXIAL-0.3EZ
R5: 470; AXIAL-0.3EZ
R10: 1k; AXIAL-0.3EZ
S1: REED-Switch; CT10-A2
SSD1351: SSD1351_128X128_LCD
T2: 2SC1815; TO92-ECB
U$1: TEENSY 4; TEENSY_3.0+4
X1, X2: W237-3E

Connections:
/D2: JOYSWITCH1.DOWN, U$1.2
/D3: JOYSWITCH1.LEFT, JOYSWITCH1.UP, U$1.3
/D4: JOYSWITCH1.CENTER, U$1.4
/D8: R1.P$1 (1), S1.2, U$1.8, X1.2 (KL)
/D10: SSD1351.JP1$10 (CL), U$1.10
/VCC: SSD1351.JP1$7 (VDD), U$1.3.3V, U$1.3.3V1 (3.3V)
/VDD: IC2.OUT, R1.P$2 (2), U$1.VIN
GND: IC2.GND, JOYSWITCH1.COMMON, LED1.K (C), LED2.K (C), S1.1, SSD1351.JP1$8 (GND), T2.E, U$1.GND, U$1.GND1 (GND), X2.2 (KL), X2.3 (KL)
unnamed: IC2.IN, K1.11, K1.A1 (1), K2.14 (S)
unnamed: K1.A2 (2), T2.C
unnamed: F1.1, K2.11, K2.A1 (1)
unnamed: F1.2, X1.3 (KL)
unnamed: K1.14 (S), K2.12 (O), X1.1 (KL)
unnamed: K2.A2 (2), X2.1 (KL)
unnamed: LED1.A, R5.P$1 (1)
unnamed: LED2.A, R10.P$2 (2)
unnamed: R4.P$1 (1), U$1.15/A1
unnamed: R4.P$2 (2), T2.B
unnamed: SSD1351.JP1$1 (RST), U$1.14/A0
unnamed: SSD1351.JP1$2 (OC), U$1.9
unnamed: SSD1351.JP1$11 (DC), U$1.12
