Hyperwiper/Hyperwiper/hardware/DWP 2020/DWP 2020.kicad_pcb

## KiCad design hardware/DWP 2020/DWP 2020.kicad_pcb (2020-06-19)

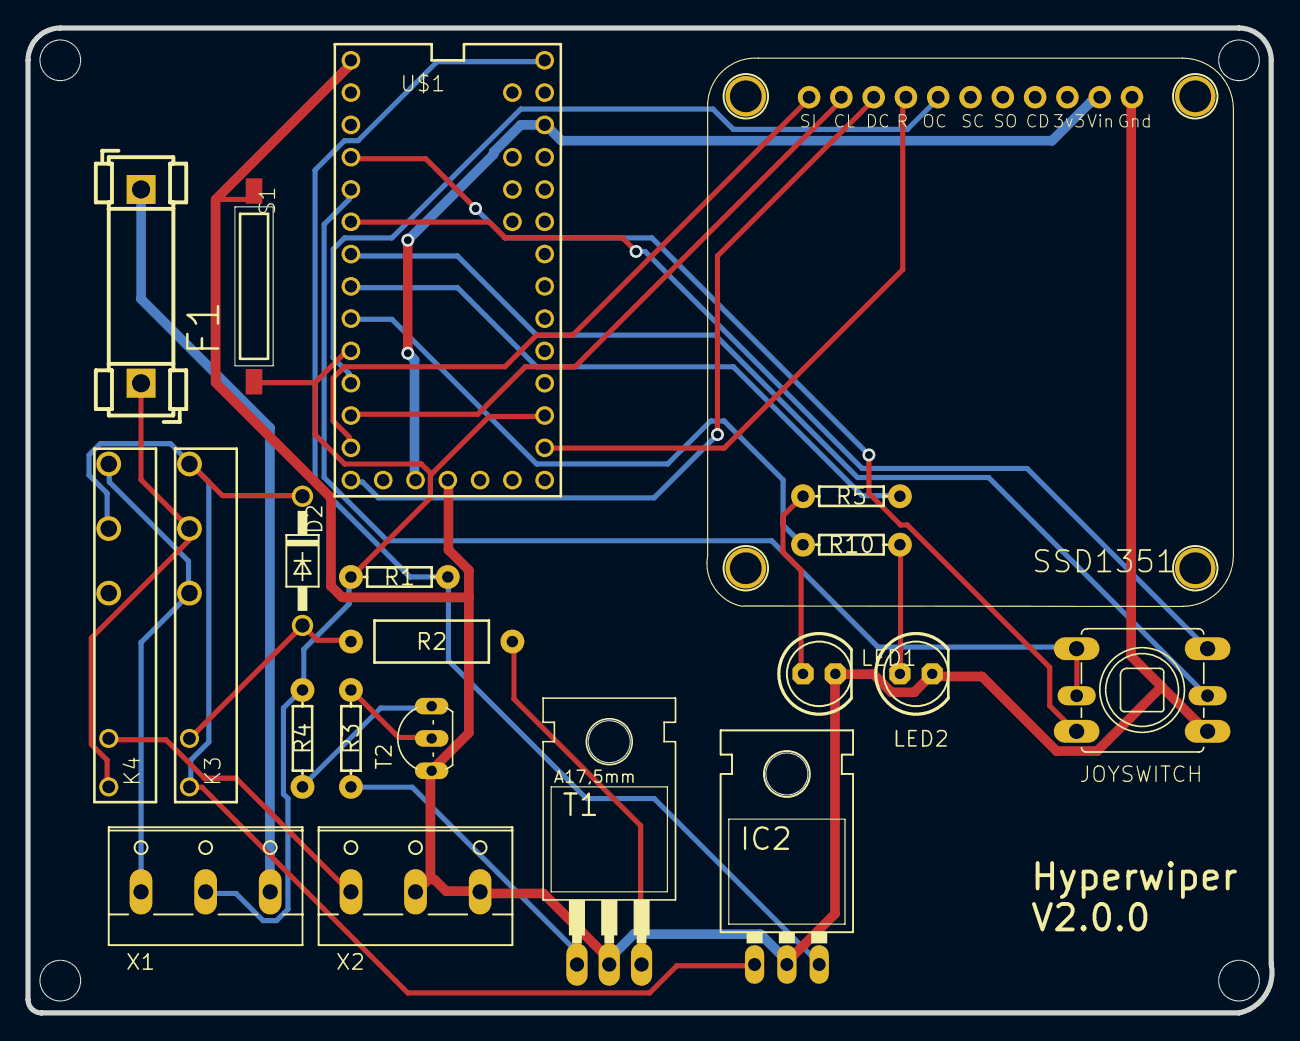
[picture p92: board DWP 2020.kicad_pcb from above]

Board: 2 copper layers, 97.8 x 77.5 mm, 26 parts (0 on the bottom side), 22 nets.

Parts:
@HOLE0, @HOLE1, @HOLE2, @HOLE3: (no value)
D2: 1N4004; DO41-10
F1: FUSE; FUSE_HOLDER_5X20MM
FRAME1: FRAME-LETTER; CREATIVE_COMMONS
IC2: TO-220-ALT
JOYSWITCH: JoySwitch; SKQU
K3, K4: SNR03005; SNR-V
LED1, LED2: LED5MM
R1, R4: 10k; AXIAL-0.3EZ
R2: 33; AXIAL-0.5
R3, R10: 1k; AXIAL-0.3EZ
R5: 470; AXIAL-0.3EZ
S1: REED-Switch; CT10-A2
SSD1351: SSD1351_128X128; SSD1351_128X128_LCD
T1: TIP32; TO220
T2: 2SC1815; TO92-ECB
U$1: TEENSY_4; TEENSY_3.0+4
X1, X2: W237-3E

Connections:
D2: JOYSWITCH.DOWN, U$1.2
D3: JOYSWITCH.LEFT, JOYSWITCH.UP, U$1.3
D4: JOYSWITCH.CENTER, U$1.4
D5: JOYSWITCH.RIGHT, U$1.5
D6: R5.P$2, U$1.6
D7: R10.P$1, U$1.7
D8: R1.P$1, R4.P$1, S1.2, U$1.8, U$1.15/A1, X1.2
GND: IC2.GND, JOYSWITCH.COMMON, LED1.K, LED2.K, S1.1, SSD1351.JP1$8 (GND), T1.2, T2.E, U$1.GND, U$1.GND1, X2.2, X2.3
unnamed: R3.P$2, T1.1
unnamed: D2.A, K3.A2, R2.P$1
unnamed: LED1.A, R5.P$1
unnamed: R3.P$1, T2.C
unnamed: F1.2, X1.3
unnamed: R4.P$2, T2.B
unnamed: R2.P$2, T1.3
unnamed: F1.1, K3.11, K4.A1
unnamed: LED2.A, R10.P$2
unnamed: K4.A2, X2.1
unnamed: K3.12, K4.14, X1.1
unnamed: D2.C, IC2.IN, K3.14, K3.A1, K4.11
VCC: U$1.3.3V, U$1.3.3V1
VDD: IC2.OUT, R1.P$2, U$1.VIN
