Hyperwiper/Hyperwiper/src/DWP.ino

/*
  Beats for Hyperwiper(University of Aizu and YR-Design) beat detection done by Julian Villagas

 - uses Teensy 4.0
 - custom board for controlling car windshield wipers.
 - instructions can be found at: Github...
 
 contact rob@yr-design.biz
 
 V2.6.6   2022-08-20 serial count display ans output changed.
 V2.6.5   2022-07-31 Tested code and changed output from headphone only to AudioOut
 V2.6.2   2022-07-13 Reset time=po after delay is done same for time_interbeat
 V2.6.1   2022-07-12 Updated many file and started using VSCode instead of VSCodium.  
 V2.6.0   2022-06-04 Cleanup
 V2.5.9   2022-06-01 Setup test for interbeats
 V2.5.8   2022-05-27 Disabled interbeats for testing response
 V2.5.7   2022-05-27 Disabled delay functions and disabled serial print for faster BPM
 V2.5.6   2021-10-27 Test version send to Aizu by Rob 
 V2.5.5   2021-10-24 Debugging the in between beat pulses code with disbaling some parts  of the code.
 V2.5.4   2021-10-23 Debugging code for interbeat pulses.
 V2.5.2   2021-10-19 Switched to all relays.
 V2.5.1   2021-09-30 Added proper MOSFET switching log and disabled the MOSFET in software for faster deployment of interbeat tests.
 V2.5.0   2021-08-12 Switched to use relays again(now double relays)
 V2.4.5   2021-06-17 Test for better timing of beats with serial plotter.
 V2.4.4   2021-06-13 Switched pot back to pin 17 for other units.
 V2.4.3a  2021-06-13 Moved pot from pin 17 to pin 16 on "broken" teensy (had pin 17 burned out") to use for testing and rewires the board.
 V2.4.3   2021-06-05 Changed the inter beat setup. Works now correctly
 V2.4.2   2021-06-03 Switched code to be used with N-Channel MOSFET IRF3205
 V2.4.1   2021-05-27 Updated hardware board for IRF3205
 V2.3.3   2021-05-13 Setup for in between full wiper moves accent of beat
 V2.3.2   2021-05-05 Fixed PWM issue and delay issues
 V2.3.1   2921-05-05 Update version numbering
 V2.3.0   2021-05-05 Beat detection not locking up (need still PWM going)
 V2.2.9   2021-03-19 Moved pot delay timing from run routine to between the beat detections and run motor routine
 V2.2.8   2021-03-18 Code fixing for start/stop start bug
 V2.2.7   2021-02-13 Cleaned up code.
 V2.2.6   2021-02-13 Changed schematic Kicad to MOSFET only.
 V2.2.5   2021-02-09 Prepare for PWM and MOSFETS for controling power
 V2.2.4   2021-01-07 Mapped the pot meter for timing of one beat 60-130BPM
 V2.2.3   2021-01-04 Fixed code for correctly pot meter change reading.
 V2.2.2   2021-01-04 Remove code for wipe test at startup and added pot delay for run_motor function.
 V2.2.1   2020-12-32 Modified reyurn wiper magnet code
 V2.2.0   2020-12-31 Added stoptime after wiper passes magnet switch on return pass
 V2.1.9   2020-12-21 Audiomix disabled and pot level detect adjusted.
 V2.1.8   2020-12-12 Updated beat LED displaying and level addjusted for dispayling serial out.
 V2.1.7   2020-12-10 Started beat timing array construction.
 V2.1.6   2020-12-07 Longer displaying beat detection in loop.
 V2.1.5   2020-12-07 Fixed stop motor after returning wiper delay.
 V2.1.4   2020-12-07 Fixe d startup bug that would not allow to function to be called before setup.
 V2.1.3   2020-12-06 Setup for calculate one full test wipe.
 V2.1.2   2020-12-05 Setup for potmenter halving the wipe time
 V2.1.1   2020-11-18 Added start_motor_reach_magnet timeing 
 V2.1.0   2020-10-24 Made minloop longer for easier checking and 
 V2.0.9   2020-10-20 Updated for tests for magnet timing/leaving variables.
 V2.0.8   2020-10-17 intergrated lastest beat detection from Julian and Camilo
 V2.0.7   2020-10-08 added test for startup calculating the startup delay and storing in EEPROM
 V2.0.6   2020-17-09 added debouncer for cleaner signal of red switch
 V2.0.5   2020-13-09 pin assigned for other pins
 V2.0.4   2020-09-11 pin assigned for RGB LEDs
 V2.0.3   2020-08-19 changed pins for production prototype setup.
 V2.0.2   2020-07-29 disabled joy switches, disable screen
 V2.0.1   2020-06-22 rotate the screen 180 degree
 V2.0.0   2020-06-08 reflected hardware changes for Teensy 4
 V1.2.6   2020-06-05 setup for Teensy 4
 V1.2.5   2015-07-26 made setup switchable
 V1.2.4   2015-07-26 enable setup mode 
 V1.2.3   2015-07-26 added delay for magnet to stop
 V1.1.9   2015-07-25 removed magnet pin and replaced with open collector 2SC1815 over stop switch
 V1.1.8   2015-07-24 management delay start function improve
 V1.1.7   2015-07-24 improve motor stop switch
 V1.1.6   2015-07-24 EEPROM read/write trigger levels
 V1.1.5   2015-07-23 joy switch up/down trigger level setup
 V1.1.4   2015-07-23 Added magnet delay
 V1.1.3   2015-07-23 setup magnetic switch delay
 V1.1.2   2015-07-12 cleanup display
 V1.1.1   2015-07-11 reassigned pins for audio board and joystick and display to work.
 V1.1.0   2015-07-9 fixed stop reset timer, setup init display.
 V1.0.9   2015-07-07 added extra joy switch buttons
 V1.00    2015-02-16 setup for output control relay on D4
 V0.99    2015-02-13 switch keys detecting 
 V0.98    2015-02-12 added LED controls and setup pins for Teensy
 V0.90    2015-02-05 init for hardware pins changes.

To be done (2022-06-04)
 Fix the delay in interbeat with new variable for millsec setup
    "delay(inter_wipe_beat_delay_time);" problems!!!!!!"


To be done (2021-03-20):
     
      -add new variables for delay_time_run in init, beatdetect part run command remove and replaced with set delay_time_run boolean, make a routine with timing in loop to let it always run though the routine to check the time and trigger the run_motor command and also set the delay_time_run boolean to false.

      - windows beats number for sliding window                      
      info: BPM should be between 60 and 130. So 1000ms till 460ms

      Done:
      - add pot timing to the beat detect/start time
      - if wiper leaves it should always diabled magnet switch for the time that the run_reed_leave_time is calculetted puls some extra (maybe 500mSec)
      - add stop motor time with the pass magnet information that is calculated from the start-motor-reach-magnet time in the setup
      - start time pulse and actual reed relay signal receiving       run_reed_leave_time
      - read potmeter value for setup delay of beat in main loop
      - convert run_reed_leave_time to half of one_wipe_time
      - acquired reed relay signal and stoptime                        return_reed_rest_time
      - Pot timing -                                                  pot_time


    setup test for getting delay of start motor and activity on magnet
    setup marker for reading the variables storage to and from eeprom and init the memory used.

    EEPROMex.h modified:
      #define EEPROMSize1k8        1080
      #define EEPROMSizeTeensy40    EEPROMSize1k8

 */

static char VERSION[] = "V2.6.6";

//set drivers 
  #include <SPI.h>
  #include <EEPROMex.h>
  #include <Bounce.h>
  #include <RGBLED.h>
  #include <FanController.h>

//audio setup
  #include <Audio.h>
  #include <Wire.h>
  #include <SD.h>

// setup for PWM 
  #define SENSOR_THRESHOLD 1000
  #define SENSOR_PIN A10 //pin IO04
  #define PWM_PIN 11 // pin D11
  #define PWM2_PIN 12 // pin D12 for 30volt power creations.
  #define motorPin 10 // pin D10 for relay

// Start init's -------------------------------------------------------------------------------------------------------------------------------------------------

//Pins setup
        int magnetPin = 14;
        // int motorPin = 15;
        int potPin=17;//normally for test units pin 17 this is only for Teensy with pin 17 burned out, probally due to touching 12V somewhere.
        unsigned potRead;
        int one_wipe_time_procentage;
        int potTime;


//display magnet info  setup 
        byte previousState = HIGH;         // what state was the button last time
        unsigned int count = 0;            // how many times has it changed to low
        unsigned long countAt = 0;         // when count changed
        unsigned int countPrinted = 0;     // last count printed
        unsigned int magnet_delay = 2000;  // delay for after starting magnet leave to prefent stopping directly after start
        boolean justStart=false;

//init variables setup
        Bounce pushbutton = Bounce(magnetPin, 10);  
        boolean motorOn= false;
        boolean magnetOn= false;
        long previousMillis = 0;
        long previousMillis_test = 0;
        long previousMillis_delay = 0;
        unsigned long previous_beatled_Millis = 0;        // will store last time LED was updated
        int beatcount =1;
        int ledState = LOW;  
        int beatPulse=0;
        int trigger_level = 0;
        long run_reed_leave_time = 0;
        long run_reed_return_time = 0;
        long minTimeSet=20000;
        float pot_old_read;
        long stop_time =0;
        int beat_array_count = 0;
        int beatPulseArray[4]={0,0,0,0};
        int inter_wipe_beat_delay_time=250; //250msec 1/4 of a sec
        bool beatdetected=false;
        unsigned long time_pot = 0;
        unsigned long time_interbeat = 0;


      //EEPROM setup
        const int maxAllowedWrites = 80;
        const int memBase          = 120;
        int addressLong;
        int runpassed_interval= 180;
        boolean setupmode = false;

      //RGB LED pins setup
        RGBLED rgbLedBeat(2,3,4,COMMON_CATHODE);
        RGBLED rgbLedMotor(5,6,9,COMMON_CATHODE);

      // Initialize library
        FanController fan(SENSOR_PIN, SENSOR_THRESHOLD, PWM_PIN);
        FanController fan2(SENSOR_PIN, SENSOR_THRESHOLD, PWM2_PIN);

      //Audio setup
        AudioInputI2S       audioInput;
        AudioOutputI2S      audioOutput;

        AudioMixer4         monoMix;
        AudioFilterBiquad   LPfilter;
        AudioAnalyzeFFT1024  myFFT;
        AudioEffectDelay    delayForL;
        AudioEffectDelay    delayForR;

        AudioConnection c0(audioInput, 0, monoMix, 0);
        AudioConnection c1(audioInput, 1, monoMix, 1);
        AudioConnection c2(monoMix, 0, LPfilter, 0);
        AudioConnection c3(LPfilter, 0, myFFT, 0);
        AudioConnection c4(audioInput, 0, delayForL, 0);
        AudioConnection c5(audioInput, 1, delayForR, 1);

        AudioConnection c6(delayForL, 0, audioOutput, 0);
        AudioConnection c7(delayForR, 0, audioOutput, 1);



      // Specify which audio card we're using
        AudioControlSGTL5000 audioShield;


      // Define global constants here
        const int myInput = AUDIO_INPUT_LINEIN; // Are we using mic or line?
        const int numReadings = 7; // How many ODFs are we using for average?
        const int noBins = 512; // number of real bins used in the FFT (total number of bins should be double this)
        const int LPorder = 7; // Linear predictor order
        // const int led = 13;
        const int ONtime_mills = 100;   // time for better delay function
        unsigned long ledStarted = 0;

        // Specify global variables here
        unsigned long curDel = 0;     // Current delay
        double avgDelay = 0.0;  // Average delay
        float prevMags[noBins][LPorder]; // Previous magnitudes for LP prediction
        double ks[LPorder]; // weights of the previous samples in the prediction of the current
        float minLevel = 20; //signal must be higher that 1% to report a beat

        unsigned int minDelay = 29;   // How long should we wait at least before the next beat?
        double lambda = .6; // weight of the median
        double alpha = .6;  // weight of the mean
        double m = 0.0;     // the mean of the previous ODFs
        double median = 0.0;     // the median of the previous ODFs
        int guess = 0;

      void lp(int k) {
        // Computes the linear prediction weights for the previous values of a given bin k
        float wk1[LPorder];
        float wk2[LPorder];
        float wkm[LPorder];

        wk1[0] = prevMags[k][0];
        wk2[LPorder - 2] = prevMags[k][LPorder - 1];

        for (int i = 1; i < LPorder - 1; ++i) {
          wk1[i] = prevMags[k][i];
          wk2[i - 1] = prevMags[k][i];
        }

        for (int i = 0; i < LPorder; ++i) {
          double num = 0.0;
          double denom = 0.0000000000000001; // to avoid NaNs

          for (int j = 0; j < (LPorder - i); ++j) {
            num += wk1[j] * wk2[j];
            denom += wk1[j] * wk1[j] + wk2[j] * wk2[j];
          }
          ks[i] = 2.0 * num / denom;

          for (int j = 0; j < i; ++j) {
            ks[j] = wkm[j] - ks[i] * wkm[i - j];
          }
          for (int j = 0; j <= i; ++j) {
            wkm[j] = ks[j];
          }
          for (int j = 0; j < (LPorder - i - 1); ++j) {
            wk1[j] -= wkm[i] * wk2[j];
            wk2[j] = wk2[j + 1] - wkm[i] * wk1[j + 1];
          }
        }
      }




// end init -------------------------------------------------------------------------------------------------------------------------------------------------

    void run_motor() {
            rgbLedMotor.writeRGB(0,255,0);//green
       //start motor     
            // fan.setDutyCycle(0); //for P-MOSFET
            digitalWrite(motorPin, HIGH); //for relay
            //Serial.println("motor_running");
    }

    void stop_motor() {

            // fan.setDutyCycle(100);//for P-MOSFET
            digitalWrite(motorPin, LOW); //for relay
            //Serial.println("motor_stopped");
    }


   void delay_run_motor(long delay_time)
      {
      // create the minimum timing for the wiper motor to wait for next beat
         unsigned long currentMillis_delay = millis();  
        while(currentMillis_delay - previousMillis_delay > (unsigned)delay_time) {
          previousMillis_delay = currentMillis_delay;  
        } 
        //run the motor
          rgbLedMotor.writeRGB(0,255,0);//green    
          // fan.setDutyCycle(0); //for P-MOSFET
          digitalWrite(motorPin, HIGH); //for relay
        motorOn= true;
      }

    void minloop(long minTime)
      {
      // create the minimum timing for the wiper motor to wait for next beat
         unsigned long currentMillis = millis();  
        if(currentMillis - previousMillis > (unsigned)minTime) {
          previousMillis = currentMillis;  
          // run motor
            rgbLedMotor.writeRGB(255,0,60); // light blue
            motorOn= true;
          // digitalWrite(motorPin, LOW);
            long runtimezero= 0;
            Serial.println("Min loop delay starts motor");
            delay_run_motor(runtimezero);
        } 
      }

 

// start setup  -------------------------------------------------------------------------------------------------------------------------------------------------
         
   void setup() {
          //serial start 
            Serial.begin(9600);
            delay(1000);
            Serial.println("Start serial");
    

          //EEPROM setup for Teensy4
            EEPROM.setMemPool(memBase, EEPROMSizeTeensy40);
            EEPROM.setMaxAllowedWrites(maxAllowedWrites);    
            addressLong   = EEPROM.getAddress(sizeof(long));
            trigger_level = EEPROM.readLong(addressLong);

          // setup pins for switches
              pinMode(motorPin, OUTPUT); //only need for relay only setup
              pinMode(magnetPin, INPUT_PULLUP);
              pinMode(potPin, INPUT);

          // Audio connections require memory to work.
          AudioMemory(150); // To Do: check the actual memory used and free the rest

          // Enable the audio shield and set the output volume.
          audioShield.enable();
          audioShield.audioPreProcessorEnable();
          audioShield.autoVolumeControl(2, 3, 0, -30, 5, 50); //enable compressor

          audioShield.inputSelect(myInput);
          audioShield.volume(0.8);  //0.8 is the max undistorted output on the headphones

          // reduce the gain on mixer channels
          monoMix.gain(0, 0.5);
          monoMix.gain(1, 0.5);

          // Butterworth filter, 12 db/octave
          LPfilter.setLowpass(0, 4000, .6);

          // Configure the window algorithm to use
          myFFT.windowFunction(AudioWindowHanning1024);

          delayForL.delay(0, 1000 * noBins / 44100);
          delayForR.delay(0, 1000 * noBins / 44100);
    
            //read potmeter 
              potRead = analogRead(potPin);

            //display status on serial
                Serial.println();
                Serial.println("-------- Set up info --------------------");
                Serial.print("Version=");
                Serial.println(VERSION);
                Serial.print("Setup Mode=");
                Serial.println(setupmode);
                Serial.print("magnetOn=");
                Serial.println(magnetOn);
                Serial.print("potential meter level =");
                Serial.println(potRead);
                Serial.println("Audio setup finished");
                Serial.println("-------- End Set up info ----------------");
                Serial.println();
                run_motor();
      delay(1000);
}

// end setup -------------------------------------------------------------------------------------------------------------------------------------------------

void loop() {


//logic for switching on the beat led only once
    unsigned long beatledMillis = millis();

    if (beatledMillis - previous_beatled_Millis >= ONtime_mills) {
      previous_beatled_Millis = beatledMillis;
      if (beatcount==1) {
        ledState=true;
        // beatcount++;
        // Serial.print ("Beat count =");
        // Serial.println(beat_array_count);
        beatcount=0;
      }else{
        ledState=false;
      }
    }

// interbeat. 
if(motorOn & beatdetected){
  //set speed to 100% duty cycle(meaning stop) and the after inter_wipe_beat_delay_time 0% dutycycle (meaning run)
  // Serial.println("interbeat start");
   //delay start of the interbeat setup with potmeter same as beat start
  //  delay(potRead);

      if(millis() >= time_pot + potRead){
        time_pot += potRead;
        digitalWrite(motorPin, LOW); //for relay
          //  fan.setDutyCycle(100);// for PWM
      }    
          time_pot = 0;
  //  Serial.println(time_pot);

      if(millis() >= time_interbeat + inter_wipe_beat_delay_time){
        time_interbeat  += inter_wipe_beat_delay_time;
        digitalWrite(motorPin, LOW); //for relay
          //  fan.setDutyCycle(100);// for PWM
          time_interbeat=0;
      }


  //  delay(inter_wipe_beat_delay_time);
  //  fan.setDutyCycle(0);// for PWM
   digitalWrite(motorPin, HIGH); //for relay
  //  Serial.println("interbeat motor start");
   beatdetected=false;
  //  minloop(minTimeSet);
}
//

//display LED beats
    if (ledState) {
        rgbLedBeat.writeRGB(255,40,0);
    }
    else{
        rgbLedBeat.writeRGB(0,0,0);
    }

 // display magnet status
  if (pushbutton.update()) {
    if (pushbutton.risingEdge()) {
      count = count + 1;
      rgbLedMotor.writeRGB(255,60,0);// magnet leaves purple
      countAt = millis();
      magnetOn= false;
    }
    
    if (pushbutton.fallingEdge()) {
        rgbLedMotor.writeRGB(0,0,255); // blue 
        magnetOn= true;
      stop_motor();
    }
  } else {
    if (count != countPrinted) {
      unsigned long nowMillis = millis();
      if (nowMillis - countAt > 50) {
        countPrinted = count;
      }
    }
  }
  // read potmeter value for setup delay of beat in main loop
      int potRead = map(analogRead(potPin), 0, 1023, 0, 1000);
      if (abs(potRead-pot_old_read)>60){
        pot_old_read=potRead;
        //convert run_reed_leave_time to half of one_wipe_time
       // one_wipe_time_procentage= potRead;
        rgbLedMotor.writeRGB(255,255,255);//white

      }
   

  // Main loop 

  // minloop timer
    minloop(minTimeSet);


  //Main audio beat detection
  double sum = 0.0;   // a float to store the sum of all the OFTs bin magnitudes
  double thr = 0.0;  // a threshold to issue a beat, e.g., a frame must be 150% louder than the average
  double psd = 0.0;  //the predicted value


  double n;         // a float for reading each FFT bin magnitude

  // is the FFT available?
  if (myFFT.available()) {

    curDel = curDel + 1;

    // update previous magnitude array
    for (int i = 1; i < LPorder; i++) {
      for (int j = 0; j < noBins; j++) {
        prevMags[j][i - 1] = prevMags[j][i];
      }
    }

    // read current magnitudes
    for (int i = 0; i < noBins; i++) {
      n = myFFT.read(i);
      prevMags[i][LPorder - 1] = n;

      lp(i); // Compute the weights for prediction

      // predict the value of this bin
      for (int j = 0; j < LPorder; j++) {
        psd += prevMags[i][j] * ks[j];
      }

      // compute the odf with spectral difference and linear prediction
      sum += abs(n - psd);
    }

    // calculate averages:
    m += ( sum - m ) / numReadings; //  running average.
    // this if implements the copysign function
    if ((sum - median) >= 0.0 ) {
      median += m / numReadings;
    } else {
      median += -m / numReadings;
    }
    //dirty median

    thr = lambda * median + alpha * m;

    if ((sum > thr) && (curDel >= minDelay) && (sum >= minLevel)) { // There's a beat
      avgDelay += ( curDel - avgDelay) / numReadings;
      curDel = 0; // restart the counter when the delay is at least the average
      // //set beat count and flash led for 1 second
        beatcount=1;
        beatdetected=true;
        beat_array_count++;

      //add delay_run_motor boolean set here delete run_motor routine

        Serial.print("count: ");
        Serial.println(beat_array_count);
      delay_run_motor(potRead);
      // run_motor();
    }

    if ((curDel >= 2.0 * round(avgDelay)) && (curDel > minDelay) && (sum >= minLevel)) { // There's a beat
      curDel = 0;
      guess = 1;
      // //set beat count and flash led for 1 second
        beatcount=1;
        beatdetected=true;
        beat_array_count++;

        Serial.print("count: ");
        Serial.println(beat_array_count);
        
        delay_run_motor(potRead);
      // run_motor();
     }
  }
    // int magnet_show =(!magnetOn*10)+5;
    // int motor_show =(motorOn*20)+10;
    // Serial.print(sum, 5);
    // Serial.print("\t");
    // Serial.print(thr, 5);
    // Serial.print("\t");
    // Serial.print(guess == 1 ? -200 : 0);
    // Serial.print("\t");
    // Serial.print(curDel == 0 ? 200 : 0);
    // Serial.print("\t");
    // Serial.print("count: ");
    // Serial.println(beat_array_count);
    // Serial.print("\t");
    // Serial.print("magnet: ");
    // Serial.print(magnet_show);
    // Serial.print("\t");
    // Serial.print("motor: ");
    // Serial.println(motor_show);
}
// end loop -------------------------------------------------------------------------------------------------------------------------------------------------
