Hyperwiper/Hyperwiper/(commit log)

2020-06-05 Teensy4 setup for VSCodium
2020-06-07 Added Kicad files
    [DWP 2020 org.kicad_pcb, DWP 2020.kicad_pcb, DWP 2020.kicad_sch]
2020-06-08 Updated Kicad schematic
    [DWP 2020.kicad_pcb, DWP 2020.kicad_sch]
2020-06-16 Updated Kcad files
    [DWP 2020.kicad_pcb, DWP 2020.kicad_sch]
2020-06-17 New Prototype board for software
    [DWP2020 prototype.kicad_pcb, DWP2020 prototype.kicad_sch]
2020-06-19 fix some typoos
    [DWP 2020.kicad_pcb, DWP 2020.kicad_sch, DWP2020 prototype.kicad_pcb, DWP2020 prototype.kicad_sch]
2020-06-20 Test for Teensy 4 pins and SSD1351
    [DWP 2015.kicad_pcb, DWP 2015.kicad_sch, DWP 2015.sch, DWP 2020.kicad_sch]
2020-06-20 Updated ProtoType drawings
    [DWP2020 prototype.dsn, DWP2020 prototype.kicad_pcb, DWP2020 prototype.kicad_sch]
2020-06-21 Updated schemtics and board
    [DWP2020 prototype.kicad_pcb, DWP2020 prototype.kicad_sch]
2020-06-24 U@dated date on prototype board
    [DWP2020 prototype.kicad_sch]
2020-07-20 Updated schematic/pcb
2020-07-22 Updated boards and libraries fro Kicad
    [DWP 2015.kicad_pcb, DWP 2015.kicad_sch, DWP 2015.sch, DWP 2020 org.kicad_pcb, DWP 2020.dsn, DWP 2020.kicad_pcb, DWP 2020.kicad_sch, DWP2020 prototype.dsn]
2020-07-22 Updated PCB
    [DWP 2020 org.kicad_pcb, DWP 2020.kicad_pcb, DWP 2020.kicad_sch, DWP2020 prototype.dsn, DWP2020 prototype.kicad_pcb, DWP2020 prototype.kicad_sch, Hyperwiper 2020.dsn, Hyperwiper 2020.kicad_pcb]
2020-07-28 Prototype production draft board.
    [Hyperwiper 2020 a.kicad_pcb, Hyperwiper 2020 production prototype.dsn, Hyperwiper 2020 production prototype.kicad_pcb, Hyperwiper 2020 production prototype.kicad_sch, Hyperwiper 2020 prototype.dsn, Hyperwiper 2020 prototype.kicad_pcb, Hyperwiper 2020 prototype.kicad_sch, Hyperwiper 2020.dsn]
2020-07-28 Updates schematic and PCB boards
    [Hyperwiper 2020 production prototype.kicad_pcb, Hyperwiper 2020 production prototype.kicad_sch]
2020-07-29 Update Schematics and PCB
    [Hyperwiper 2020 production prototype.dsn, Hyperwiper 2020 production prototype.kicad_pcb, Hyperwiper 2020 production prototype.kicad_sch]
2020-07-30 Updated darft schemetics and board.
    [Hyperwiper 2020 production prototype.kicad_pcb]
2020-07-30 Took out the joystick and display funtions.
    [Hyperwiper 2020 production prototype.kicad_pcb]
2020-07-30 Updated Schematic and board.
    [Hyperwiper 2020 production prototype.kicad_pcb, Hyperwiper 2020 production prototype.kicad_sch, SRD-05VDC-SL-C--3DModel-STEP-184599.STEP, TeensyAudioBoard.FCStd]
2020-07-31 Update Schematic and boards
    [Hyperwiper 2020 production prototype.dsn, Hyperwiper 2020 production prototype.kicad_pcb, test.kicad_pcb, test.kicad_sch]
2020-08-04 Updated boards.
    [Hyperwiper 2020 production prototype.kicad_pcb, SRD-12VDC-SL-C--3DModel-STEP-184599.STEP, Songle 12Volt.stl, Songle 12Volt_blendered.stl, TeensyAudioBoard good without extra sdcard and 2x5 pins.FCStd, TeensyAudioBoard good without extra sdcard.FCStd, TeensyAudioBoard.FCStd, songle 12Volt.FCStd]
2020-08-04 Added some mod to the 3 D audio board
    [Hyperwiper 2020 production prototype.kicad_pcb]
2020-08-09 updated kicad files with new traced board
    [Hyperwiper 2020 production prototype.dsn, Hyperwiper 2020 production prototype.kicad_pcb, Hyperwiper 2020 production prototype.kicad_sch, Hyperwiper 2020 production prototype1.step, Hyperwiper_2020_production_prototype.FCStd, Songle SDR-12Volt relay.step, Songle SRD 12Volt black.FCStd, Songle SRD-12Volt relay.FCStd]
2020-08-13 Updated boards
2020-08-15 Updated board
    [Hyperwiper 2020 production prototype.dsn, Hyperwiper 2020 production prototype.kicad_pcb, Hyperwiper 2020 production prototype.kicad_sch]
2020-08-19 Updated schematic
    [Hyperwiper 2020 production prototype.kicad_pcb, Hyperwiper 2020 production prototype.kicad_sch]
2020-09-06 Changes schemtic. Mistake in wireing
    [Hyperwiper 2020 production prototype.kicad_pcb, Hyperwiper 2020 production prototype.kicad_sch]
2020-09-10 Adde routing for the RGB leds
    [Hyperwiper 2020 production prototype.dsn, Hyperwiper 2020 production prototype.kicad_pcb, Hyperwiper 2020 production prototype.kicad_sch]
2020-09-10 Updated pin numbers
    [Hyperwiper 2020 production prototype.kicad_sch]
2020-09-11 Updated schematics
    [Hyperwiper 2020 production prototype.kicad_pcb]
2020-09-12 added tests for LEDS and updated the schematics
2020-09-12 Added flowchart drafts and modified pin number after finding conflics with the audio board I2C bus
    [Hyperwiper 2020 production prototype.kicad_pcb, Hyperwiper 2020 production prototype.kicad_sch]
2020-09-13 Assined pins and updated firmware
    [Hyperwiper 2020 production prototype.dsn, Hyperwiper 2020 production prototype.kicad_pcb, Hyperwiper 2020 production prototype.kicad_sch]
2020-09-16 Test for magnet arrving and leaving logic
2020-09-17 Added bounch for magnet sensor tests.
2020-09-18 Update schematics and started timing diagram.
    [Hyperwiper 2020 production prototype.kicad_pcb, Hyperwiper 2020 production prototype.kicad_sch]
2020-09-20 Changed motorLED LED magnet arriving and leaving
2020-09-21 Adde audio timing flow chart
2020-09-23 Updated timingplot and changed RBG LED programming
2020-10-01 added infro for Takachi case modification.
    [Takashi lid 3D.blend]
2020-10-08 Added storage setup for Teensy 4 in EEPROMex.h
2020-10-15 Upadted PlatformIO for Beat=Detection_2020 file
    [Hyperwiper 2020 production prototype.dsn, Hyperwiper 2020 production prototype.kicad_pcb]
2020-10-15 Updated deley function fix code
    [Beat_Detection2020.ino]
2020-10-18 updated code for test runs
    [Hyperwiper 2020 production prototype.step]
2020-10-18 calculate start motor to reach reedswitch time
2020-10-21 Updated code for test reruen wiper
    [Hyperwiper 2020 production prototype.kicad_pcb]
2020-10-24 Motor running from the beat beat code.
2020-10-31 Started code for missing beat detection
    [Hyperwiper 2020 production prototype.kicad_pcb]
2020-11-01 Setuo potmeter reading and pot meter timing
    [Hyperwiper 2020 production prototype.kicad_pcb]
2020-11-07 updated board and code
    [Hyperwiper 2020 production prototype.dsn, Hyperwiper 2020 production prototype.kicad_pcb, Hyperwiper 2020 production prototype.obj, Hyperwiper 2020 production prototype1.step, Hyperwiper_2020_production_prototype.FCStd, Hyperwiper_2020_production_prototype1.FCStd, hyperwiper.stl]
2020-11-09 Added diode for protection wireing of power.
    [Hyperwiper 2020 production prototype.dsn, Hyperwiper 2020 production prototype.kicad_pcb, Hyperwiper 2020 production prototype.kicad_sch, Hyperwiper_2020_production_prototype.FCStd]
2020-11-15 Updated board information
2020-11-18 Updated board for using 2x Xbee RX/TX for furure.
    [Hyperwiper 2020 production prototype.dsn, Hyperwiper 2020 production prototype.kicad_pcb, Hyperwiper 2020 production prototype.kicad_sch]
2020-11-29 updated test for checking logic
    [Hyperwiper 2020 production prototype.kicad_pcb]
2020-11-29 Updated schematic
    [Hyperwiper 2020 production prototype.dsn, Hyperwiper 2020 production prototype.kicad_pcb, Hyperwiper 2020 production prototype.kicad_sch]
2020-12-05 Updated board with Xbee's
    [Hyperwiper 2020 production prototype.dsn, Hyperwiper 2020 production prototype.kicad_pcb, Hyperwiper 2020 production prototype.kicad_sch]
2020-12-07 Updated graphics for manuscript
    [Hyperwiper 2020 production prototype.kicad_sch]
2020-12-07 Updated with startup bug fix
    [DWP.ino]
2020-12-07 Code cleanup and fixes for the stop time.
    [DWP.ino]
2020-12-07 Added orange beat LED for visual beat detection
2020-12-11 Updated board for Xbee BLE
    [Hyperwiper 2020 production prototype.kicad_sch]
2020-12-11 Updated flow chart and manuscript added
2020-12-12 Update code for beat LED display to show beats.
2020-12-12 Added 30BPM test track
2020-12-12 V2.1.8 added LED display beats
2020-12-14 Updated board with Xbee BLE setup
    [Hyperwiper 2020 production prototype.dsn, Hyperwiper 2020 production prototype.kicad_pcb, Hyperwiper 2020 production prototype.kicad_sch]
2020-12-31 Update board with caps, code: delay return wiper
    [Hyperwiper_2020_production_prototype.FCStd]
2021-01-04 Fix for reading potmeter in percentages.
    [DWP.ino]
2021-01-07 Added svg file for lasercutting the wuperlift mod
2021-01-22 Updated text on board
    [Hyperwiper 2020 production prototype.kicad_pcb]
2021-01-29 Update files
    [Hyperwiper 2020 production prototype.kicad_sch]
2021-01-29 Updated board with MOSFET IRF540N
    [Hyperwiper 2020 production prototype.kicad_pcb, Hyperwiper 2020 production prototype.kicad_sch]
2021-01-31 Updated board for MosFet
    [Hyperwiper 2020 production prototype.kicad_pcb]
2021-02-05 Updated schematic for MOSFET
    [Hyperwiper 2020 production prototype.kicad_pcb, Hyperwiper 2020 production prototype.kicad_sch]
2021-02-08 Updated board for level chnages MOSFET.
    [Hyperwiper 2020 production prototype.dsn, Hyperwiper 2020 production prototype.kicad_pcb, Hyperwiper 2020 production prototype.kicad_sch]
2021-02-13 Updated schematic to V2.1.6 (MOSFETS)
    [Hyperwiper 2020 production prototype.kicad_pcb, Hyperwiper 2020 production prototype.kicad_sch]
2021-02-13 Updated board for new layout
    [Hyperwiper 2020 production prototype.dsn, Hyperwiper 2020 production prototype.kicad_pcb, Hyperwiper 2020 production prototype.kicad_sch]
2021-02-15 fixed schematic text
    [Hyperwiper 2020 production prototype.kicad_sch]
2021-02-15 added libraries for PWM control
    [Hyperwiper 2020 production prototype.kicad_pcb, Hyperwiper 2020 production prototype.kicad_sch]
2021-02-15 Removed serial read of sensor in PWM. Not in use.
2021-03-02 kicad test
    [Hyperwiper 2020 production prototype.kicad_pcb]
2021-03-07 Modofication for board 2.2.7
    [Hyperwiper 2020 production prototype.dsn, Hyperwiper 2020 production prototype.kicad_pcb]
2021-03-18 Test for leaving wiper and double detect magnet.
2021-03-18 code fixes for start/stop/start bug . not fixed
    [DWP.ino, timing test.ino]
2021-03-19 pot delay between the beat detect and run motor
2021-03-20 added notes for start motor potmeter delay
2021-03-21 added delay_run_motor code
    [Hyperwiper 2020 production prototype.kicad_pcb]
2021-03-24 Changed for V2.3.0
    [Hyperwiper 2020 production prototype.kicad_pcb, Hyperwiper 2020 production prototype.kicad_sch]
2021-03-25 Tested PWM 100%
2021-03-27 Updated for MOSFET hookup mistake
    [Hyperwiper 2020 production prototype.dsn, Hyperwiper 2020 production prototype.kicad_pcb, Hyperwiper 2020 production prototype.kicad_sch]
2021-03-28 Fixed issue with MosFet
2021-03-28 Setup for tesing MOSFET code
2021-03-29 Code for running MOSFET
2021-04-12 Updated boards with resistor block and moved parts
    [Hyperwiper 2020 production prototype.dsn, Hyperwiper 2020 production prototype.kicad_pcb, Hyperwiper 2020 production prototype.kicad_sch]
2021-04-14 reverced the magnet logic
2021-04-15 Updated board to V2.4.0 with relay and usb out
    [Hyperwiper 2020 production prototype.dsn, Hyperwiper 2020 production prototype.kicad_pcb, Hyperwiper 2020 production prototype.kicad_sch]
2021-05-05 updated code for mosfet
    [Hyperwiper 2020 production prototype.dsn, Hyperwiper 2020 production prototype.kicad_pcb, Hyperwiper 2020 production prototype.kicad_sch]
2021-05-06 fixed schematic
2021-05-18 Updated code for better delay timing pot meter
    [Hyperwiper 2020 production prototype.kicad_sch]
2021-05-19 Test for N-ch MOSFET 100A high end
    [test N-Mosfet.kicad_pcb, test N-Mosfet.kicad_sch, test.kicad_pcb, test.kicad_sch]
2021-05-20 Updated schematic for N-CH MOSFET switching
    [Hyperwiper 2020 production prototype.kicad_pcb, Hyperwiper 2020 production prototype.kicad_sch]
2021-05-27 Updates board
    [Hyperwiper 2020 production prototype.kicad_pcb, Hyperwiper 2020 production prototype.kicad_sch]
2021-05-27 Updated board V2.4.1
    [Hyperwiper 2020 production prototype.dsn, Hyperwiper 2020 production prototype.kicad_pcb]
2021-05-31 Updated board with protection diode and fixed some routing issues.
    [Hyperwiper 2020 production prototype.dsn, Hyperwiper 2020 production prototype.kicad_pcb, Hyperwiper 2020 production prototype.kicad_sch]
2021-06-03 V2.4.2 Updated for N-Channel MOSFET controle
2021-06-05 V 2.4.3 fixed interbeat setup
    [DWP.ino]
2021-06-10 Changed LM7805 to OKI-78SR
    [Hyperwiper 2020 production prototype.kicad_pcb, Hyperwiper 2020 production prototype.kicad_sch]
2021-06-13 Updated for Hyperwiper unit that had issues with pin 17 not reading data into the Teensy
    [DWP.ino]
2021-06-14 Cleaned up code
    [Hyperwiper 2020 production prototype.kicad_pcb, Hyperwiper 2020 production prototype.kicad_sch]
2021-06-17 V2.5.4 reset minloop time after motor is stopped.
    [DWP.ino]
2021-06-17 Reset minloop after baat detected. And fixed version number to V2.4.5
    [DWP.ino]
2021-06-17 Reversed minloop timing reset at beat
    [DWP.ino]
2021-06-18 Updated Schematic for V2.4.5 diodes drop.
    [Hyperwiper 2020 production prototype.kicad_sch]
2021-07-29 Updated for dual relays and no MOSFET
    [Hyperwiper 2020 production prototype.dsn, Hyperwiper 2020 production prototype.kicad_pcb, Hyperwiper 2020 production prototype.kicad_sch]
2021-08-12 Switched code for realy using
    [Hyperwiper 2020 production prototype.dsn, Hyperwiper 2020 production prototype.kicad_pcb, Hyperwiper 2020 production prototype.kicad_sch]
2021-08-12 Update header infor for relays.
2021-08-14 new idea for MOSfet use
    [Hyperwiper 2020 production prototype.kicad_sch]
2021-08-22 Updated board layout for use of MOSFET and relays. Setup for separate Teensy and Audio board (easy exchangable)
    [Hyperwiper 2020 production prototype.kicad_pcb, Hyperwiper 2020 production prototype.kicad_sch]
2021-08-24 Routed the new board
    [Hyperwiper 2020 production prototype.dsn, Hyperwiper 2020 production prototype.kicad_pcb, Hyperwiper 2020 production prototype.kicad_sch]
2021-08-25 Added extra transitor
    [Hyperwiper 2020 production prototype.dsn, Hyperwiper 2020 production prototype.kicad_pcb, Hyperwiper 2020 production prototype.kicad_sch]
2021-08-28 Added transsitor to 30V multiplier.
    [Hyperwiper 2020 production prototype.kicad_sch]
2021-08-29 added new Gerber files
    [Hyperwiper 2020 production prototype-B_Cu.gbr, Hyperwiper 2020 production prototype-B_Mask.gbr, Hyperwiper 2020 production prototype-B_Paste.gbr, Hyperwiper 2020 production prototype-B_Silkscreen.gbr, Hyperwiper 2020 production prototype-Edge_Cuts.gbr, Hyperwiper 2020 production prototype-F_Cu.gbr, Hyperwiper 2020 production prototype-F_Mask.gbr, Hyperwiper 2020 production prototype-F_Paste.gbr]
2021-09-21 Updated files
    [Hyperwiper 2020 production prototype.kicad_pcb]
2021-09-23 Updated board with fixed ground issue between the two transistors.
    [Hyperwiper 2020 production prototype.kicad_pcb, Hyperwiper 2020 production prototype.kicad_sch]
2021-09-26 Updated PWM2 code for generating 30V for N-Mosfet to be switched on/off
2021-09-27 Added text for new port for PWM1
    [Hyperwiper 2020 production prototype.kicad_pcb, Hyperwiper 2020 production prototype.kicad_sch]
2021-09-29 Updated board for footprint mistake relays.
    [Hyperwiper 2020 production prototype.dsn, Hyperwiper 2020 production prototype.kicad_pcb, Hyperwiper 2020 production prototype.kicad_sch]
2021-09-30 Added new schematic for proper MOSFET switching
    [Hyperwiper 2020 production prototype.dsn, Hyperwiper 2020 production prototype.kicad_pcb, Hyperwiper 2020 production prototype.kicad_sch]
2021-09-30 Disbaled MOSFET in code. And disabled 30V power.
2022-04-19 Added Hall sensor
    [Hyperwiper 2020 production prototype.kicad_pcb, Hyperwiper 2020 production prototype.kicad_sch]
2022-05-27 Disabled delay and serial prints for faster beat detection
    [Hyperwiper 2020 production prototype.kicad_pcb]
2022-07-04 Suggested fix for bad delay function that wa s introduced for testing and implemented correctly
    [DWP.ino]
2022-07-05 Tested delay replacement funtions
    [DWP.ino, Delay funtion test in loop.ino]
2022-07-05 Confirmed hall mems sensor setup (for fufture use)
    [Hyperwiper 2020 production prototype.kicad_pcb]
2022-07-10 Added data sheet for Hall sensor
2022-07-10 Small changes board
2022-07-13 120BPM test running track
2022-07-13 disbaled serial prints
2022-07-19 Updated platformio.ini
    [Hyperwiper 2020 production prototype.kicad_sch]
2022-07-28 Chnaged code to output to headphones and line out L and R
    [Hyperwiper 2020 production prototype.kicad_pcb]
2022-08-03 Updated board with Mens sensors for better magnet detetion
    [Hyperwiper 2020 production prototype.kicad_pcb, Hyperwiper 2020 production prototype.kicad_sch]
2022-08-03 Updated versions on schematic and board
    [Hyperwiper 2020 production prototype.kicad_pcb, Hyperwiper 2020 production prototype.kicad_sch]
2022-08-20 Reset led
2022-08-20 Switch of Led after detection
